AmbireTech/ice/art/directions.png

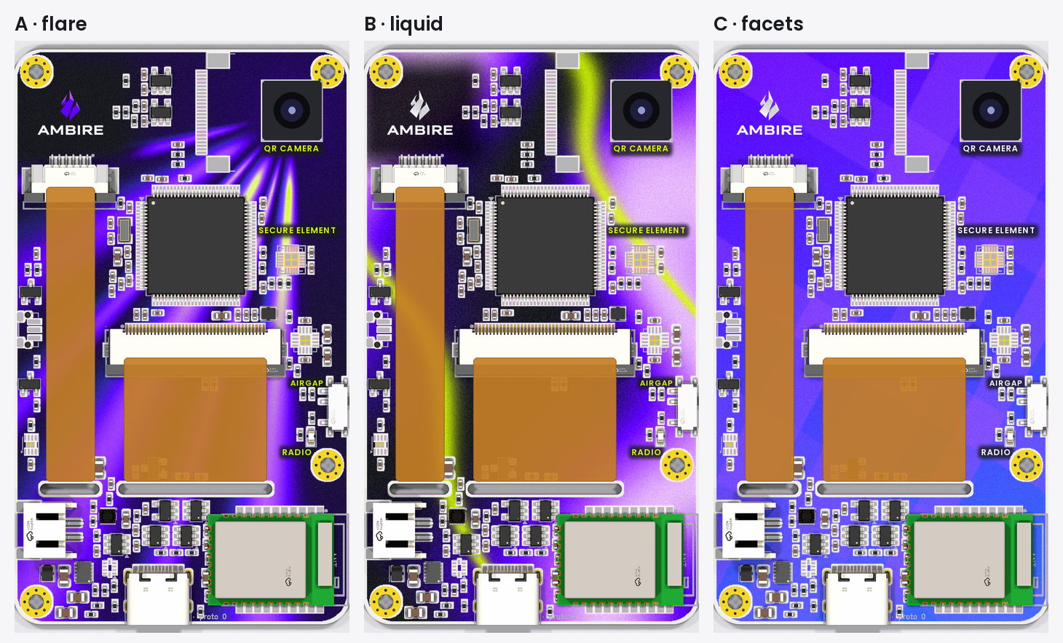
art/directions.png
