AmbireTech/ice/art/preview_back.png

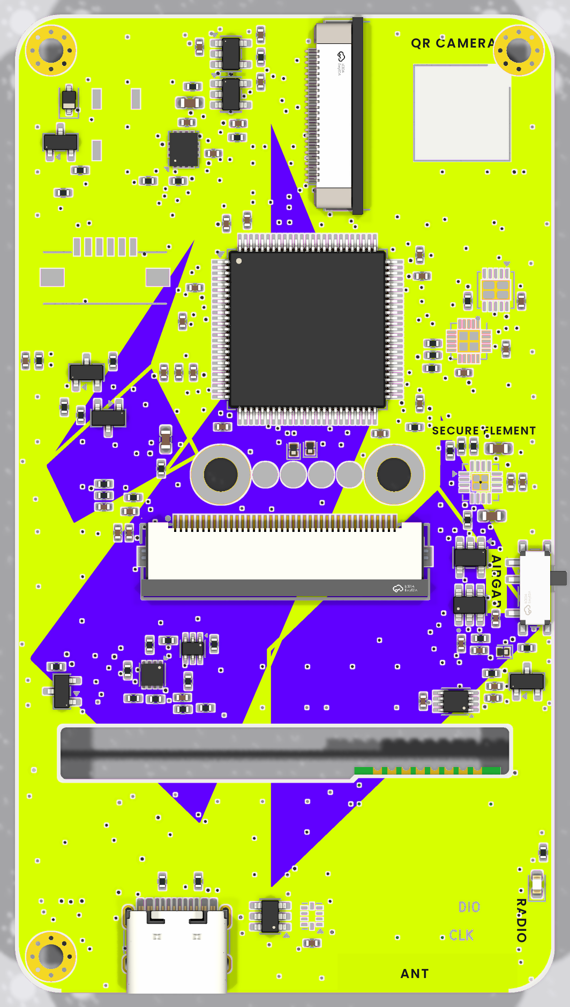
art/preview_back.png
