AmbireTech/ice/art/schemes.png

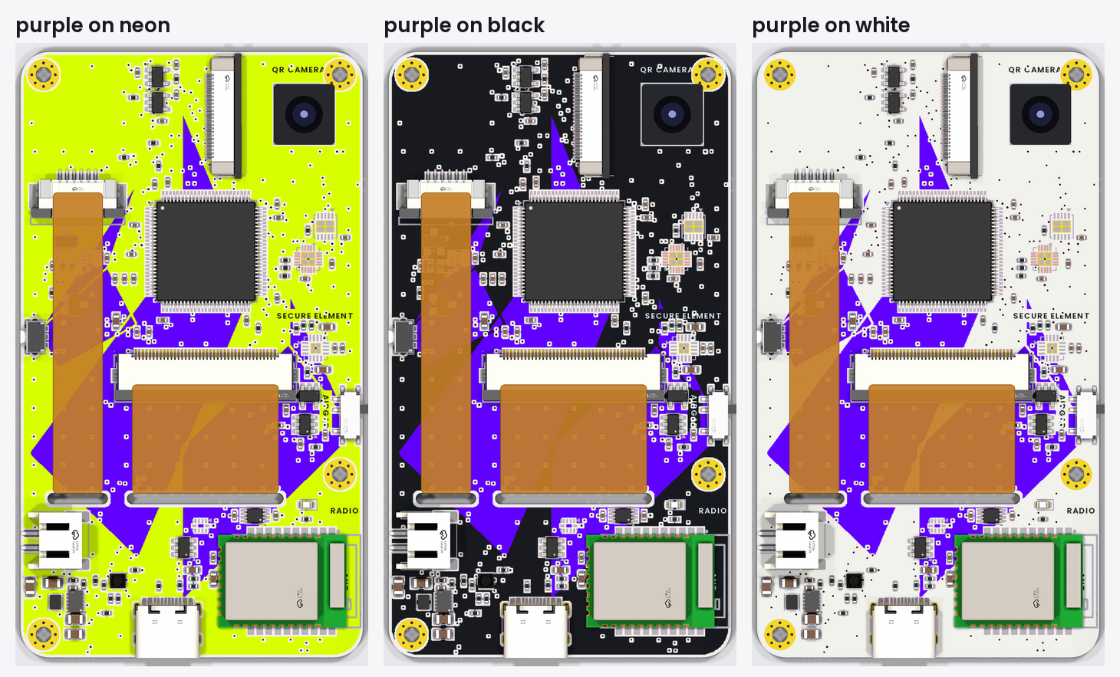
art/schemes.png
