AmbireTech/ice/docs/back-face-render.png

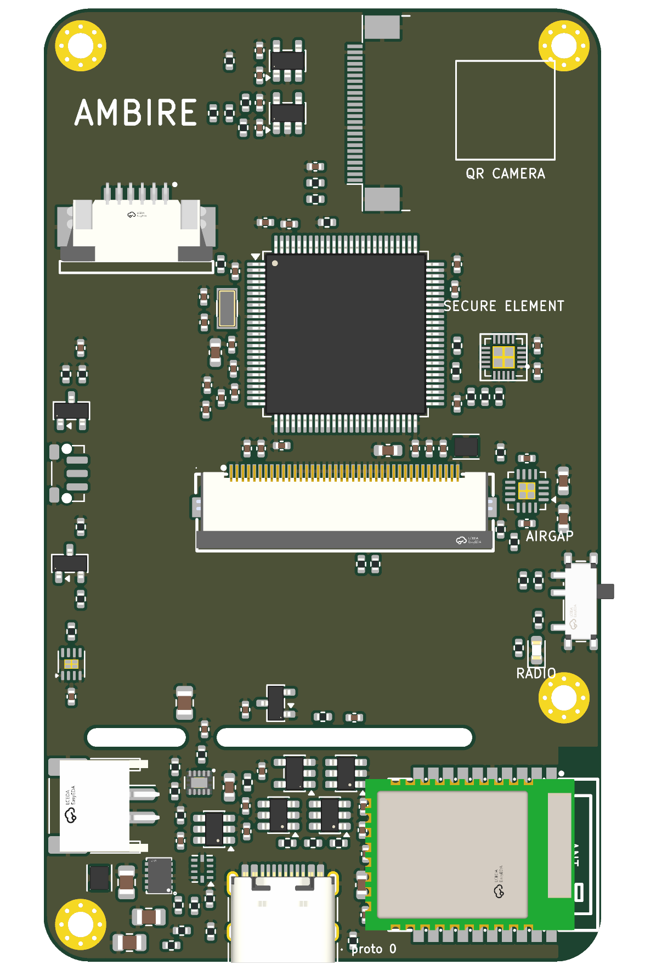
docs/back-face-render.png
