AmbireTech/ice/docs/back-face-uv.jpg

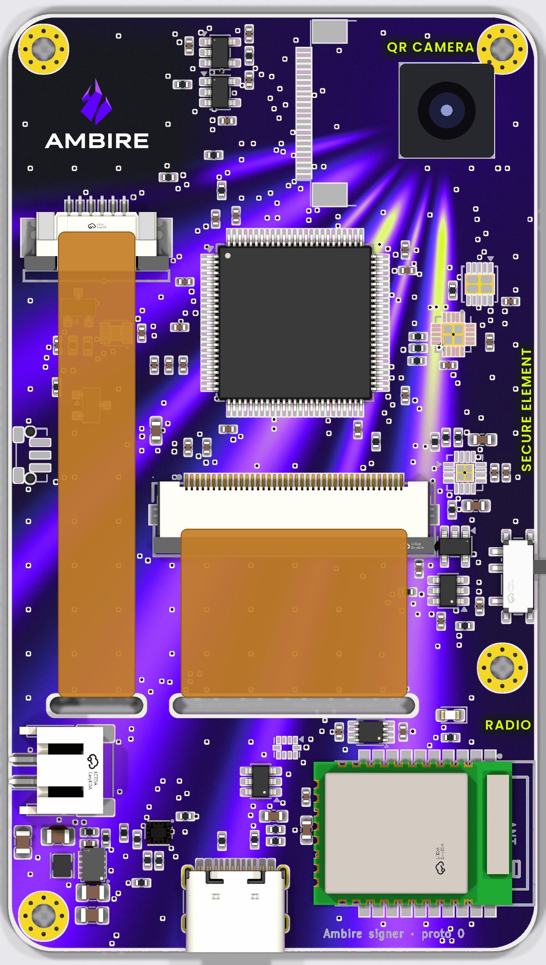
docs/back-face-uv.jpg
