AmbireTech/ice/docs/enclosure/board-back.jpg

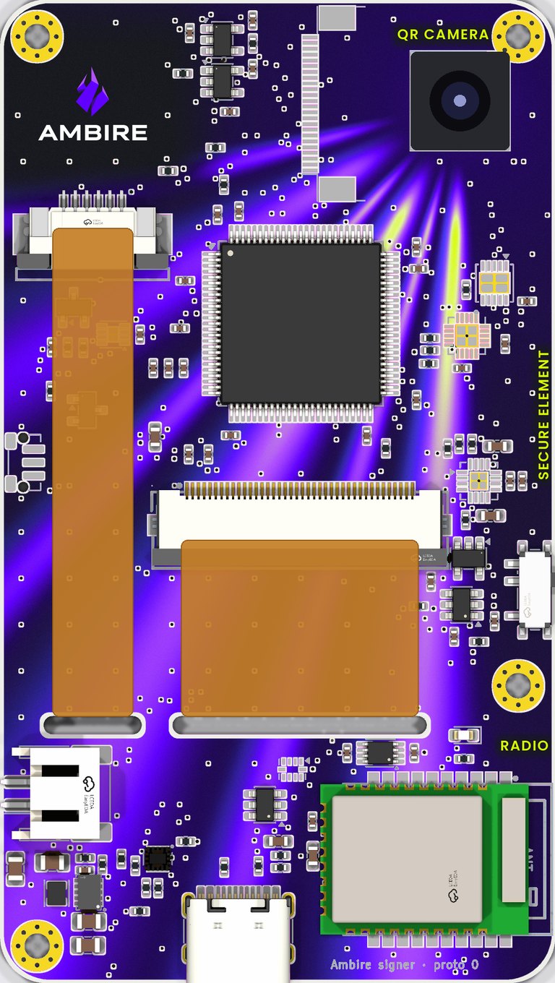
docs/enclosure/board-back.jpg
