AmbireTech/ice/docs/v4/brand/signer.webp

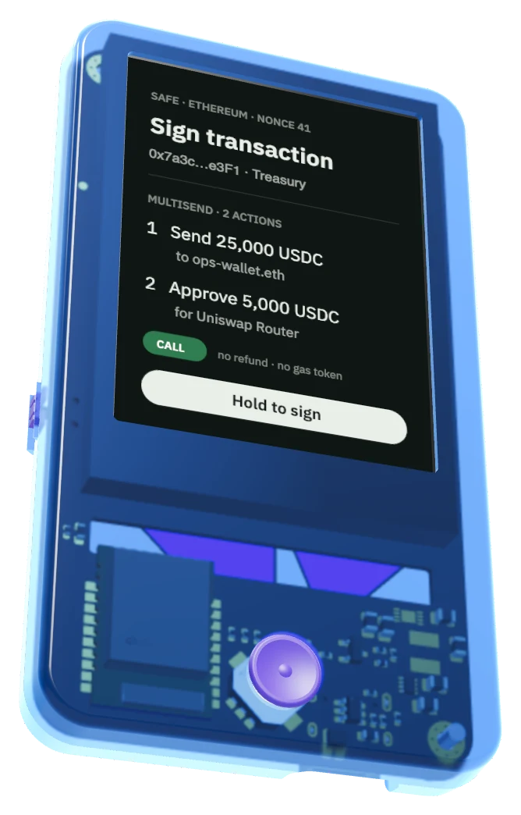
docs/v4/brand/signer.webp
