AmbireTech/ice/docs/v4/brand/silk-hero.jpg

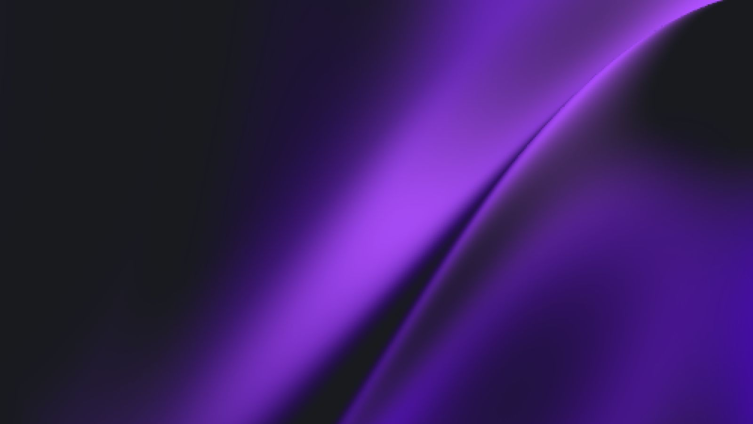
docs/v4/brand/silk-hero.jpg
