AmbireTech/ice/docs/v4/brand/silk-volt.jpg

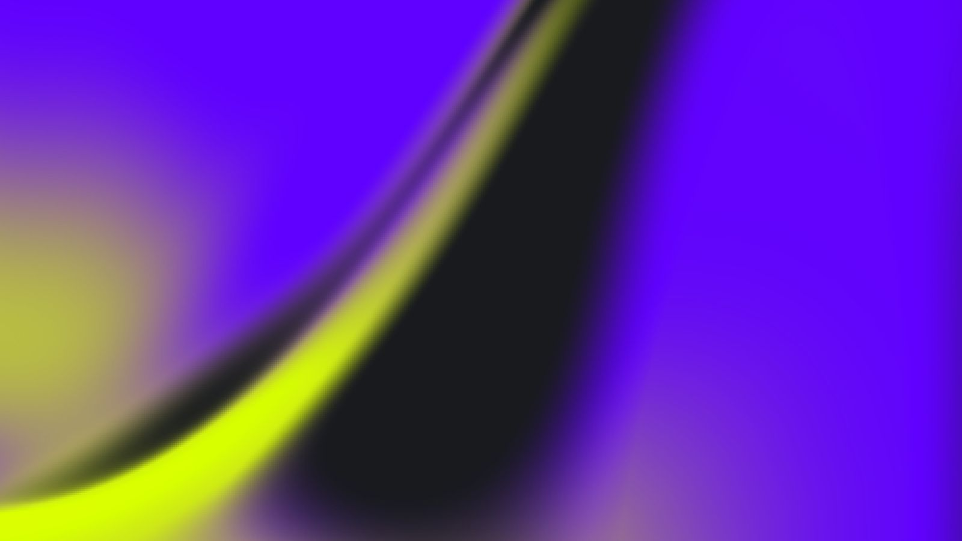
docs/v4/brand/silk-volt.jpg
