AmbireTech/ice/production/order/pcbway/ORDER-NOTES.txt

Ambire Ice proto 1 - PCBWay order notes
==========================================

PCB (upload wallet_pcbway_fab.zip)
  Layers 4 | 48.0 x 87.0 mm | thickness 1.0 mm | FR-4 | qty 10
  Surface finish: ENIG
  Solder mask: white (both sides) | silkscreen: white
  Special: full-colour UV printing on the BOTTOM side only (matte, the default)
  Min drill 0.25 mm, min track/space per the Gerbers
  Layer order: top wallet-F_Cu.gtl / wallet-In1_Cu.g1 (3.3 V plane) / wallet-In2_Cu.g2 (GND plane) /
               bottom wallet-B_Cu.gbl; outline wallet-Edge_Cuts.gm1

Tell PCBWay in the order remark
  "Full-colour UV print on the bottom side from wallet_bottom_UV_print_1200dpi.png
   (in the zip). The image covers the board outline exactly (48.0 x 87.0 mm), viewed
   from the bottom, not mirrored; see wallet_UV_positioning.png. Transparent =
   no ink. Print the bottom white silkscreen Gerber as usual; the image already
   leaves pads and holes clear. Top side: normal white silkscreen, no UV print."

Assembly (turnkey, both sides: 112 bottom + 31 top (C_3V3, C_BAT, C_BOOST, C_BOOST2, C_FFB, C_IN_BOOST, C_RADIO1, C_RADIO2, C_USB3V3, C_VBUS, L_BOOST, L_BUCK, Q_PWRJ, R_FB1, R_FB2, R_FBU1, R_FBU2, R_JA, R_JB, R_JC, R_JD, R_JPU, R_PG, R_PGB, R_PWRJB, R_PWRJBE, SW_JOY, U10, U11, U2, U3), 143 placements, 65 BOM lines)
  BOM:      wallet_bom-pcbway.csv  (manufacturer + MPN; LCSC code as distributor PN)
  Centroid: wallet_centroid-pcbway.csv  (mm, origin = outline bottom-left, as the
            Gerbers; Layer column per part; rotation in KiCad's convention, parts on the
            bottom given as seen from the top; please check orientation against
            the Gerbers / pin-1 marks)
  Not assembled (fitted by hand): PANEL (NHD-2.4-240320AF-CSXP-CTP); CAMERA (Camemake CM_DVP_GC2145_UNIVERSAL (GC2145 24-pin DVP module)); CELL (one AAA cell (NiMH, alkaline or lithium primary))

Sourcing warning
  U16 SLS32AIA010MKUSON10XTMA2: JLC/LCSC says "This product is no longer manufactured."
  Confirm availability with PCBWay or DNP these and fit later.
