AmbireTech/ice/production/jig-order/jig_bom-jlc.csv

Comment | Designator | Footprint | LCSC Part #
10uF | C_3V3P,C_TGT,C_VBUS | C_0603_1608Metric | C19702
100nF | C_AV,C_DV23,C_DV50,C_FL,C_IO1,C_IO10,C_IO22,C_IO33,C_IO42,C_IO49,C_UV | C_0402_1005Metric | C1525
1uF | C_VRI,C_VRO | C_0402_1005Metric | C52923
15pF | C_XI,C_XO | C_0402_1005Metric | C1548
USBLC6-2SC6 | D_ESD | SOT-23-6 | C7519
red | D_TGT | LED_0603_1608Metric | C2286
green | D_USB | LED_0603_1608Metric | C12624
TYPE-C-31-M-12 | J_USB | USB_C_Receptacle_HRO_TYPE-C-31-M-12_BoardEdge | C165948
YZP0063-20068-01 | P_3V3,P_GND,P_NRST,P_RSWCLK,P_RSWDIO,P_SWCLK,P_SWDIO | Xinyangze_YZP0063-20068-01 | C5157248
1k | R_BOOT,R_LT,R_LU,R_NRST,R_RSWC,R_RSWD,R_XO | R_0402_1005Metric | C11702
5.1k | R_CC1,R_CC2 | R_0402_1005Metric | C25905
100k | R_CE | R_0402_1005Metric | C25741
27 | R_DN,R_DP | R_0402_1005Metric | C25100
10k | R_RUN | R_0402_1005Metric | C25744
100 | R_SWC,R_SWD | R_0402_1005Metric | C25076
MSK12C02 | SW_PWR | SW_SPDT_Shouhan_MSK12C02 | C431540
K3-2235S-K1 | SW_SEL | SW_DPDT_Hroparts_K3-2235S-K1 | C145845
RP2040 | U1 | QFN-56-1EP_7x7mm_P0.4mm_EP3.2x3.2mm | C2040
W25Q16JVSSIQ | U2 | SOIC-8_5.3x5.3mm_P1.27mm | C131025
ME6211C33 | U_LP,U_LT | SOT-23-5 | C82942
12MHz | Y1 | Crystal_SMD_3225-4Pin_3.2x2.5mm | C20625731
