AmbireTech/ice/production/jig-order/base/jig-base_bom-jlc.csv

Comment | Designator | Footprint | LCSC Part #
SM04B-SRSS-TB | J_RAD | JST_SH_SM04B-SRSS-TB_1x04-1MP_P1.00mm_Horizontal | C160404
YZP0063-20068-01 | P_RSWCLK,P_RSWDIO | Xinyangze_YZP0063-20068-01 | C5157248
