AmbireTech/ice/docs/v4/enclosure/files/pack_bom-jlc.csv

Comment | Designator | Footprint | LCSC Part #
MY-AAA-19-J | BT_N1,BT_N2 | Battery_AAA_Clip_MYOUNG_MY-AAA-19-J | C6937104
MY-AAA-20-J | BT_P1,BT_P2 | Battery_AAA_Clip_MYOUNG_MY-AAA-20-J | C6937107
0.75A hold | F_BAT | Fuse_1206_3216Metric | C976305
YZP0048-20048-04025-03 | J_PACK | Xinyangze_YZP0048-20048-04025-03 | C5126845
10k NTC B3380 | RT_PACK | R_0603_1608Metric | C13564
1k | R_MID | R_0402_1005Metric | C11702
