AmbireTech/ice/3d/Xinyangze_YZP0063-20068-01.step

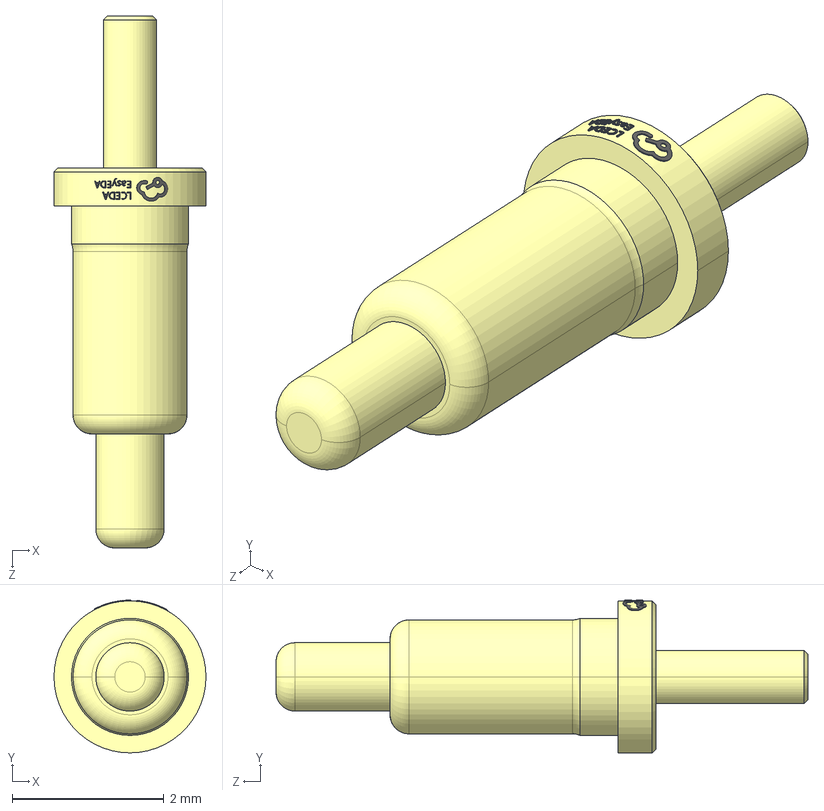
[picture p14: CAD file, 2026-11-01]
3d/Xinyangze_YZP0063-20068-01.step
2.00 x 2.01 x 7.00 mm
