AmbireTech/ice/enclosure/out/bezel.step

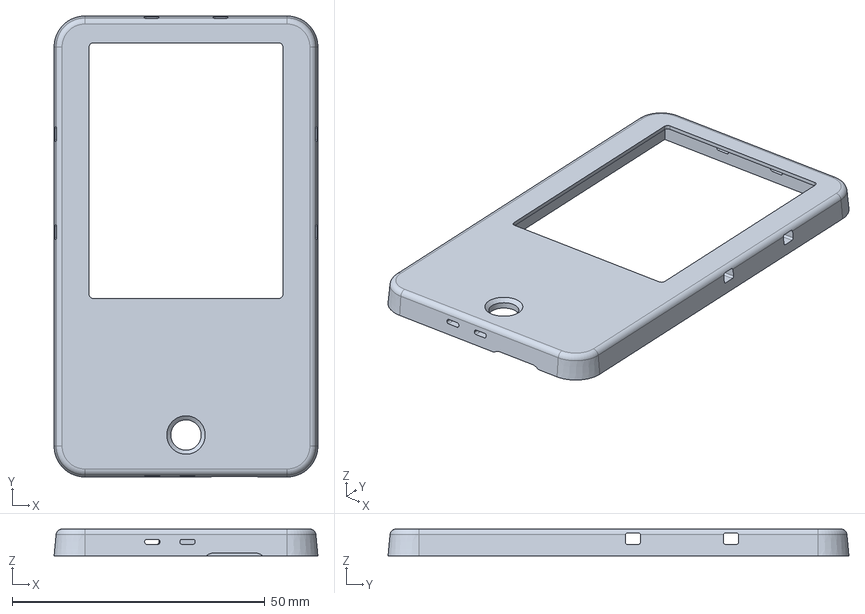
[picture p15: CAD file, 2026-11-14]
enclosure/out/bezel.step
52.2 x 91.2 x 5.33 mm
