AmbireTech/ice/jig/out/base.step

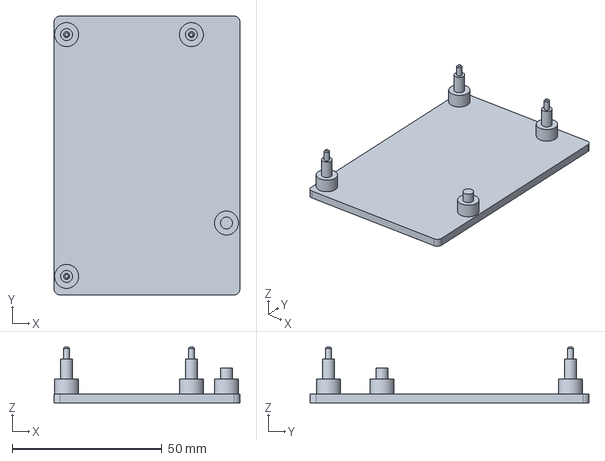
[picture p16: CAD file, 2026-11-01]
jig/out/base.step
62.0 x 93.0 x 18.6 mm
