AmbireTech/ice/pack/3d/Xinyangze_YZP0058-20048-02.step

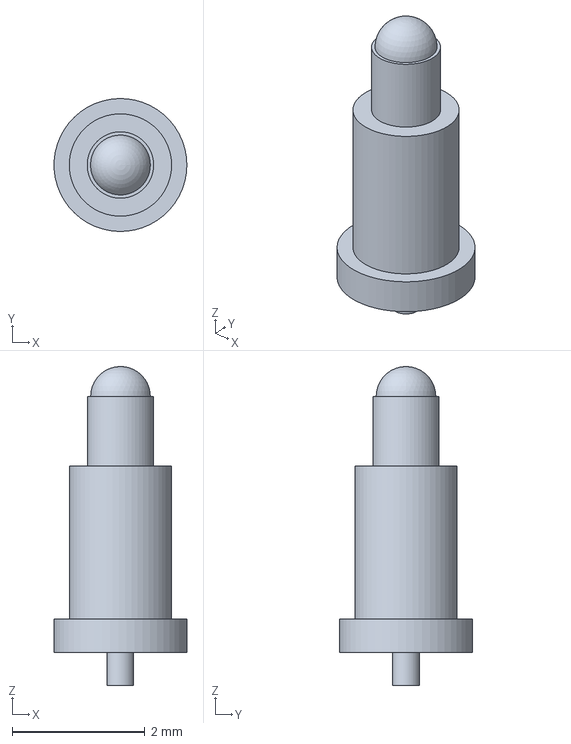
[picture p17: CAD file, 2026-11-01]
pack/3d/Xinyangze_YZP0058-20048-02.step
2.00 x 2.00 x 4.80 mm
