AmbireTech/ice/3d/MYOUNG_MY-AAA-19-J.step

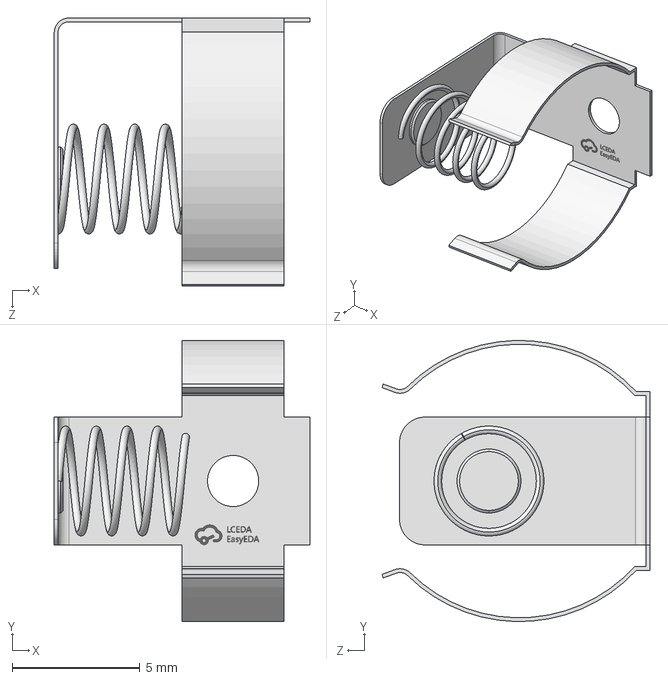
[picture p18: CAD file, 2026-10-25]
3d/MYOUNG_MY-AAA-19-J.step
10.0 x 11.0 x 10.5 mm
