AmbireTech/ice/enclosure/out/halves.3mf

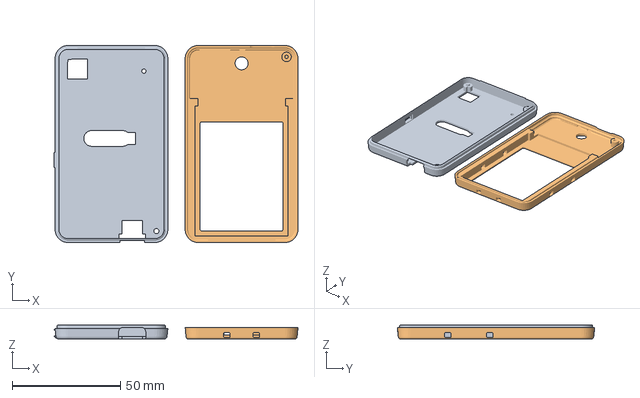
[picture p19: CAD file, 2026-11-14]
enclosure/out/halves.3mf
112.9 x 91.2 x 6.70 mm
