AmbireTech/ice/jig/out/lid.step

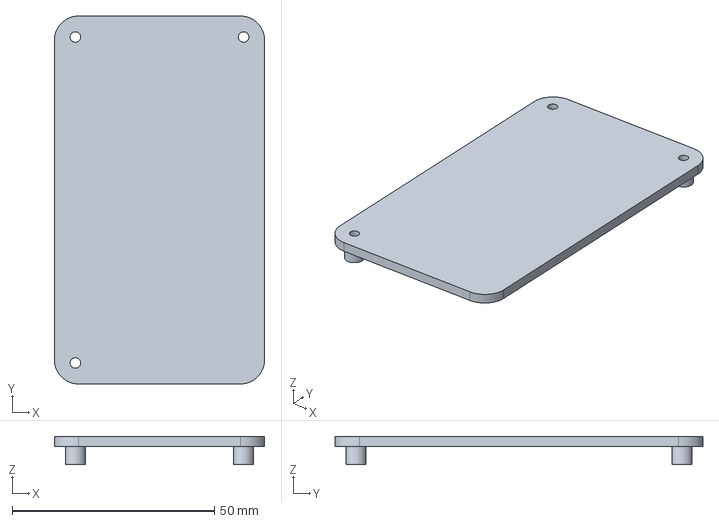
[picture p20: CAD file, 2026-11-01]
jig/out/lid.step
52.0 x 91.0 x 7.00 mm
