AmbireTech/ice/enclosure/out/case.3mf

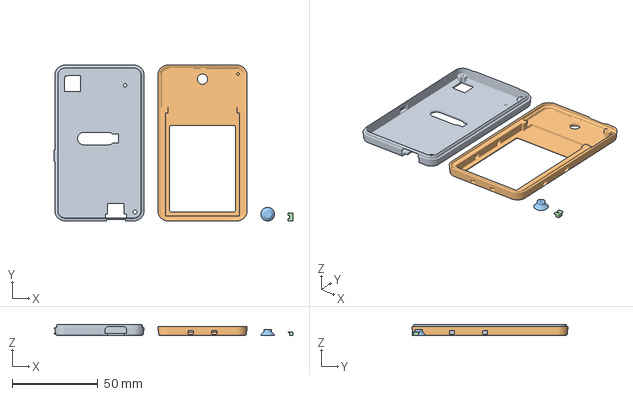
[picture p22: CAD file, 2026-11-14]
enclosure/out/case.3mf
139.7 x 91.2 x 6.70 mm
