AmbireTech/ice/3d/SW_ALPS_SKRHAAE010.step

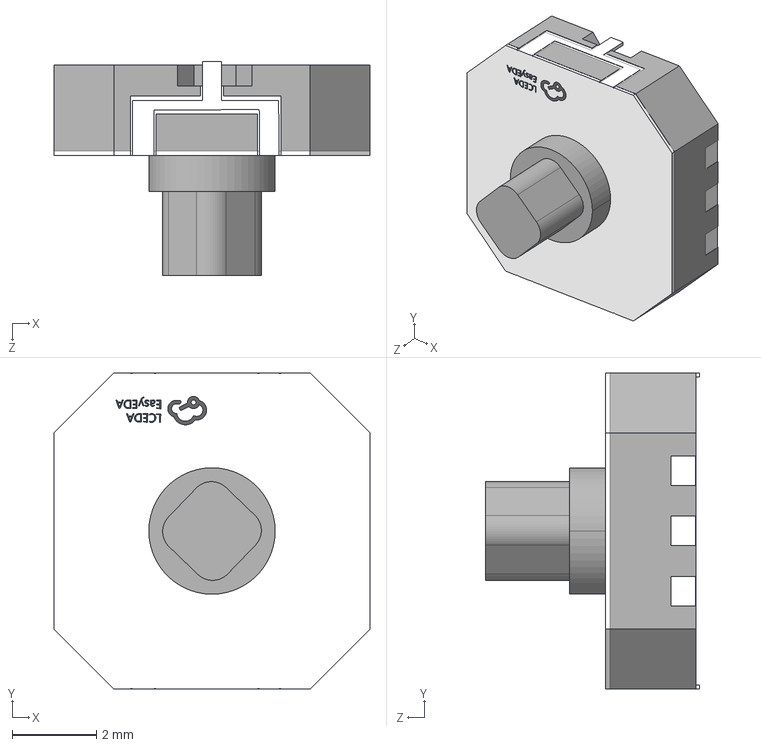
[picture p23: CAD file, 2026-10-22]
3d/SW_ALPS_SKRHAAE010.step
7.50 x 7.50 x 5.08 mm
