AmbireTech/ice/enclosure/out/shell.step

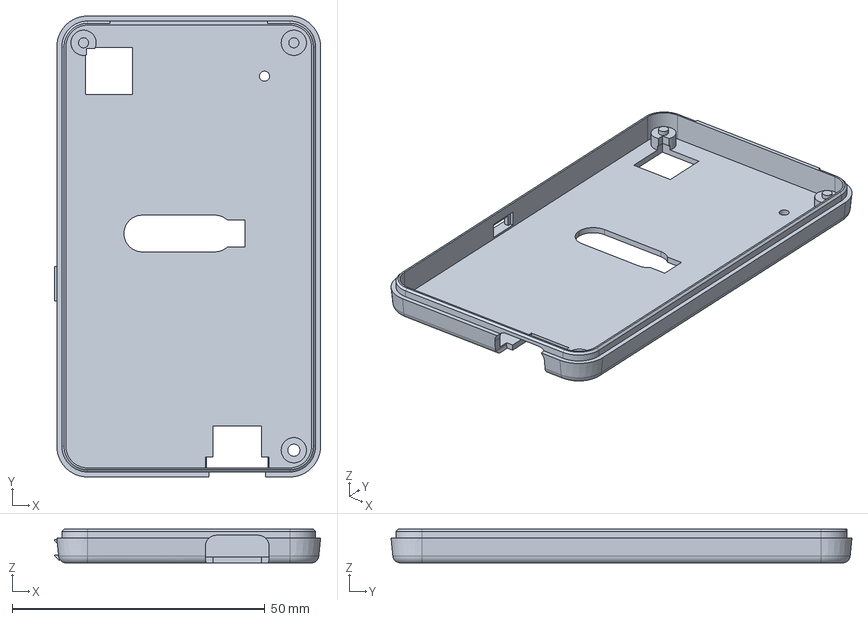
[picture p24: CAD file, 2026-11-14]
enclosure/out/shell.step
52.7 x 91.2 x 6.69 mm
