AmbireTech/ice/3d/FPC_HC-FPC-1.0-6P-CSH25.step

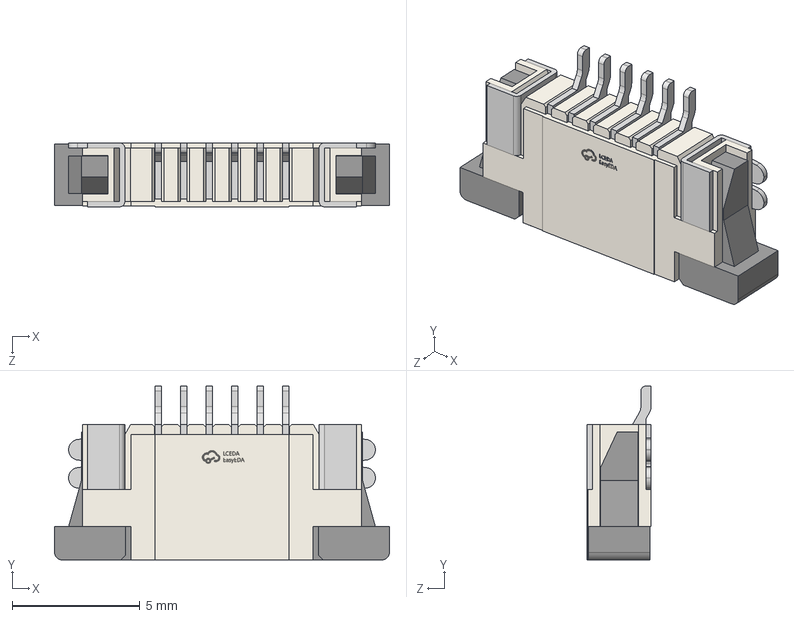
[picture p25: CAD file, 2026-10-14]
3d/FPC_HC-FPC-1.0-6P-CSH25.step
13.1 x 6.80 x 2.51 mm
