AmbireTech/ice/enclosure/out/joycap.step

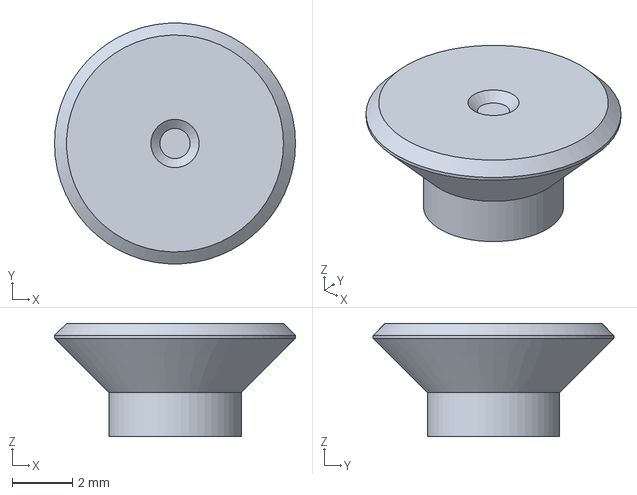
[picture p26: CAD file, 2026-11-14]
enclosure/out/joycap.step
8.00 x 7.99 x 3.76 mm
