AmbireTech/ice/3d/Molex_54132-4062.step

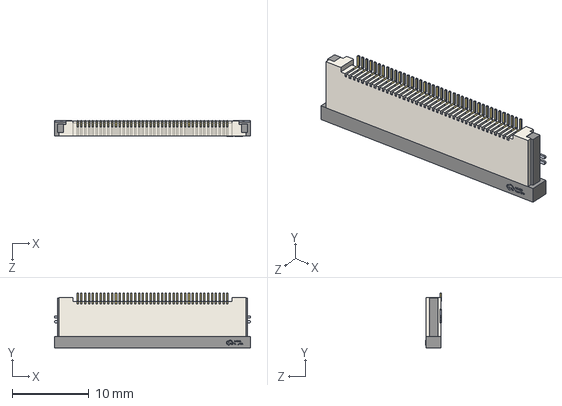
[picture p27: CAD file, 2026-10-14]
3d/Molex_54132-4062.step
25.5 x 7.15 x 2.03 mm
