AmbireTech/ice/enclosure/out/airslider.step

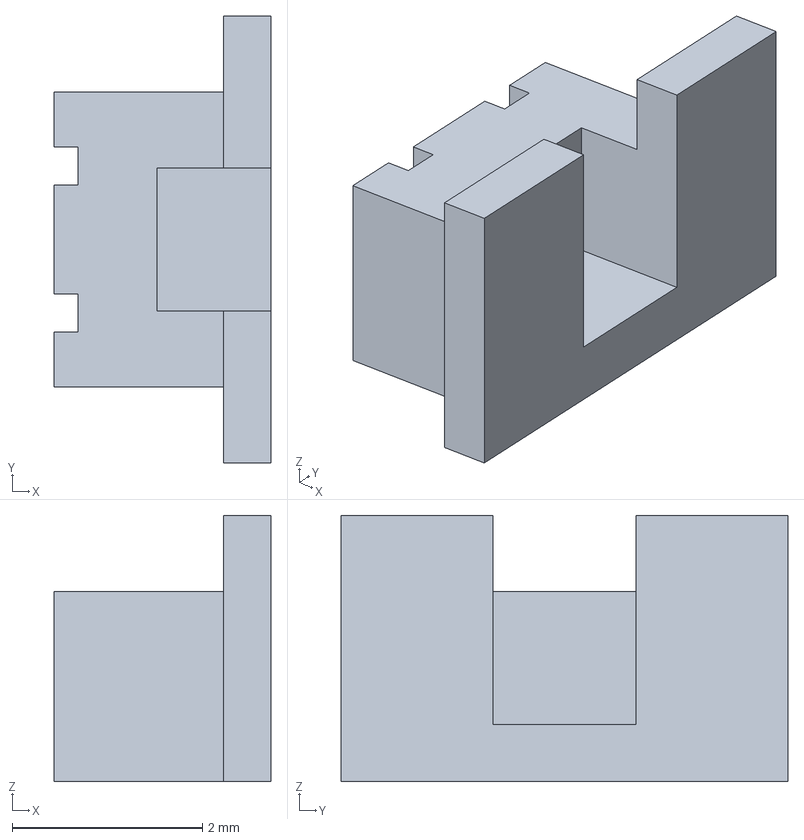
[picture p28: CAD file, 2026-11-14]
enclosure/out/airslider.step
2.28 x 4.70 x 2.80 mm
