AmbireTech/ice/enclosure/out/battery-tray.3mf

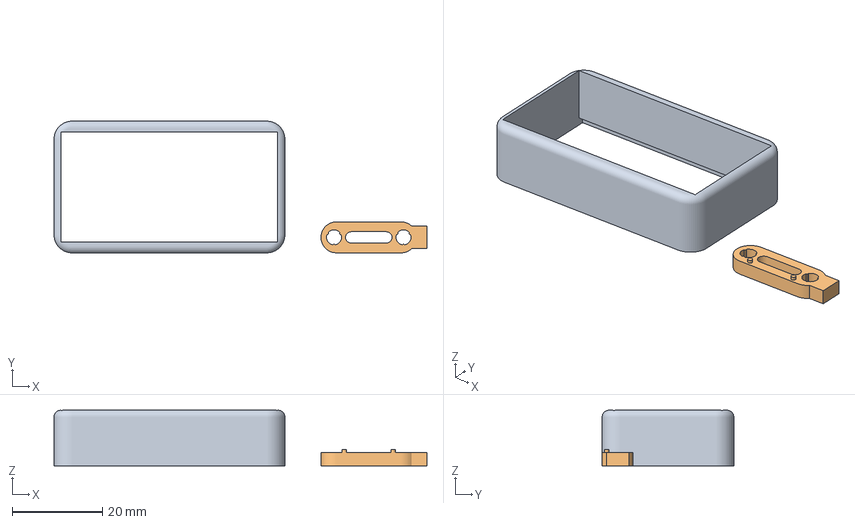
[picture p29: CAD file, 2026-11-14]
enclosure/out/battery-tray.3mf
82.7 x 29.2 x 12.3 mm
