AmbireTech/ice/enclosure/out/tray.step

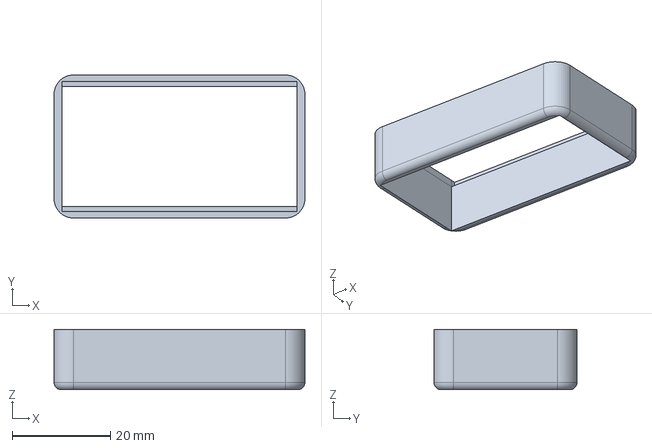
[picture p30: CAD file, 2026-11-14]
enclosure/out/tray.step
51.2 x 29.2 x 12.3 mm
