AmbireTech/ice/enclosure/out/frame.step

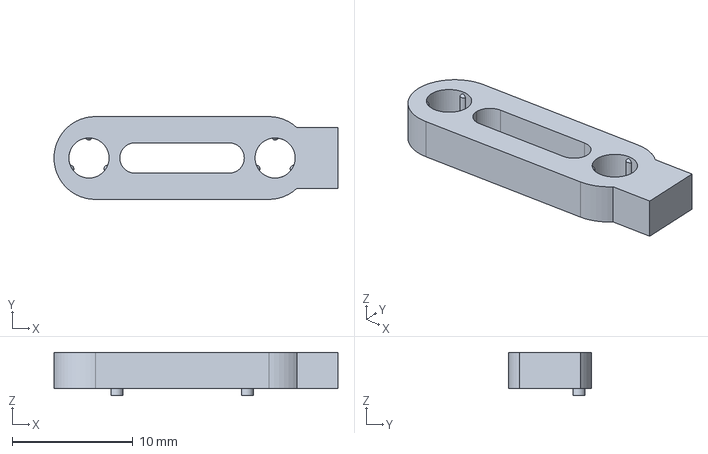
[picture p31: CAD file, 2026-11-14]
enclosure/out/frame.step
23.5 x 6.86 x 3.58 mm
