AmbireTech/ice/enclosure/out/door.step

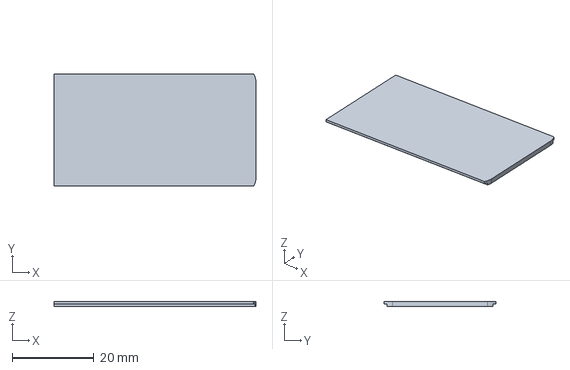
[picture p32: CAD file, 2026-10-28]
enclosure/out/door.step
49.4 x 27.5 x 1.20 mm
