AmbireTech/ice/enclosure/out/cover.step

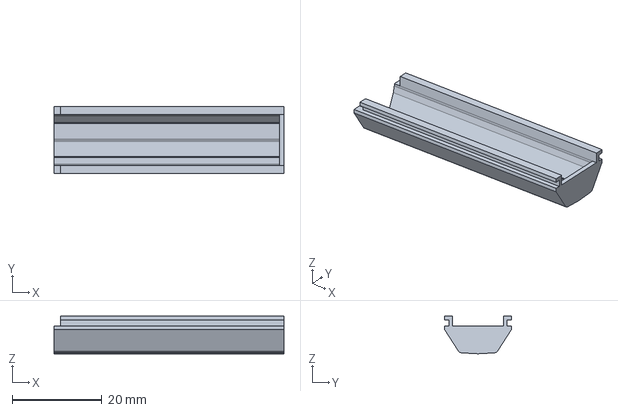
[picture p33: CAD file, 2026-10-26]
enclosure/out/cover.step
51.2 x 14.8 x 8.35 mm
