AmbireTech/ice/(list of files, cad)

Other CAD files:
enclosure/out/airslider.stl
enclosure/out/battery-tray.stl
enclosure/out/bezel.stl
enclosure/out/case.stl
enclosure/out/cover.stl
enclosure/out/door.stl
enclosure/out/frame.stl
enclosure/out/halves.stl
enclosure/out/joycap.stl
enclosure/out/shell.stl
enclosure/out/tray.stl
jig/out/base.stl
jig/out/lid.stl
