AmbireTech/ice/board/wallet.kicad_pcb

## KiCad design board/wallet.kicad_pcb (2026-11-09)

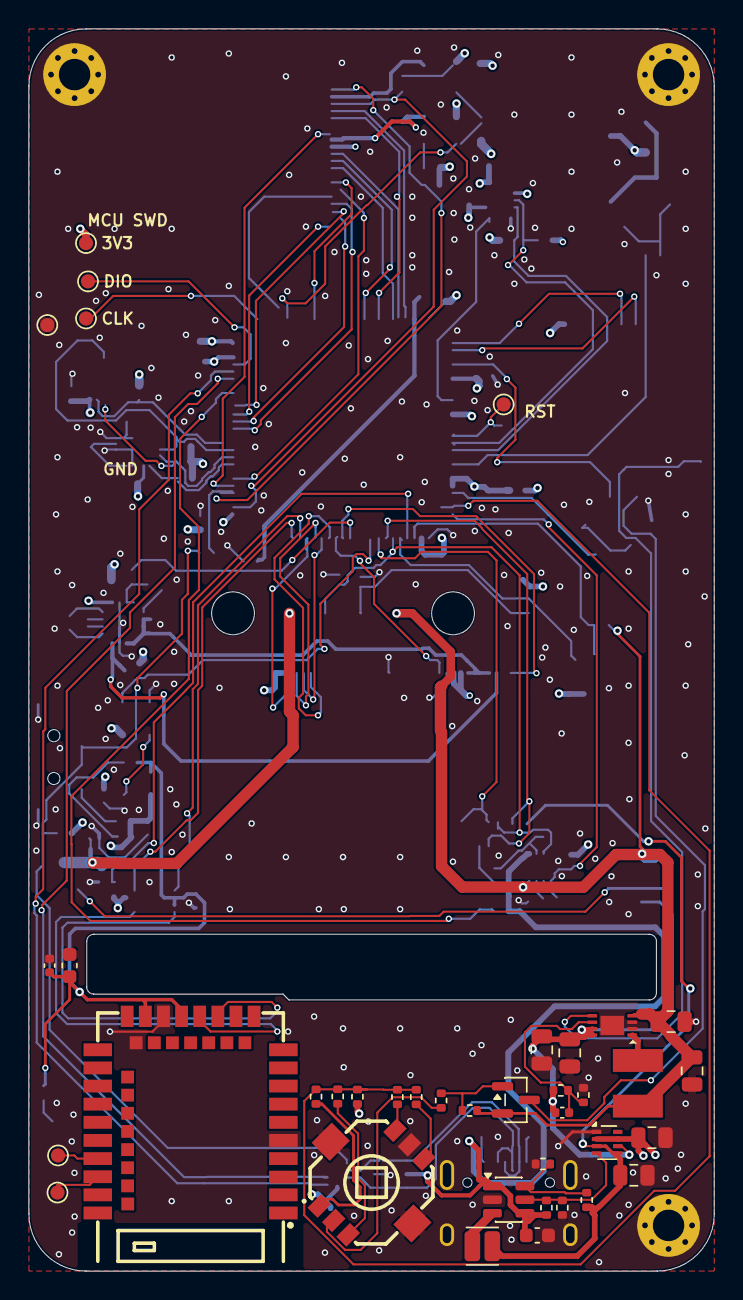
[picture p34: board wallet.kicad_pcb from above]

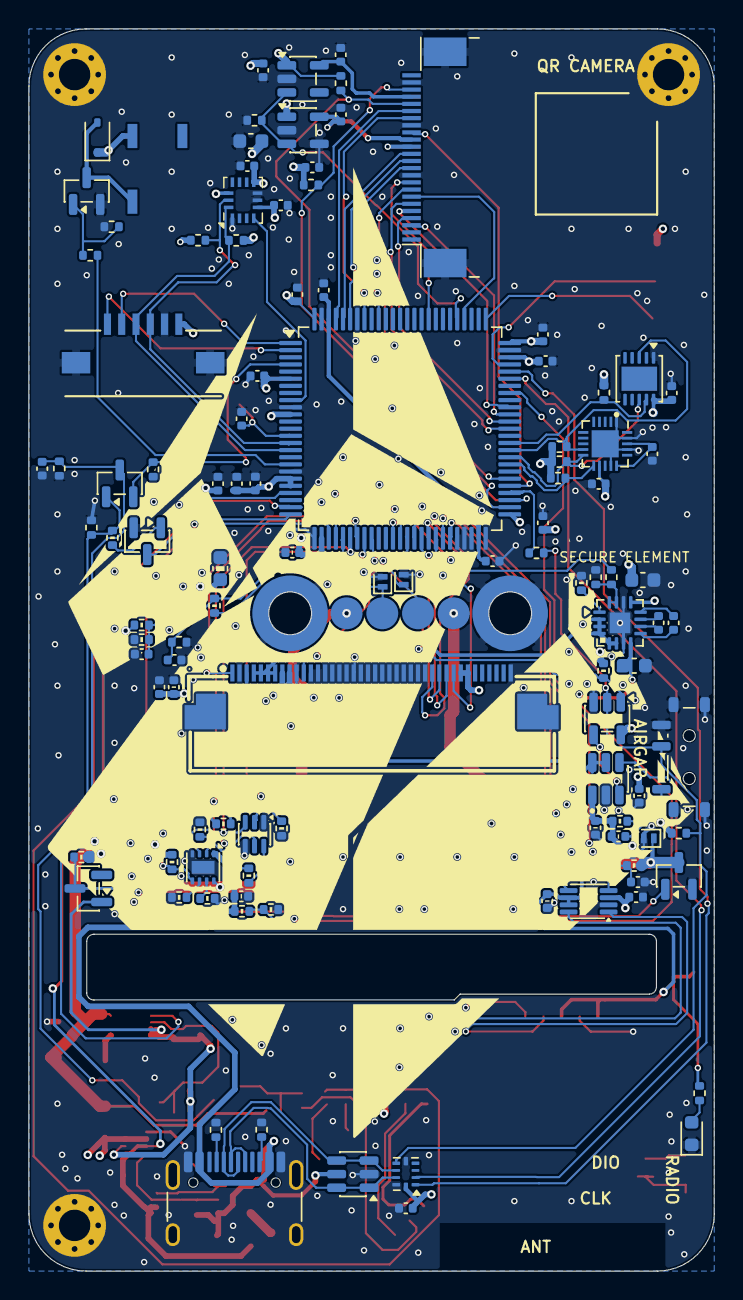
[picture p35: board wallet.kicad_pcb from below]

Board: 4 copper layers, 48.0 x 87.0 mm, 157 parts (116 on the bottom side), 108 nets.

Parts:
C_3V3: 22uF; C_0805_2012Metric
C_AVIN: 1uF; C_0402_1005Metric
C_AVOUT: 1uF; C_0402_1005Metric
C_BAT: 10uF; C_0805_2012Metric
C_BLF1, C_BLF2: 470nF; C_0402_1005Metric
C_BLIN: 1uF; C_0603_1608Metric
C_BLOUT: 1uF; C_0603_1608Metric
C_BOOST, C_BOOST2: 47uF; C_0805_2012Metric
C_BUZ: 10uF; C_0603_1608Metric
C_CHGIN: 1uF; C_0402_1005Metric
C_CNS: 100nF; C_0402_1005Metric
C_CS: 100nF; C_0402_1005Metric
C_DOVDD: 100nF; C_0402_1005Metric
C_DVOUT: 1uF; C_0402_1005Metric
C_EN: 1uF; C_0402_1005Metric
C_FFB: 33pF; C_0402_1005Metric
C_IMU1, C_IMU2: 100nF; C_0402_1005Metric
C_IN_BOOST: 22uF; C_0805_2012Metric
C_MS: 100nF; C_0402_1005Metric
C_NOR: 100nF; C_0402_1005Metric
C_NRST: 100nF; C_0402_1005Metric
C_OPT: 100nF; C_0402_1005Metric
C_RADIO1: 10uF; C_0603_1608Metric
C_RADIO2: 100nF; C_0402_1005Metric
C_RCT: 1nF; C_0402_1005Metric
C_RIN: 1uF; C_0402_1005Metric
C_SEIN: 100nF; C_0402_1005Metric
C_SEVCC: 100nF; C_0402_1005Metric
C_TFT1: 1uF; C_0402_1005Metric
C_TFT2: 100nF; C_0402_1005Metric
C_U9A, C_U9B: 100nF; C_0402_1005Metric
C_USB3V3: 22uF; C_0805_2012Metric
C_USBSW: 100nF; C_0402_1005Metric
C_VBAT: 100nF; C_0402_1005Metric
C_VBUS: 4.7uF; C_0603_1608Metric
C_VDD1, C_VDD2, C_VDD3, C_VDD4, C_VDD5: 100nF; C_0402_1005Metric
C_VDD11A, C_VDD11B: 2.2uF; C_0402_1005Metric
C_VDDA1: 1uF; C_0402_1005Metric
C_VDDA2: 100nF; C_0402_1005Metric
C_VDDB: 10uF; C_0603_1608Metric
C_VUSB: 100nF; C_0402_1005Metric
D_BUZ: 1N4148WS; D_SOD-323
D_ESD: USBLC6-2SC6; SOT-23-6
D_OR: BAT54C,215; SOT-23
D_PKMID: PESD5V0S1BL,315; D_SOD-882
D_PKNEG: PESD5V0S1BL,315; D_SOD-882
D_PKNTC: PESD5V0S1BL,315; D_SOD-882
D_RADIO: KT-0603G; LED_0603_1608Metric
D_REVG: BAS116,215; SOT-23
H1, H2, H4: MountingHole_2.2mm_M2_Pad_Via
J1: TYPE-C-31-M-12; USB_C_Receptacle_HRO_TYPE-C-31-M-12_BoardEdge
J_CAM: AFC07-S24FCA-00; Jushuo_AFC07-S24FCA-00_1x24-1MP_P0.50_Horizontal
J_CTP: HC-FPC-1.0-6P-FH20; FPC_HC-FPC-1.0-6P-FH20
J_PK1: J_PK1; Pack_Contact_Pad_D2.235mm
J_PK2: J_PK2; Pack_Contact_Pad_D2.235mm
J_PK3: J_PK3; Pack_Contact_Pad_D2.235mm
J_PK4: J_PK4; Pack_Contact_Pad_D2.235mm
J_TFT: 54132-4062; Molex_54132-4062
LS1: MLT-5020; Buzzer_Huaneng_MLT-5020_5x5.5mm
L_BOOST: WPN4020H2R2MT; L_Sunlord_WPN4020
L_BUCK: CKCSA201610-2.2uH/M; L_Cenker_CKCS201610
MH_PK1, MH_PK2: 9774015243R; Wurth_WA-SMSI_M2_L1.5
Q_BTN: MMBT3904; SOT-23
Q_BUZ: AO3416; SOT-23
Q_CHG: 2N7002DW-7-F; SOT-363_SC-70-6
Q_PWRJ: MMBT3906; SOT-23
Q_REV: AO3416; SOT-23
R_AIRPU: 100k; R_0402_1005Metric
R_AIRS: 1M; R_0402_1005Metric
R_AIRSER: 1k; R_0402_1005Metric
R_BLEN: 1k; R_0402_1005Metric
R_BLPD: 100k; R_0402_1005Metric
R_BLSET: 6.8k; R_0402_1005Metric
R_BTN: 100k; R_0402_1005Metric
R_BTNB: 100k; R_0402_1005Metric
R_BUZG: 100; R_0402_1005Metric
R_BUZPD: 100k; R_0402_1005Metric
R_CAMEN: 100k; R_0402_1005Metric
R_CC1, R_CC2: 5.1k; R_0402_1005Metric
R_CHGHI: 100k; R_0402_1005Metric
R_CHGOFF: 100k; R_0402_1005Metric
R_CNS: 100k; R_0402_1005Metric
R_CS1, R_CS2: 1M; R_0402_1005Metric
R_CSCL: 4.7k; R_0402_1005Metric
R_CSDA: 4.7k; R_0402_1005Metric
R_EN: 1M; R_0402_1005Metric
R_FB1: 1M; R_0402_1005Metric
R_FB2: 562k; R_0402_1005Metric
R_FBU1: 150k; R_0402_1005Metric
R_FBU2: 33k; R_0402_1005Metric
R_HOLD: 1M; R_0402_1005Metric
R_ISET: 3.6k; R_0402_1005Metric
R_ISETH: 1.8k; R_0402_1005Metric
R_JA: 15k; R_0402_1005Metric
R_JB: 27k; R_0402_1005Metric
R_JC: 47k; R_0402_1005Metric
R_JD: 100k; R_0402_1005Metric
R_JPU: 15k; R_0402_1005Metric
R_MS1, R_MS2: 1M; R_0402_1005Metric
R_OPTRST: 100k; R_0402_1005Metric
R_PG: 150k; R_0402_1005Metric
R_PGB: 100k; R_0402_1005Metric
R_PWRJB: 100k; R_0402_1005Metric
R_PWRJBE: 1M; R_0402_1005Metric
R_REVG: 1M; R_0402_1005Metric
R_RLED: 1k; R_0402_1005Metric
R_ROFF: 100k; R_0402_1005Metric
R_SCL: 4.7k; R_0402_1005Metric
R_SDA: 4.7k; R_0402_1005Metric
R_SEENA: 100k; R_0402_1005Metric
R_SESCL: 4.7k; R_0402_1005Metric
R_SESDA: 4.7k; R_0402_1005Metric
R_STAT: 10k; R_0402_1005Metric
R_TMR: 36k; R_0402_1005Metric
R_VB1: 47k; R_0402_1005Metric
R_VB2: 100k; R_0402_1005Metric
R_VSET: 36k; R_0402_1005Metric
SW_AIR: MSK12C02; SW_SPDT_Shouhan_MSK12C02
SW_JOY: SKRHAAE010; SW_ALPS_SKRHAAE010
TP_3V3: TP_3V3; TestPoint_Pad_D1.0mm
TP_GND: TP_GND; TestPoint_Pad_D1.0mm
TP_NRST: TP_NRST; TestPoint_Pad_D1.0mm
TP_RSWCLK: TP_RSWCLK; TestPoint_Pad_D1.0mm
TP_RSWDIO: TP_RSWDIO; TestPoint_Pad_D1.0mm
TP_SWCLK: TP_SWCLK; TestPoint_Pad_D1.0mm
TP_SWDIO: TP_SWDIO; TestPoint_Pad_D1.0mm
U1: BQ25172DSGR; WSON-8-1EP_2x2mm_P0.5mm_EP0.9x1.6mm
U2: LTC3539EDCB-2#TRPBF; LT_DCB8_DFN-8-1EP_2x3mm_P0.45mm
U3: TLV62569PDDCR; SOT-23-6
U4: STM32U585VIT6Q; LQFP-100_14x14mm_P0.5mm
U5: SE050E2HQ1/Z01Z3Z; NXP_SOT1969-1_HX2QFN-20_3x3mm_P0.4mm
U6: TS3USB221ARSER; Texas_UQFN-10_1.5x2mm_P0.5mm
U7: SN74LVC1G02DBVR(UMW); SOT-23-5
U8: TPS22917DBVR; SOT-23-6_PinMarkSouth
U9: TXU0202DCUR; VSSOP-8_2.3x2mm_P0.5mm
U10: TPS2116DRLR; SOT-583-8
U11: E73-2G4M08S1C; Ebyte_E73-2G4M08S1C
U12: ME6211C28M5G-N; SOT-23-5
U13: TPS60230RGTR; VQFN-16-1EP_3x3mm_P0.5mm_EP1.45x1.45mm
U14: TLV70312DBVR; SOT-23-5
U15: BMI270; Bosch_LGA-14_3x2.5mm_P0.5mm
U16: SLS32AIA010MK; DFN-10-1EP_3x3mm_P0.5mm_EP1.7x2.5mm

Connections:
AIRGAP: R_AIRPU.1, R_AIRS.1, SW_AIR.2, U6.6, U7.2
AIRGAP_SENSE: R_AIRS.2, U4.54
AIR_THROW: R_AIRSER.1, SW_AIR.1
BAT: C_BAT.1, C_IN_BOOST.1, J_PK1.1, L_BOOST.1, Q_PWRJ.2, R_CS1.1, R_PWRJBE.1, R_REVG.1, U1.8, U2.4
BAT_N: D_PKNEG.1, J_PK4.1, Q_REV.3, R_CNS.1
BL_A: C_BLOUT.1, J_TFT.3, U13.8
BL_C1N: C_BLF1.2, U13.11
BL_C1P: C_BLF1.1, U13.10
BL_C2N: C_BLF2.2, U13.12
BL_C2P: C_BLF2.1, U13.9
BL_EN: R_BLEN.2, R_BLPD.1, U13.15, U13.16
BL_ISET: R_BLSET.1, U13.1
BL_K: J_TFT.4, J_TFT.5, J_TFT.6, J_TFT.7, U13.2, U13.3, U13.4, U13.5, U13.6
BTN: D_OR.1, Q_PWRJ.3, R_BTN.1, R_BTNB.1
BTN_B: Q_BTN.1, R_BTNB.2
BTN_N: Q_BTN.3, U4.22
BUZZER: R_BUZG.1, U4.18
BUZ_G: Q_BUZ.1, R_BUZG.2, R_BUZPD.1
BUZ_SW: D_BUZ.2, LS1.2, Q_BUZ.3
CAM_AVDD: C_AVOUT.1, J_CAM.21, U12.5
CAM_D0: J_CAM.6, U4.63
CAM_D1: J_CAM.4, U4.64
CAM_D2: J_CAM.3, U4.65
CAM_D3: J_CAM.5, U4.66
CAM_D4: J_CAM.7, U4.79
CAM_D5: J_CAM.9, U4.84
CAM_D6: J_CAM.11, U4.95
CAM_D7: J_CAM.13, U4.96
CAM_DVDD: C_DVOUT.1, J_CAM.15, U14.5
CAM_EN: R_CAMEN.1, U4.80, U12.3, U14.3
CAM_HREF: J_CAM.16, U4.55
CAM_PCLK: J_CAM.8, U4.56
CAM_RST: J_CAM.19, U4.97
CAM_SCL: J_CAM.20, R_CSCL.1, U4.52
CAM_SDA: J_CAM.22, R_CSDA.1, U4.53
CAM_VSYNC: J_CAM.18, U4.93
CAM_XCLK: J_CAM.12, U4.91
CC1: J1.A5, R_CC1.1
CC2: J1.B5, R_CC2.1
CELL_MID: D_PKMID.1, J_PK2.1, R_MS1.1
CELL_MID_SENSE: C_MS.1, R_MS1.2, R_MS2.1, U4.30
CELL_N_SENSE: C_CNS.1, R_CNS.2, U4.29
CELL_SENSE: C_CS.1, R_CS1.2, R_CS2.1, U4.28
CHG_HI: Q_CHG.2, R_CHGHI.1, U4.33
CHG_ISET: R_ISET.1, R_ISETH.1, U1.2
CHG_ISETH: Q_CHG.6, R_ISETH.2
CHG_OFF: Q_CHG.5, R_CHGOFF.1, U4.32
CHG_STAT: R_STAT.1, U1.5, U4.25
CHG_TMR: R_TMR.1, U1.6
CHG_TS: D_PKNTC.1, J_PK3.1, Q_CHG.3, U1.3, U4.31
CHG_VSET: R_VSET.1, U1.7
CTP_INT: J_CTP.5, U4.1
CTP_RST: J_CTP.6, U4.2
FB_BOOST: C_FFB.2, R_FB1.2, R_FB2.1, U2.6
FB_USB: R_FBU1.2, R_FBU2.1, U3.6
GND: C_3V3.2, C_AVIN.2, C_AVOUT.2, C_BAT.2, C_BLIN.2, C_BLOUT.2, C_BOOST.2, C_BOOST2.2, C_BUZ.2, C_CHGIN.2, C_CNS.2, C_CS.2, C_DOVDD.2, C_DVOUT.2, C_EN.2, C_IMU1.2, C_IMU2.2, C_IN_BOOST.2, C_MS.2, C_NOR.2, C_NRST.2, C_OPT.2, C_RADIO1.2, C_RADIO2.2, C_RIN.2, C_SEIN.2, C_SEVCC.2, C_TFT1.2, C_TFT2.2, C_U9A.2, C_U9B.2, C_USB3V3.2, C_USBSW.2, C_VBAT.2, C_VBUS.2, C_VDD1.2, C_VDD2.2, C_VDD3.2, C_VDD4.2, C_VDD5.2, C_VDD11A.2, C_VDD11B.2, C_VDDA1.2, C_VDDA2.2, C_VDDB.2, C_VUSB.2, D_ESD.2, D_PKMID.2, D_PKNEG.2, D_PKNTC.2, D_RADIO.1, H1.1, H2.1, H4.1, J1.A1, J1.A12, J1.B1, J1.B12, J1.SH, J_CAM.10, J_CAM.17, J_CAM.23, J_CAM.MP, J_CTP.2, J_CTP.7, J_CTP.8, J_TFT.2, J_TFT.10, J_TFT.12, J_TFT.13, J_TFT.14, J_TFT.15, J_TFT.16, J_TFT.17, J_TFT.18, J_TFT.19, J_TFT.20, J_TFT.21, J_TFT.22, J_TFT.23, J_TFT.24, J_TFT.25, J_TFT.26, J_TFT.27, J_TFT.28, J_TFT.40, J_TFT.41, J_TFT.42, MH_PK1.1, MH_PK2.1, Q_BTN.2, Q_BUZ.2, Q_CHG.1, Q_CHG.4, Q_REV.2, R_BLPD.2, R_BLSET.2, R_BTN.2, R_BUZPD.2, R_CAMEN.2, R_CC1.2, R_CC2.2, R_CHGHI.2, R_CS2.2, R_EN.2, R_FB2.2, R_FBU2.2, R_HOLD.2, R_ISET.2, R_MS2.2, R_PGB.2, R_TMR.2, R_VB2.2, R_VSET.2, SW_AIR.3, SW_AIR.SH, SW_JOY.5, SW_JOY.7, SW_JOY.8, TP_GND.1, U1.4, U1.9, U2.2, U2.3, U2.9, U3.2, U4.10, U4.19, U4.26, U4.46, U4.47, U4.48, U4.50, U4.74, U4.94, U4.99, U5.1, U5.14, U5.17, U5.19, U5.21, U6.5, U6.9, U7.3, U8.2, U9.2, U10.1, U11.5, U11.21, U11.24, U12.2, U13.7, U13.14, U13.17, U14.2, U14.4, U15.1, U15.6, U15.7, U16.1
I2C_SCL: J_CTP.3, R_SCL.1, U4.15, U15.13
I2C_SDA: J_CTP.4, R_SDA.1, U4.16, U15.14
IMU_INT: U4.9, U15.4
JOY_A: R_JA.2, SW_JOY.1
JOY_B: R_JB.2, SW_JOY.4
JOY_C: R_JC.2, SW_JOY.3
JOY_CEN: R_PWRJB.2, SW_JOY.2
JOY_D: R_JD.2, SW_JOY.6
JOY_DIR: R_JA.1, R_JB.1, R_JC.1, R_JD.1, R_JPU.2, U4.24
NRST: C_NRST.1, TP_NRST.1, U4.14
OPTIGA_RST: R_OPTRST.1, U4.61, U16.9
PWRJ_B: Q_PWRJ.1, R_PWRJB.1, R_PWRJBE.2
PWR_EN: C_EN.1, D_OR.3, R_EN.1, U2.5
PWR_HOLD: D_OR.2, R_HOLD.1, U4.4
RADIO_3V3: C_RADIO1.1, C_RADIO2.1, C_U9B.1, R_RLED.1, U8.5, U8.6, U9.6, U9.7, U11.19, U11.23
RADIO_CT: C_RCT.2, U8.4
RADIO_EN: U7.4, U8.3
RADIO_LED_A: D_RADIO.2, R_RLED.2
RADIO_OFF: R_ROFF.1, U4.34, U7.1
RADIO_RX: U9.8, U11.15
RADIO_RXD_MCU: U4.45, U9.4
RADIO_SWCLK: TP_RSWCLK.1, U11.39
RADIO_SWDIO: TP_RSWDIO.1, U11.37
RADIO_TX: U9.1, U11.17
RADIO_TXD_MCU: U4.44, U9.5
REV_G: D_REVG.3, Q_REV.1, R_REVG.2
SE_ENA: R_SEENA.1, U4.58, U5.11
SE_SCL: R_SESCL.1, U4.59, U5.10, U16.8
SE_SDA: R_SESDA.1, U4.60, U5.9, U16.3
SE_VCC: C_SEVCC.1, U5.15, U5.18
SWCLK: TP_SWCLK.1, U4.76
SWDIO: TP_SWDIO.1, U4.72
SW_BOOST: L_BOOST.2, U2.1
SW_USB: L_BUCK.1, U3.3
TFT_BL: R_BLEN.1, U4.37
TFT_CS: J_TFT.31, U4.42
TFT_DC: J_TFT.29, U4.40
TFT_MOSI: J_TFT.32, U4.43
TFT_RST: J_TFT.11, U4.39
TFT_SCK: J_TFT.30, U4.41
TFT_TE: J_TFT.1, U4.38
USB_DN: D_ESD.3, D_ESD.4, J1.A7, J1.B7, U6.7
USB_DP: D_ESD.1, D_ESD.6, J1.A6, J1.B6, U6.8
USB_MCU_DN: U4.70, U6.2
USB_MCU_DP: U4.71, U6.1
USB_PG: R_PG.1, R_PGB.1, U3.5, U10.4
V3V3: C_3V3.1, C_AVIN.1, C_BLIN.1, C_BUZ.1, C_DOVDD.1, C_IMU1.1, C_IMU2.1, C_NOR.1, C_OPT.1, C_RCT.1, C_RIN.1, C_SEIN.1, C_TFT1.1, C_TFT2.1, C_U9A.1, C_USBSW.1, C_VBAT.1, C_VDD1.1, C_VDD2.1, C_VDD3.1, C_VDD4.1, C_VDD5.1, C_VDDA1.1, C_VDDA2.1, C_VDDB.1, C_VUSB.1, D_BUZ.1, J_CAM.14, J_CTP.1, J_TFT.8, J_TFT.9, J_TFT.33, J_TFT.34, LS1.1, R_AIRPU.2, R_AIRSER.2, R_CSCL.2, R_CSDA.2, R_JPU.1, R_OPTRST.2, R_ROFF.2, R_SCL.2, R_SDA.2, R_SEENA.2, R_SESCL.2, R_SESDA.2, R_STAT.2, TP_3V3.1, U4.6, U4.11, U4.20, U4.21, U4.27, U4.51, U4.73, U4.75, U4.100, U5.12, U6.10, U7.5, U8.1, U9.3, U10.2, U10.7, U12.1, U13.13, U14.1, U15.5, U15.8, U15.12, U16.10
V3V3_USB: C_USB3V3.1, L_BUCK.2, R_CHGOFF.2, R_FBU1.1, U10.3, U10.5
VBUS: C_CHGIN.1, C_VBUS.1, D_ESD.5, J1.A4, J1.A9, J1.B4, J1.B9, R_PG.2, R_VB1.1, U1.1, U3.1, U3.4
VBUS_SENSE: R_VB1.2, R_VB2.1, U4.68
VDD11: C_VDD11A.1, C_VDD11B.1, U4.49, U4.98
V_BOOST: C_BOOST.1, C_BOOST2.1, C_FFB.1, D_REVG.1, R_FB1.1, U2.7, U2.8, U10.6
