AmbireTech/ice/pack/pack.kicad_pcb

## KiCad design pack/pack.kicad_pcb (2026-11-02)

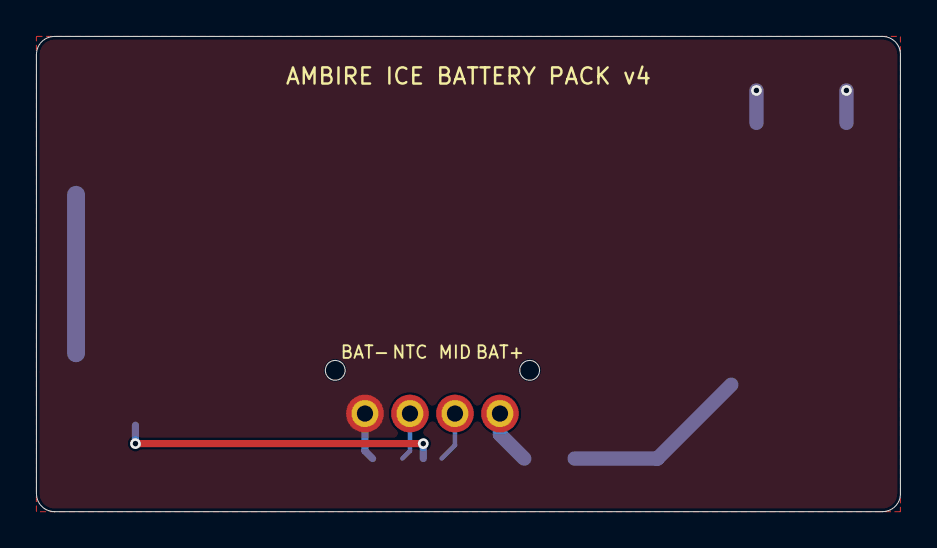
[picture p36: board pack.kicad_pcb from above]

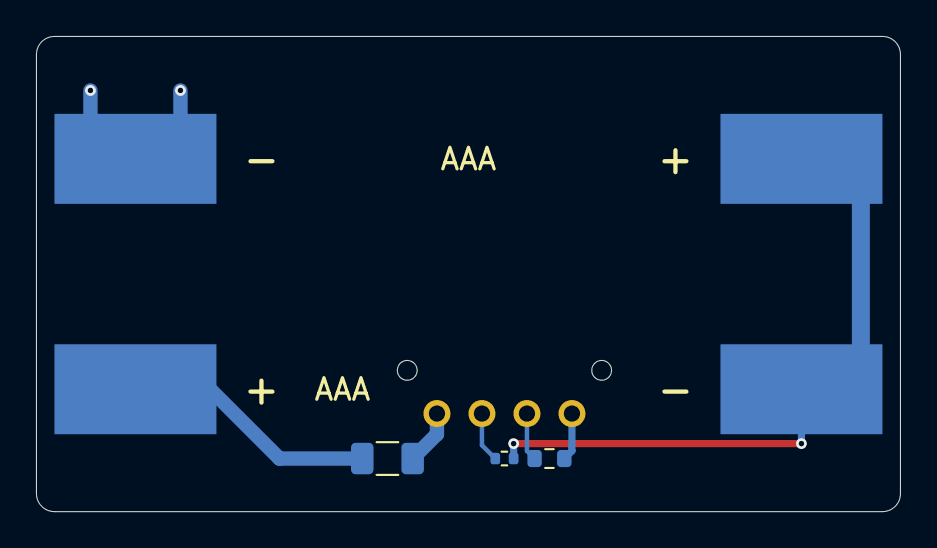
[picture p37: board pack.kicad_pcb from below]

Board: 2 copper layers, 48.0 x 26.4 mm, 12 parts (7 on the bottom side), 6 nets.

Parts:
BT_N1, BT_N2: MY-AAA-19-J; Battery_AAA_Clip_MYOUNG_MY-AAA-19-J
BT_P1, BT_P2: MY-AAA-20-J; Battery_AAA_Clip_MYOUNG_MY-AAA-20-J
FR1: frame (print); Pack_Frame
F_BAT: 0.75A hold; Fuse_1206_3216Metric
J_PACK1, J_PACK2, J_PACK3, J_PACK4: YZP0118-20063-02; Xinyangze_YZP0118-20063-02
RT_PACK: 10k NTC B3380; R_0603_1608Metric
R_MID: 1k; R_0402_1005Metric

Connections:
BAT+: F_BAT.1, J_PACK4.1
BAT-: BT_N1.1, J_PACK1.1, RT_PACK.1
CELL+: BT_P2.1, F_BAT.2
MID: BT_N2.1, BT_P1.1, R_MID.1
MID_SENSE: J_PACK3.1, R_MID.2
NTC: J_PACK2.1, RT_PACK.2
