AmbireTech/ice/jig/jig.kicad_pcb

## KiCad design jig/jig.kicad_pcb (2026-11-01)

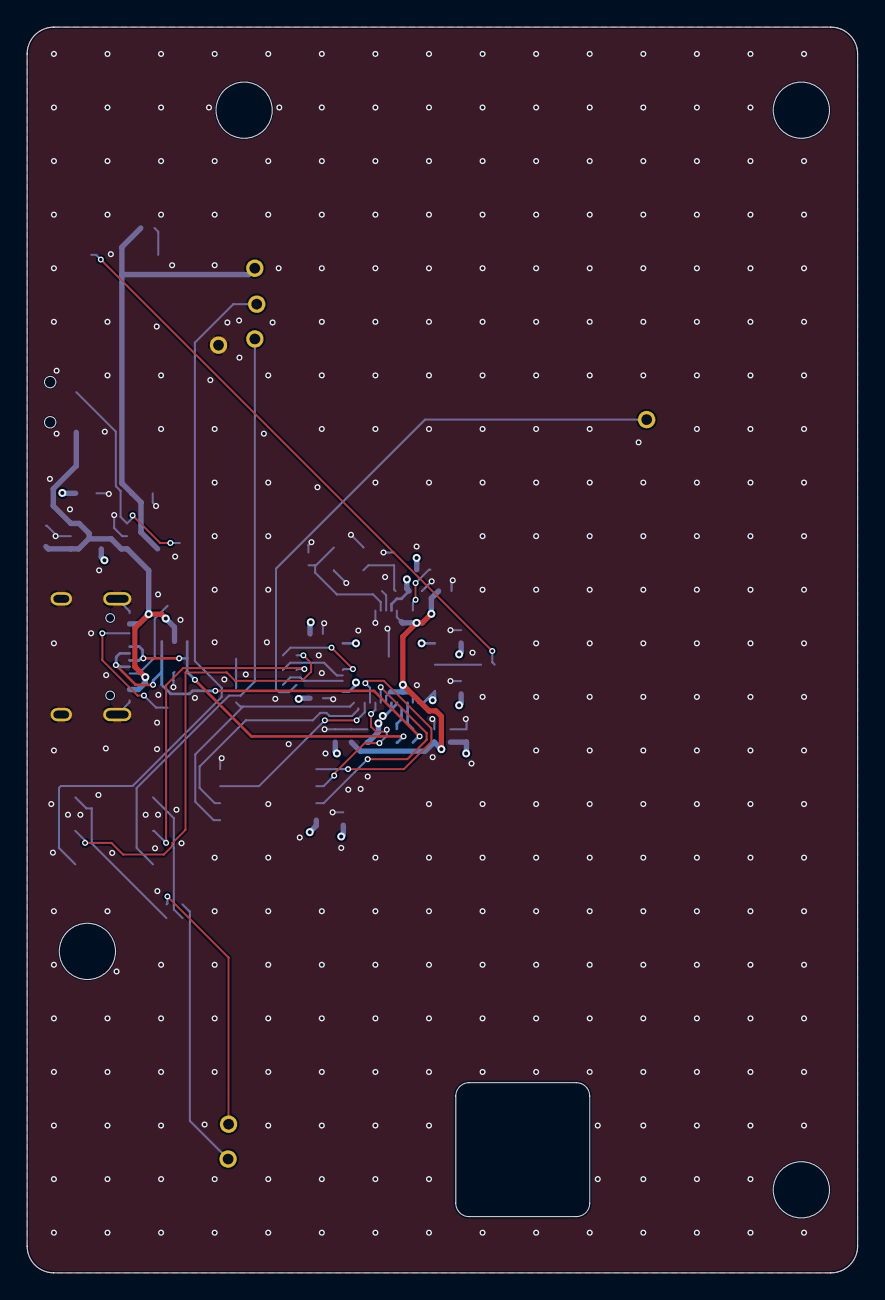
[picture p38: board jig.kicad_pcb from above]

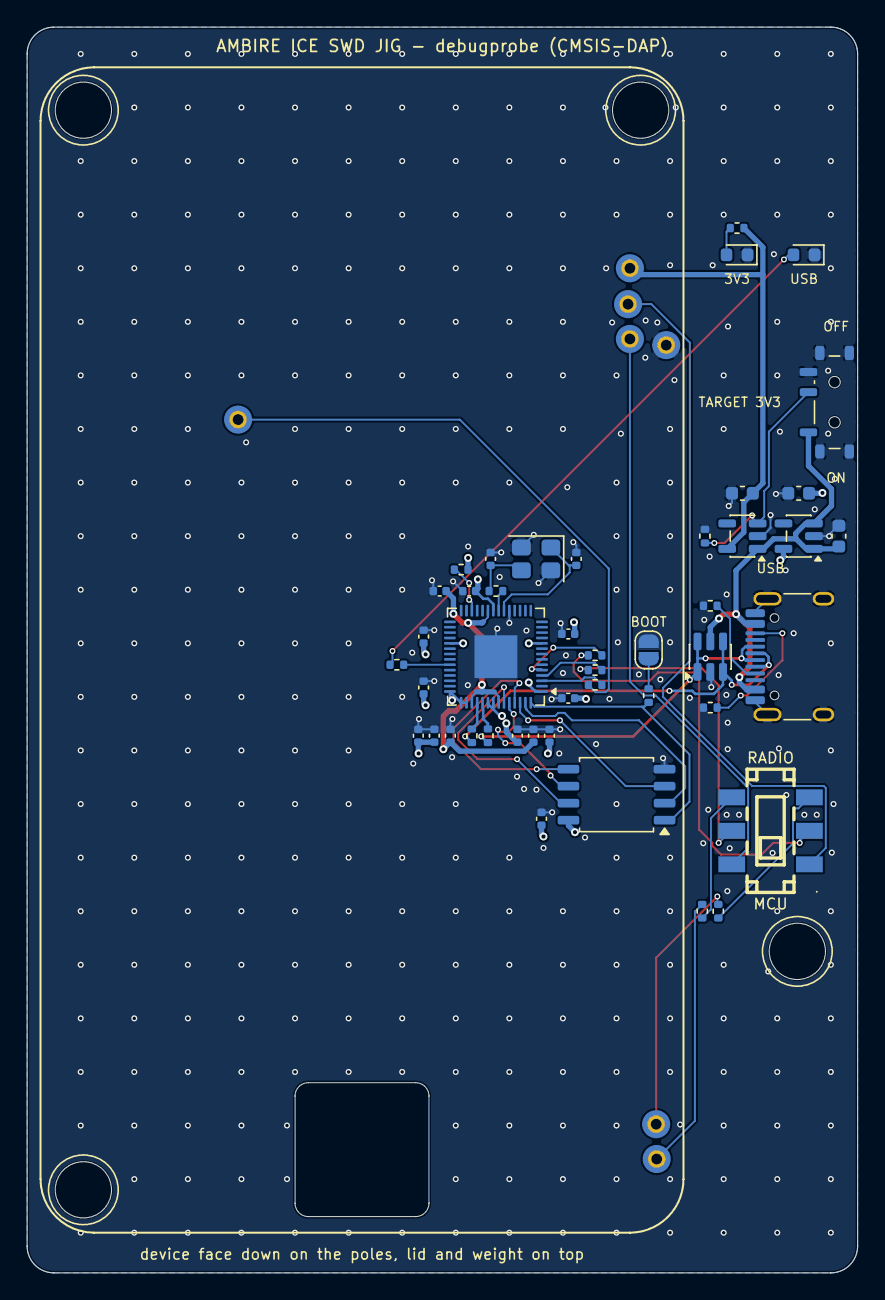
[picture p39: board jig.kicad_pcb from below]

Board: 4 copper layers, 62.0 x 93.0 mm, 56 parts (56 on the bottom side), 38 nets.

Parts:
C_3V3P: 10uF; C_0603_1608Metric
C_AV: 100nF; C_0402_1005Metric
C_DV23, C_DV50: 100nF; C_0402_1005Metric
C_FL: 100nF; C_0402_1005Metric
C_IO1, C_IO10, C_IO22, C_IO33, C_IO42, C_IO49: 100nF; C_0402_1005Metric
C_TGT: 10uF; C_0603_1608Metric
C_UV: 100nF; C_0402_1005Metric
C_VBUS: 10uF; C_0603_1608Metric
C_VRI: 1uF; C_0402_1005Metric
C_VRO: 1uF; C_0402_1005Metric
C_XI: 15pF; C_0402_1005Metric
C_XO: 15pF; C_0402_1005Metric
D_ESD: USBLC6-2SC6; SOT-23-6
D_TGT: red; LED_0603_1608Metric
D_USB: green; LED_0603_1608Metric
H_1, H_2, H_4, H_5: pole; Jig_Hole_Pole_4.2mm
JP_BOOT: SolderJumper-2_P1.3mm_Open_RoundedPad1.0x1.5mm
J_USB: TYPE-C-31-M-12; USB_C_Receptacle_HRO_TYPE-C-31-M-12_BoardEdge
P_3V3: YZP0063-20068-01; Xinyangze_YZP0063-20068-01
P_GND: YZP0063-20068-01; Xinyangze_YZP0063-20068-01
P_NRST: YZP0063-20068-01; Xinyangze_YZP0063-20068-01
P_RSWCLK: YZP0063-20068-01; Xinyangze_YZP0063-20068-01
P_RSWDIO: YZP0063-20068-01; Xinyangze_YZP0063-20068-01
P_SWCLK: YZP0063-20068-01; Xinyangze_YZP0063-20068-01
P_SWDIO: YZP0063-20068-01; Xinyangze_YZP0063-20068-01
R_BOOT: 1k; R_0402_1005Metric
R_CC1, R_CC2: 5.1k; R_0402_1005Metric
R_CE: 100k; R_0402_1005Metric
R_DN: 27; R_0402_1005Metric
R_DP: 27; R_0402_1005Metric
R_LT: 1k; R_0402_1005Metric
R_LU: 1k; R_0402_1005Metric
R_NRST: 1k; R_0402_1005Metric
R_RSWC: 1k; R_0402_1005Metric
R_RSWD: 1k; R_0402_1005Metric
R_RUN: 10k; R_0402_1005Metric
R_SWC: 100; R_0402_1005Metric
R_SWD: 100; R_0402_1005Metric
R_XO: 1k; R_0402_1005Metric
SW_PWR: MSK12C02; SW_SPDT_Shouhan_MSK12C02
SW_SEL: K3-2235S-K1; SW_DPDT_Hroparts_K3-2235S-K1
U1: RP2040; QFN-56-1EP_7x7mm_P0.4mm_EP3.2x3.2mm
U2: W25Q16JVSSIQ; SOIC-8_5.3x5.3mm_P1.27mm
U_LP: ME6211C33; SOT-23-5
U_LT: ME6211C33; SOT-23-5
Y1: 12MHz; Crystal_SMD_3225-4Pin_3.2x2.5mm

Connections:
BOOT_R: JP_BOOT.1, R_BOOT.2
CC1: J_USB.A5, R_CC1.1
CC2: J_USB.B5, R_CC2.1
CE_TGT: R_CE.1, SW_PWR.2, U_LT.3
GND: C_3V3P.2, C_AV.2, C_DV23.2, C_DV50.2, C_FL.2, C_IO1.2, C_IO10.2, C_IO22.2, C_IO33.2, C_IO42.2, C_IO49.2, C_TGT.2, C_UV.2, C_VBUS.2, C_VRI.2, C_VRO.2, C_XI.2, C_XO.2, D_ESD.2, D_TGT.1, D_USB.1, JP_BOOT.2, J_USB.A1, J_USB.A12, J_USB.B1, J_USB.B12, J_USB.SH, P_GND.1, R_CC1.2, R_CC2.2, R_CE.2, SW_PWR.3, SW_PWR.SH, U1.19, U1.57, U2.4, U_LP.2, U_LT.2, Y1.2, Y1.4
LED_TGT_A: D_TGT.2, R_LT.2
LED_USB: R_LU.1, U1.37
LED_USB_A: D_USB.2, R_LU.2
MCU_SWCLK: P_SWCLK.1, SW_SEL.6
MCU_SWDIO: P_SWDIO.1, SW_SEL.1
NRST: P_NRST.1, R_NRST.2
PRB_NRST: R_NRST.1, U1.3
PRB_SWCLK: R_SWC.1, U1.4
PRB_SWDIO: R_SWD.1, U1.5
QSPI_SCLK: U1.52, U2.6
QSPI_SD0: U1.53, U2.5
QSPI_SD1: U1.55, U2.2
QSPI_SD2: U1.54, U2.3
QSPI_SD3: U1.51, U2.7
QSPI_SS: R_BOOT.1, U1.56, U2.1
RAD_SWCLK: P_RSWCLK.1, R_RSWC.2
RAD_SWCLK_S: R_RSWC.1, SW_SEL.4
RAD_SWDIO: P_RSWDIO.1, R_RSWD.2
RAD_SWDIO_S: R_RSWD.1, SW_SEL.3
RUN: R_RUN.2, U1.26
SWCLK_P: R_SWC.2, SW_SEL.5
SWDIO_P: R_SWD.2, SW_SEL.2
USBR_DN: R_DN.2, U1.46
USBR_DP: R_DP.2, U1.47
USB_DN: D_ESD.3, D_ESD.4, J_USB.A7, J_USB.B7, R_DN.1
USB_DP: D_ESD.1, D_ESD.6, J_USB.A6, J_USB.B6, R_DP.1
V1V1: C_DV23.1, C_DV50.1, C_VRO.1, U1.23, U1.45, U1.50
V3V3_PROBE: C_3V3P.1, C_AV.1, C_FL.1, C_IO1.1, C_IO10.1, C_IO22.1, C_IO33.1, C_IO42.1, C_IO49.1, C_UV.1, C_VRI.1, R_RUN.1, U1.1, U1.10, U1.22, U1.33, U1.42, U1.43, U1.44, U1.48, U1.49, U2.8, U_LP.5
V3V3_TGT: C_TGT.1, P_3V3.1, R_LT.1, U_LT.5
VBUS: C_VBUS.1, D_ESD.5, J_USB.A4, J_USB.A9, J_USB.B4, J_USB.B9, SW_PWR.1, U_LP.1, U_LP.3, U_LT.1
XIN: C_XI.1, U1.20, Y1.1
XOUT: R_XO.1, U1.21
XOUT_R: C_XO.1, R_XO.2, Y1.3
