AmbireTech/ice/jig/base.kicad_pcb

## KiCad design jig/base.kicad_pcb (2026-11-01)

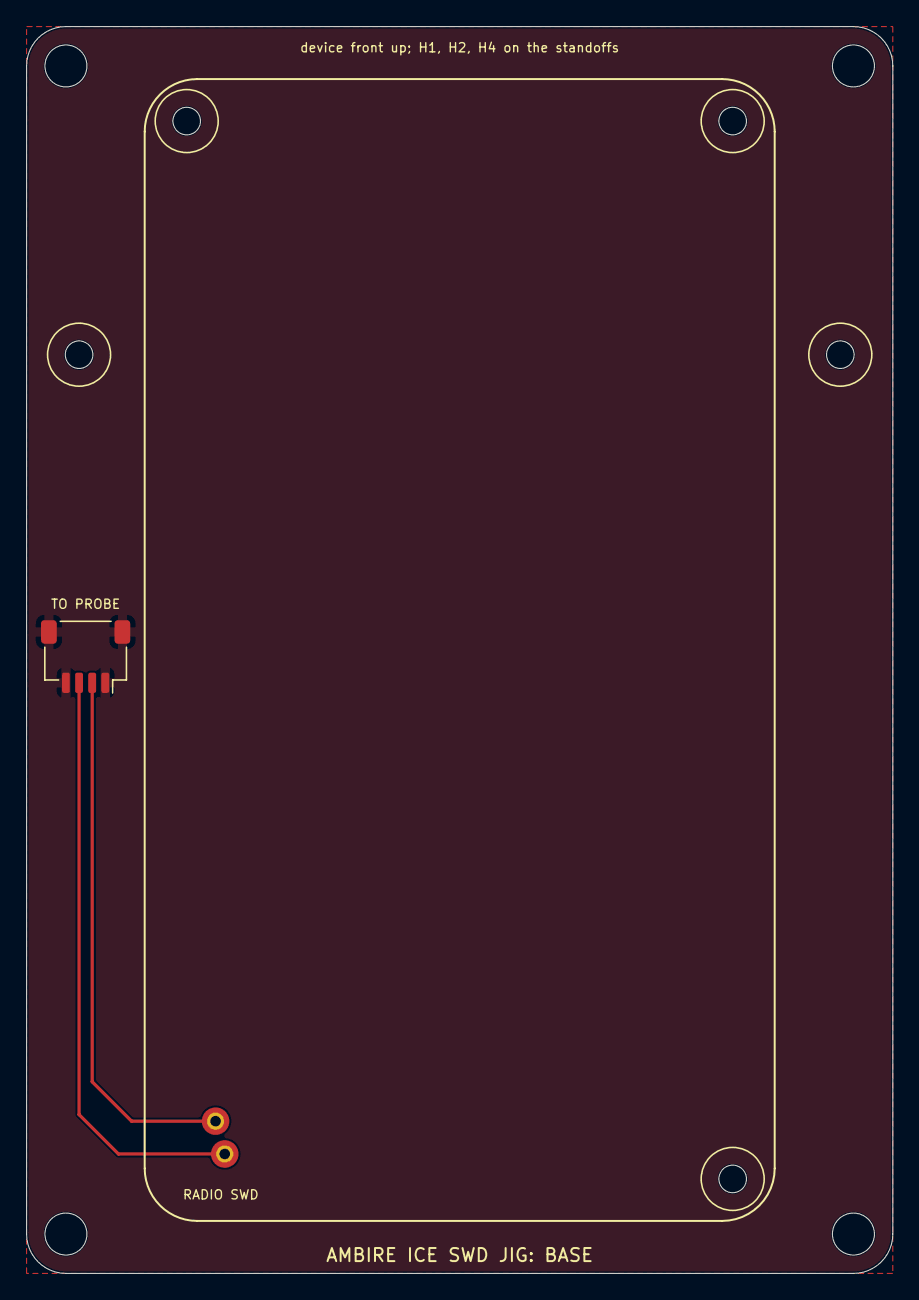
[picture p40: board base.kicad_pcb from above]

Board: 2 copper layers, 66.0 x 95.0 mm, 12 parts (0 on the bottom side), 3 nets.

Parts:
H_1, H_2, H_4: M2 hole; Jig_Hole_M2_NPTH
H_F1, H_F2, H_F3, H_F4: M3 foot; Jig_Hole_M3_Foot
H_P1, H_P2: M2 hole; Jig_Hole_M2_NPTH
J_RAD: SM04B-SRSS-TB; JST_SH_SM04B-SRSS-TB_1x04-1MP_P1.00mm_Horizontal
P_RSWCLK: YZP0063-20068-01; Xinyangze_YZP0063-20068-01
P_RSWDIO: YZP0063-20068-01; Xinyangze_YZP0063-20068-01

Connections:
GND: J_RAD.1, J_RAD.4, J_RAD.MP
RAD_SWCLK: J_RAD.3, P_RSWCLK.1
RAD_SWDIO: J_RAD.2, P_RSWDIO.1
