AmbireTech/ice/firmware/trezor-firmware/core/embed/projects/kernel/main.c

/*
 * This file is part of the Trezor project, https://trezor.io/
 *
 * Copyright (c) SatoshiLabs
 *
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
 * You should have received a copy of the GNU General Public License
 * along with this program.  If not, see <http://www.gnu.org/licenses/>.
 */

#include <trezor_model.h>
#include <trezor_rtl.h>

#include <io/display.h>
#include <io/gfx_bitblt.h>
#include <io/rsod.h>
#include <sec/board_capabilities.h>
#include <sec/boot_image.h>
#include <sec/monoctr.h>
#include <sec/option_bytes.h>
#include <sec/random_delays.h>
#include <sec/unit_properties.h>
#include <sys/bootutils.h>
#include <sys/coreapp.h>
#include <sys/mpu.h>
#include <sys/syscall_ipc.h>
#include <sys/sysevent.h>
#include <sys/system.h>
#include <sys/systick.h>

#ifdef USE_APP_LOADING
#include <io/app_arena.h>
#endif

#ifdef USE_BUTTON
#include <io/button.h>
#endif

#ifdef USE_BLE
#include <io/ble.h>
#endif

#ifdef USE_NFC
#include <io/nfc.h>
#endif

#ifdef USE_CONSUMPTION_MASK
#include <sec/consumption_mask.h>
#endif

#ifdef USE_HAPTIC
#include <io/haptic.h>
#endif

#if SECURE_MODE && USE_HASH_PROCESSOR
#include <sec/hash_processor.h>
#endif

#if SECURE_MODE && USE_STORAGE_HWKEY
#include <sec/secure_aes.h>
#endif

#ifdef USE_SECRET
#include <sec/secret.h>
#endif

#if SECURE_MODE && USE_OPTIGA
#include <sec/optiga_init.h>
#endif

#if SECURE_MODE && USE_BACKUP_RAM
#include <sec/backup_ram.h>
#endif

#if SECURE_MODE && USE_TROPIC
#include <sec/tropic.h>
#endif

#ifdef USE_POWER_MANAGER
#include <io/power_manager.h>
#endif

#ifdef USE_PVD
#include <sys/pvd.h>
#endif

#ifdef USE_SD_CARD
#include <io/sdcard.h>
#endif

#ifdef USE_RGB_LED
#include <io/rgb_led.h>
#endif

#ifdef USE_RTC
#include <sys/rtc.h>
#endif

#ifdef USE_TAMPER
#include <sec/tamper.h>
#endif

#ifdef USE_TOUCH
#include <io/touch.h>
#endif

#if defined(USE_TRUSTZONE) && defined(SECURE_MODE)
#include <sec/tz_init.h>
#endif

#ifdef USE_USB
#include <io/usb.h>
#include <io/usb_config.h>
#endif

#ifdef USE_AMBIRE_RADIO
// ambire_radio.c (Ambire boards)
void ambire_radio_init(void);
#endif

#ifdef USE_AMBIRE_POWER
// ambire_power.c (Ambire boards)
void ambire_power_init(void);
#endif

#ifdef USE_AMBIRE_CAMERA
#include <io/camera.h>
#endif

void drivers_init() {
  ts_t status;

  UNUSED(status);

#ifdef SECURE_MODE
  monoctr_init();

  parse_boardloader_capabilities();
  unit_properties_init();

#ifdef USE_STORAGE_HWKEY
  secure_aes_init();
#endif
#ifdef USE_TAMPER
  tamper_init();
#if PRODUCTION
  tamper_external_enable();
#endif
#endif
  random_delays_init();
#ifdef RDI
  random_delays_start_rdi();
#endif
#ifdef USE_BACKUP_RAM
  backup_ram_init();
#endif
#ifdef USE_HASH_PROCESSOR
  hash_processor_init();
#endif
#endif  // SECURE_MODE

#ifdef USE_RTC
  rtc_init();
#endif

#ifdef USE_CONSUMPTION_MASK
  consumption_mask_init();
#endif

#ifdef USE_POWER_MANAGER
  pm_init(true);
#endif

#ifdef USE_PVD
  pvd_init();
#endif

  display_init(DISPLAY_JUMP_BEHAVIOR);

#ifdef USE_TRUSTZONE
  display_set_unpriv_access(true);
#endif

#ifdef SECURE_MODE
#ifdef USE_OEM_KEYS_CHECK
  option_bytes_check_oem_keys();
#endif

#endif

#ifdef USE_AMBIRE_RADIO
  ambire_radio_init();
#endif

#ifdef USE_AMBIRE_POWER
  ambire_power_init();
#endif

#ifdef USE_BUTTON
  button_init();
#endif

#ifdef USE_RGB_LED
  rgb_led_init();
#endif

#ifdef USE_TOUCH
  touch_init();
#endif

#ifdef USE_SD_CARD
  sdcard_init();
#endif

#ifdef USE_HAPTIC
  status = haptic_init();
  UNUSED(status);
#endif

#ifdef USE_BLE
  ble_init();
#endif

#ifdef USE_NFC
  status = nfc_init();
  UNUSED(status);
#endif

#ifdef SECURE_MODE
#ifdef USE_OPTIGA
  optiga_init_and_configure();
#endif
#ifdef USE_TROPIC
  ensure_true(tropic_init(NULL) == LT_OK, "Failed to initialize Tropic driver");
#endif
#endif  // SECURE_MODE

#ifdef USE_USB
  usb_configure(NULL);
#endif

#ifdef USE_APP_LOADING
  status = app_arena_init();
  ensure_ok(status, "app_arena_init failed");
#endif
}

// Kernel task main loop
//
// Returns when the coreapp task is terminated
static void kernel_loop(applet_t *coreapp) {
#if SECURE_MODE && USE_STORAGE_HWKEY
  secure_aes_set_applet(coreapp);
#endif

  do {
    sysevents_t awaited = {
        .read_ready = 1 << SYSHANDLE_SYSCALL,
        .write_ready = 0,
    };

    sysevents_t signalled = {0};

    sysevents_poll(&awaited, &signalled, ticks_timeout(100));

    if (signalled.read_ready & (1 << SYSHANDLE_SYSCALL)) {
      syscall_ipc_dequeue();
    }

  } while (applet_is_alive(coreapp));

#ifdef USE_AMBIRE_CAMERA
  // Ambire boards: the app is gone however it ended (exit, crash, kill); a
  // capture it started must not keep its DMA writing, nor the camera stay
  // powered (the app's own Drop handlers never ran on a crash)
  camera_close();
#endif
}

#ifndef USE_BOOTARGS_RSOD

// Shows RSOD (Red Screen of Death)
static void show_rsod(const systask_postmortem_t *pminfo) {
  applet_t coreapp;

  // Reset and run the coreapp in RSOD mode
  if (coreapp_init(&coreapp, 1, pminfo, sizeof(systask_postmortem_t))) {
    // Run the applet & wait for it to finish
    applet_run(&coreapp);
    // Loop until the coreapp is terminated
    kernel_loop(&coreapp);
    // Release the coreapp resources
    applet_unload(&coreapp);

    if (coreapp.task.pminfo.reason == TASK_TERM_REASON_EXIT) {
      // RSOD was shown successfully
      return;
    }
  }

  // If coreapp crashed, fallback to showing the error using a terminal
  rsod_terminal(pminfo);
}

// Initializes system in emergency mode and shows RSOD
static void init_and_show_rsod(const systask_postmortem_t *pminfo) {
  // Initialize the system's core services
  // (If the kernel crashes in emergency mode, we are out of options
  // and show the RSOD without attempting to re-enter emergency mode)
  system_init(&rsod_terminal);

  // Initialize necessary drivers
  display_init(DISPLAY_RESET_CONTENT);

  // Show RSOD
  show_rsod(pminfo);

  // Reboots or halts (if RSOD_INFINITE_LOOP is defined)
  reboot_or_halt_after_rsod();
}

#endif  // USE_BOOTARGS_RSOD

// Kernel panic handler
// (may be called from interrupt context)
static void kernel_panic(const systask_postmortem_t *pminfo) {
  // Since the system state is unreliable, enter emergency mode
  // and show the RSOD.
#ifndef USE_BOOTARGS_RSOD
  system_emergency_rescue(&init_and_show_rsod, pminfo);
#else
  reboot_with_rsod(pminfo);
#endif  // USE_BOOTARGS_RSOD
  // We never get here
}

int main(void) {
#if defined(USE_TRUSTZONE) && defined(SECURE_MODE)
  tz_init();
#endif

  // Initialize system's core services
  system_init(&kernel_panic);

  // Initialize hardware drivers
  drivers_init();

  // Initialize coreapp task
  applet_t coreapp;

  // Reset and run the coreapp
  if (!coreapp_init(&coreapp, 0, NULL, 0)) {
    error_shutdown("Cannot start coreapp");
  }

  // Run the applet
  applet_run(&coreapp);

  // Loop until the coreapp is terminated
  kernel_loop(&coreapp);
  // Release the coreapp resources
  applet_unload(&coreapp);

#ifndef USE_BOOTARGS_RSOD
  // Coreapp crashed, show RSOD
  show_rsod(&coreapp.task.pminfo);
  // Reboots or halts (if RSOD_INFINITE_LOOP is defined)
  reboot_or_halt_after_rsod();
#else
  reboot_with_rsod(&coreapp.task.pminfo);
#endif  // USE_BOOTARGS_RSOD

  return 0;
}
