AmbireTech/ice/firmware/trezor-firmware/core/embed/models/T3T2/boards/ambire_p0.h

#pragma once

// Ambire signer, proto 0: STM32U585VIT6Q (LQFP100), hardware in
// hardware/ambire-wallet of the AmbireTech/secure-signer repo. Pins follow
// src/parts/mcuAssign.json there, which the board copper matches.
//
// LQFP100 has ports A-E and PH0/PH1/PH3 only: nothing here may sit on a
// port F/G pin (the T3T2 devkit's pin map is a larger package).
//
// Not driven by this board file yet: the OPTIGA secure element (I2C4; not
// fitted on the first boards), the SE050 beyond its random number generator
// (below), the BQ25185 charger and the MAX17048 battery gauge. The nRF52840
// radio (USART3 2-wire, behind the airgap switch) runs Trezor's BLE stack over
// a UART link (below). The camera is driven by [ambire_camera] (below).

#define VDD_3V3 1

// Product name on screen (welcome screen, default label) and over USB; the
// flame logo comes with [ambire_branding] in ambire_p0.toml
#define MODEL_FULL_NAME "Ambire"
#define MODEL_USB_MANUFACTURER "Ambire"
// USB interface name, WebUSB landing page (https://, offered by a bootloader
// with no firmware) and the footer of error screens, in place of Trezor's
#define MODEL_USB_INTERFACE "Ambire Interface"
#define MODEL_WEBUSB_URL "ambire.com"
#define MODEL_SUPPORT_FOOTER "Please visit ambire.com"

// Power latch. The power button lifts the 3.3 V buck-boost's enable; the MCU
// keeps it up by driving PWR_HOLD high. An RC on the enable holds the rail for
// about 1 s, so the boardloader must set this before anything slow (option
// byte programming included), and every reset is bridged by the RC.
#define POWER_HOLD_PORT GPIOE
#define POWER_HOLD_PIN GPIO_PIN_5
#define POWER_HOLD_CLK_EN __HAL_RCC_GPIOE_CLK_ENABLE

// The power key as the MCU sees it: BTN_N, low while pressed (a 2N7002 from
// the key's node), pulled up by PA0's own pull-up. [ambire_power] in
// ambire_p0.toml turns a long press into power-off (drops PWR_HOLD).
#define POWER_KEY_PORT GPIOA
#define POWER_KEY_PIN GPIO_PIN_0
#define POWER_KEY_CLK_EN __HAL_RCC_GPIOA_CLK_ENABLE

// Newhaven NHD-2.4-240320AF-CSXP: ST7789Vi, 240x320, strapped for 4-wire SPI
// (IM2..0 = 110). Write-only: the panel's SDO is not wired, so no
// DISPLAY_IDENTIFY. SPI1 at 160 MHz / 4 = 40 MHz (ST7789 write cycle >= 16 ns).
#define DISPLAY_SPI 1
#define DISPLAY_SPI_INSTANCE SPI1
#define DISPLAY_SPI_CLK_EN __HAL_RCC_SPI1_CLK_ENABLE
#define DISPLAY_SPI_FORCE_RESET __HAL_RCC_SPI1_FORCE_RESET
#define DISPLAY_SPI_RELEASE_RESET __HAL_RCC_SPI1_RELEASE_RESET
#define DISPLAY_SPI_CLK_PRESCALER SPI_CFG1_MBR_0  // /4
#define DISPLAY_SPI_PIN_AF GPIO_AF5_SPI1
#define DISPLAY_SPI_DMA_REQUEST GPDMA1_REQUEST_SPI1_TX
#define DISPLAY_SPI_SCK_PORT GPIOE
#define DISPLAY_SPI_SCK_PIN GPIO_PIN_13
#define DISPLAY_SPI_MOSI_PORT GPIOE
#define DISPLAY_SPI_MOSI_PIN GPIO_PIN_15
#define DISPLAY_CS_PORT GPIOE
#define DISPLAY_CS_PIN GPIO_PIN_14
#define DISPLAY_DC_PORT GPIOE
#define DISPLAY_DC_PIN GPIO_PIN_12
#define DISPLAY_RST_PORT GPIOE
#define DISPLAY_RST_PIN GPIO_PIN_11

#define DISPLAY_TE_PORT GPIOE
#define DISPLAY_TE_PIN GPIO_PIN_10
#define DISPLAY_TE_INTERRUPT_HANDLER EXTI10_IRQHandler
#define DISPLAY_TE_INTERRUPT_NUM EXTI10_IRQn
#define DISPLAY_TE_INTERRUPT_GPIOSEL EXTI_GPIOE
#define DISPLAY_TE_INTERRUPT_EXTI_LINE EXTI_LINE_10

// The Newhaven panel's columns run opposite to the DEM240320B1's: without
// this the image is mirrored left to right (seen on proto 0)
#define DISPLAY_PANEL_MIRROR_X 1

// One 150 KB frame buffer; a second does not fit next to the firmware's RAM.
#define FRAME_BUFFER_COUNT 1

// Backlight: TPS60230 charge pump, EN1/EN2 tied together on TFT_BL through
// 1 k, with 100 k to GND. On/off only for now: the on state is the pin's
// internal pull-up (~40 k), which leaves EN at ~2.3 V. PWM dimming on
// TIM1_CH1 waits for the TPS60230's EN timing to be checked.
#define BACKLIGHT_PIN_PORT GPIOE
#define BACKLIGHT_PIN_PIN GPIO_PIN_9
#define BACKLIGHT_PIN_CLK_ENABLE() __HAL_RCC_GPIOE_CLK_ENABLE()

#define I2C_COUNT 2

// I2C3: touch controller and battery gauge
#define I2C_INSTANCE_0 I2C3
#define I2C_INSTANCE_0_CLK_EN __HAL_RCC_I2C3_CLK_ENABLE
#define I2C_INSTANCE_0_CLK_DIS __HAL_RCC_I2C3_CLK_DISABLE
#define I2C_INSTANCE_0_PIN_AF GPIO_AF4_I2C3
#define I2C_INSTANCE_0_SDA_PORT GPIOC
#define I2C_INSTANCE_0_SDA_PIN GPIO_PIN_1
#define I2C_INSTANCE_0_SDA_CLK_EN __HAL_RCC_GPIOC_CLK_ENABLE
#define I2C_INSTANCE_0_SCL_PORT GPIOC
#define I2C_INSTANCE_0_SCL_PIN GPIO_PIN_0
#define I2C_INSTANCE_0_SCL_CLK_EN __HAL_RCC_GPIOC_CLK_ENABLE
#define I2C_INSTANCE_0_RESET_REG &RCC->APB3RSTR
#define I2C_INSTANCE_0_RESET_BIT RCC_APB3RSTR_I2C3RST
#define I2C_INSTANCE_0_EV_IRQHandler I2C3_EV_IRQHandler
#define I2C_INSTANCE_0_ER_IRQHandler I2C3_ER_IRQHandler
#define I2C_INSTANCE_0_EV_IRQn I2C3_EV_IRQn
#define I2C_INSTANCE_0_ER_IRQn I2C3_ER_IRQn
#define I2C_INSTANCE_0_GUARD_TIME 0

// I2C4: the secure elements (SE050 at 0x48, OPTIGA at 0x30)
#define I2C_INSTANCE_1 I2C4
#define I2C_INSTANCE_1_CLK_EN __HAL_RCC_I2C4_CLK_ENABLE
#define I2C_INSTANCE_1_CLK_DIS __HAL_RCC_I2C4_CLK_DISABLE
#define I2C_INSTANCE_1_PIN_AF GPIO_AF4_I2C4
#define I2C_INSTANCE_1_SDA_PORT GPIOD
#define I2C_INSTANCE_1_SDA_PIN GPIO_PIN_13
#define I2C_INSTANCE_1_SDA_CLK_EN __HAL_RCC_GPIOD_CLK_ENABLE
#define I2C_INSTANCE_1_SCL_PORT GPIOD
#define I2C_INSTANCE_1_SCL_PIN GPIO_PIN_12
#define I2C_INSTANCE_1_SCL_CLK_EN __HAL_RCC_GPIOD_CLK_ENABLE
#define I2C_INSTANCE_1_RESET_REG &RCC->APB1RSTR2
#define I2C_INSTANCE_1_RESET_BIT RCC_APB1RSTR2_I2C4RST
#define I2C_INSTANCE_1_EV_IRQHandler I2C4_EV_IRQHandler
#define I2C_INSTANCE_1_ER_IRQHandler I2C4_ER_IRQHandler
#define I2C_INSTANCE_1_EV_IRQn I2C4_EV_IRQn
#define I2C_INSTANCE_1_ER_IRQn I2C4_ER_IRQn
#define I2C_INSTANCE_1_GUARD_TIME 50  // OPTIGA requires 50 us guard time
#define I2C_INSTANCE_1_GTZC_PERIPH GTZC_PERIPH_I2C4

// FocalTech FT5426 on the panel's touch flex, same register map as the
// FT6x36 (address 0x38). RST has no pull on the board: the driver holds it.
#define TOUCH_SENSITIVITY 0x40
#define TOUCH_I2C_INSTANCE 0
#define TOUCH_INT_PORT GPIOE
#define TOUCH_INT_PIN GPIO_PIN_2
#define TOUCH_RST_PORT GPIOE
#define TOUCH_RST_PIN GPIO_PIN_3

// OPTIGA Trust M: used once [optiga] is enabled in ambire_p0.toml (the part
// is not fitted on the first boards). No power switch, only a reset line.
#define OPTIGA_I2C_INSTANCE 1
#define OPTIGA_RST_PORT GPIOD
#define OPTIGA_RST_PIN GPIO_PIN_14
#define OPTIGA_RST_CLK_EN __HAL_RCC_GPIOD_CLK_ENABLE

// NXP SE050: [se050] in ambire_p0.toml mixes its random number generator into
// the strong RNG. ENA high runs the chip, low is deep power-down (the board
// pulls it high with 100 k); the driver pulses it low to start from a clean
// power-up.
#define SE050_I2C_INSTANCE 1
#define SE050_ENA_PORT GPIOD
#define SE050_ENA_PIN GPIO_PIN_11
#define SE050_ENA_CLK_EN __HAL_RCC_GPIOD_CLK_ENABLE

// Radio (nRF52840 module behind the airgap switch): RADIO_OFF high (or
// floating: 100 k pull-up) keeps the radio unpowered; low allows it, the
// airgap switch's NOR gate still decides. USART3 to the radio through the
// TXU0202 translator: PB10 = MCU TX (RADIO_TXD_MCU), PB11 = MCU RX. No flow
// control, reset or handshake lines: power-cycling via RADIO_OFF is the only
// radio reset. Driven by Trezor's BLE stack over our UART link ([ble] and
// [nrf] in ambire_p0.toml, io/nrf/stm32u5/nrf_uart_link.c), or by the
// [ambire_radio] bring-up hello when BLE is off.
#define RADIO_OFF_PORT GPIOB
#define RADIO_OFF_PIN GPIO_PIN_2
#define RADIO_OFF_CLK_EN __HAL_RCC_GPIOB_CLK_ENABLE
#define RADIO_UART USART3
#define RADIO_UART_CLK_EN __HAL_RCC_USART3_CLK_ENABLE
#define RADIO_UART_CLK_DIS __HAL_RCC_USART3_CLK_DISABLE
#define RADIO_UART_FORCE_RESET __HAL_RCC_USART3_FORCE_RESET
#define RADIO_UART_RELEASE_RESET __HAL_RCC_USART3_RELEASE_RESET
#define RADIO_UART_IRQn USART3_IRQn
#define RADIO_UART_IRQHandler USART3_IRQHandler
// GPDMA1 channels 5 (RX, circular) and 6 (TX): free on this board (display
// 4, backlight 3, bg_copy 0, hash processor 12 in the secure monitor)
#define RADIO_UART_DMA_RX_CHANNEL GPDMA1_Channel5
#define RADIO_UART_DMA_RX_IRQn GPDMA1_Channel5_IRQn
#define RADIO_UART_DMA_RX_IRQHandler GPDMA1_Channel5_IRQHandler
#define RADIO_UART_DMA_RX_REQUEST GPDMA1_REQUEST_USART3_RX
#define RADIO_UART_DMA_TX_CHANNEL GPDMA1_Channel6
#define RADIO_UART_DMA_TX_IRQn GPDMA1_Channel6_IRQn
#define RADIO_UART_DMA_TX_IRQHandler GPDMA1_Channel6_IRQHandler
#define RADIO_UART_DMA_TX_REQUEST GPDMA1_REQUEST_USART3_TX
#define RADIO_UART_PIN_AF GPIO_AF7_USART3
#define RADIO_UART_PINS_CLK_EN __HAL_RCC_GPIOB_CLK_ENABLE
#define RADIO_UART_TX_PORT GPIOB
#define RADIO_UART_TX_PIN GPIO_PIN_10
#define RADIO_UART_RX_PORT GPIOB
#define RADIO_UART_RX_PIN GPIO_PIN_11

// The airgap switch's position, [ambire_airgap]: AIRGAP_SENSE, high on AIR
// (the switch drives it through a series resistor)
#define AIRGAP_SENSE_PORT GPIOE
#define AIRGAP_SENSE_PIN GPIO_PIN_7
#define AIRGAP_SENSE_CLK_EN __HAL_RCC_GPIOE_CLK_ENABLE

// QR camera on J_CAM, [ambire_camera] (io/camera/stm32u5/camera.c): a 24-pin
// DVP module in the ESP32-CAM pinout (OV2640, OV5640 or GC2145). CAM_EN switches
// on the module's AVDD and DVDD regulators (100 k pull-down: off while the
// MCU is in reset); DOVDD is the 3.3 V rail. CAM_RST is RESETB (active low);
// PWDN is tied low at the connector. XCLK from TIM3_CH2. SCCB on I2C2 with
// 4.7 k pull-ups. DCMI: 8-bit data on the sensor's Y2..Y9 (its top byte).
#define CAMERA_EN_PORT GPIOC
#define CAMERA_EN_PIN GPIO_PIN_12
#define CAMERA_RST_PORT GPIOE
#define CAMERA_RST_PIN GPIO_PIN_0
#define CAMERA_XCLK_PORT GPIOB
#define CAMERA_XCLK_PIN GPIO_PIN_5
#define CAMERA_XCLK_AF GPIO_AF2_TIM3
#define CAMERA_I2C_INSTANCE I2C2
#define CAMERA_I2C_AF GPIO_AF4_I2C2
#define CAMERA_I2C_SCL_PORT GPIOB
#define CAMERA_I2C_SCL_PIN GPIO_PIN_13
#define CAMERA_I2C_SDA_PORT GPIOB
#define CAMERA_I2C_SDA_PIN GPIO_PIN_14
// DCMI: AF10 except D3 (PC9) and D5 (PD3), which are AF4 (ST's GPIO modes
// database for the U5)
#define CAMERA_DCMI_PINS                                                     \
  {                                                                          \
      {GPIOC, GPIO_PIN_6, GPIO_AF10_DCMI},   /* D0 */                        \
      {GPIOC, GPIO_PIN_7, GPIO_AF10_DCMI},   /* D1 */                        \
      {GPIOC, GPIO_PIN_8, GPIO_AF10_DCMI},   /* D2 */                        \
      {GPIOC, GPIO_PIN_9, GPIO_AF4_DCMI},    /* D3 */                        \
      {GPIOC, GPIO_PIN_11, GPIO_AF10_DCMI},  /* D4 */                        \
      {GPIOD, GPIO_PIN_3, GPIO_AF4_DCMI},    /* D5 */                        \
      {GPIOB, GPIO_PIN_8, GPIO_AF10_DCMI},   /* D6 */                        \
      {GPIOB, GPIO_PIN_9, GPIO_AF10_DCMI},   /* D7 */                        \
      {GPIOD, GPIO_PIN_9, GPIO_AF10_DCMI},   /* PIXCLK */                    \
      {GPIOD, GPIO_PIN_8, GPIO_AF10_DCMI},   /* HSYNC (the sensor's HREF) */ \
      {GPIOB, GPIO_PIN_7, GPIO_AF10_DCMI},   /* VSYNC */                     \
  }
#define CAMERA_VSYNC_PORT GPIOB
#define CAMERA_VSYNC_PIN GPIO_PIN_7
#define CAMERA_HREF_PORT GPIOD
#define CAMERA_HREF_PIN GPIO_PIN_8
#define CAMERA_PCLK_PORT GPIOD
#define CAMERA_PCLK_PIN GPIO_PIN_9
// GPDMA1 channel 7: free on this board (see the radio's channels above)
#define CAMERA_DMA_CHANNEL GPDMA1_Channel7
#define CAMERA_DMA_CHANNEL_NUM 7

// No revision straps on proto 0: four unconnected pins with pull-downs read
// revision 0. A later board can strap them high.
#define HW_REVISION_PUPD GPIO_PULLDOWN
#define HW_REVISION_0_PIN GPIO_PIN_4
#define HW_REVISION_0_PORT GPIOD
#define HW_REVISION_0_CLOCK_ENABLE() __HAL_RCC_GPIOD_CLK_ENABLE()
#define HW_REVISION_1_PIN GPIO_PIN_5
#define HW_REVISION_1_PORT GPIOD
#define HW_REVISION_1_CLOCK_ENABLE() __HAL_RCC_GPIOD_CLK_ENABLE()
#define HW_REVISION_2_PIN GPIO_PIN_6
#define HW_REVISION_2_PORT GPIOD
#define HW_REVISION_2_CLOCK_ENABLE() __HAL_RCC_GPIOD_CLK_ENABLE()
#define HW_REVISION_3_PIN GPIO_PIN_7
#define HW_REVISION_3_PORT GPIOD
#define HW_REVISION_3_CLOCK_ENABLE() __HAL_RCC_GPIOD_CLK_ENABLE()
