AmbireTech/ice/firmware/trezor-firmware/nordic/trezor/trezor-ble/src/trz_comm/trz_comm.c

/*
 * This file is part of the Trezor project, https://trezor.io/
 *
 * Copyright (c) SatoshiLabs
 *
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
 * You should have received a copy of the GNU General Public License
 * along with this program.  If not, see <http://www.gnu.org/licenses/>.
 */

#include <zephyr/device.h>
#include <zephyr/devicetree.h>
#include <zephyr/kernel.h>
#include <zephyr/logging/log.h>
#include <zephyr/settings/settings.h>
#include <zephyr/sys/atomic.h>
#include <zephyr/sys/crc.h>
#include <zephyr/types.h>

#include <trz_comm/trz_comm.h>

#include "trz_comm_internal.h"

#define LOG_MODULE_NAME trz_comm
LOG_MODULE_REGISTER(LOG_MODULE_NAME);

static K_FIFO_DEFINE(fifo_uart_rx_ble);
static K_FIFO_DEFINE(fifo_uart_rx_ble_manager);
static K_FIFO_DEFINE(fifo_uart_rx_management);
static K_FIFO_DEFINE(fifo_uart_rx_prodtest);

atomic_t g_suspended_flag = ATOMIC_INIT(0);

void trz_comm_init(void) {
#ifdef CONFIG_TREZOR_UART_LINK
  uart_link_init();
#else
  spi_init();
  uart_power_down();
#endif
}

bool trz_comm_send_msg(nrf_service_id_t service, const uint8_t *data,
                       uint32_t len) {
  if (atomic_get(&g_suspended_flag) != 0 && service != NRF_SERVICE_BLE &&
      service != NRF_SERVICE_MANAGEMENT) {
    return false;
  }

  atomic_set(&g_suspended_flag, 0);

  if (len <= SPI_TX_DATA_LEN) {
#ifdef CONFIG_TREZOR_UART_LINK
    return uart_link_send(service, data, len);
#else
    return spi_send(service, data, len);
#endif
  }
  return false;
}

void process_rx_msg(uint8_t service_id, uint8_t *data, uint32_t len) {
  atomic_set(&g_suspended_flag, 0);

  if (len > PACKET_DATA_SIZE) {
    LOG_WRN("Received message too long (%u bytes), dropping", len);
    return;
  }

  trz_packet_t *buf = k_malloc(sizeof(*buf));

  if (!buf) {
    LOG_WRN("Not able to allocate receive buffer");
    return;
  }

  buf->len = len;
  memcpy(buf->data, data, len);

  switch (service_id) {
    case NRF_SERVICE_BLE:
      k_fifo_put(&fifo_uart_rx_ble, buf);
      break;
    case NRF_SERVICE_BLE_MANAGER:
      k_fifo_put(&fifo_uart_rx_ble_manager, buf);
      break;
    case NRF_SERVICE_MANAGEMENT:
      k_fifo_put(&fifo_uart_rx_management, buf);
      break;
    case NRF_SERVICE_PRODTEST:
      k_fifo_put(&fifo_uart_rx_prodtest, buf);
      break;
    default:
      LOG_WRN("Unknown service");
      k_free(buf);
      break;
  }
}

trz_packet_t *trz_comm_poll_data(nrf_service_id_t service) {
  switch (service) {
    case NRF_SERVICE_BLE:
      return k_fifo_get(&fifo_uart_rx_ble, K_FOREVER);
    case NRF_SERVICE_BLE_MANAGER:
      return k_fifo_get(&fifo_uart_rx_ble_manager, K_FOREVER);
    case NRF_SERVICE_MANAGEMENT:
      return k_fifo_get(&fifo_uart_rx_management, K_FOREVER);
    case NRF_SERVICE_PRODTEST:
      return k_fifo_get(&fifo_uart_rx_prodtest, K_FOREVER);
    default:
      LOG_WRN("Unknown service");
      return NULL;
  }
}

#ifdef CONFIG_TREZOR_UART_LINK
/* The UART is the link itself and always runs: there is no separate prodtest
 * UART to start or stop. */
void trz_comm_start_uart(void) { LOG_INF("UART is the link, always on"); }

void trz_comm_stop_uart(void) { LOG_INF("UART is the link, always on"); }
#else
void trz_comm_start_uart(void) { uart_init(); }

void trz_comm_stop_uart(void) { uart_deinit(); }
#endif

void trz_comm_suspend(void) { atomic_set(&g_suspended_flag, 1); }

void trz_comm_resume(void) { atomic_set(&g_suspended_flag, 0); }
