AmbireTech/ice/firmware/trezor-firmware/core/embed/projects/kernel/build.rs

use std::path::PathBuf;

use xbuild::{CLibrary, Result};

fn main() -> Result<()> {
    xbuild::build_and_link("kernel", |lib| {
        lib.import_lib("io")?;

        lib.add_source("main.c");

        if cfg!(feature = "ambire_power") {
            lib.add_source("ambire_power.c");
            lib.add_define("USE_AMBIRE_POWER", None);
        }

        if cfg!(feature = "ambire_radio") {
            lib.add_source("ambire_radio.c");
            lib.add_define("USE_AMBIRE_RADIO", None);
        }

        lib.add_sources_in_dir(
            "../../sys/syscall/stm32",
            [
                "syscall_context.c",
                "syscall_dispatch.c",
                "syscall_ipc.c",
                "syscall_probe.c",
                "syscall_verifiers.c",
            ],
        );

        lib.embed_binary(
            xbuild::vendor_header_path("../../models", "kernel")?,
            "vendorheader",
        )?;

        if cfg!(feature = "secmon_layout") {
            embed_secmon_binary(lib)?;
        }

        Ok(())
    })
}

fn embed_secmon_binary(lib: &mut CLibrary) -> Result<()> {
    let model_id = xbuild::current_model_id()?;
    let dir = PathBuf::from(format!("../../models/{}/secmon", model_id));

    if cfg!(feature = "bootloader_devel") {
        if cfg!(feature = "unsafe_fw") {
            lib.add_object(dir.join("secmon_api_DEV.o"));
            lib.embed_binary(dir.join("secmon_DEV.bin"), "secmon")?;
        } else {
            // Take recently built secmon from Cargo's profile directory
            let dir = xbuild::cargo_profile_dir()?;
            lib.add_object(dir.join("secmon_api.o"));
            lib.embed_binary(dir.join("secmon.bin"), "secmon")?;
        }
    } else {
        // Take officially released secmon
        lib.add_object(dir.join("secmon_api.o"));
        lib.embed_binary(dir.join("secmon.bin"), "secmon")?;
    }

    Ok(())
}
