AmbireTech/ice/firmware/trezor-firmware/core/embed/io/nrf/build.rs

use xbuild::{CLibrary, Result, bail_unsupported};

pub fn def_module(lib: &mut CLibrary) -> Result<()> {
    lib.add_include("nrf/inc");
    lib.add_rust_bindings(add_rust_bindings)?;

    lib.add_define("USE_NRF", Some("1"));

    if cfg!(feature = "emulator") {
        lib.add_sources(["nrf/unix/nrf.c"]);
    } else if cfg!(feature = "mcu_stm32u5") && cfg!(feature = "nrf_uart_link") {
        // Ambire boards: the radio on a 2-wire UART, no SPI or handshake lines
        // (no SMP firmware update, no nrf_auth); replaces nrf.c, nrf_spi.c and
        // nrf_update.c
        lib.add_define("NRF_UART_LINK", Some("1"));
        lib.add_sources(["nrf/stm32u5/nrf_uart_link.c", "nrf/crc8.c"]);
    } else if cfg!(feature = "mcu_stm32u5") {
        lib.add_sources([
            "nrf/stm32u5/nrf.c",
            "nrf/stm32u5/nrf_spi.c",
            "nrf/stm32u5/nrf_update.c",
            "nrf/crc8.c",
        ]);

        if cfg!(feature = "smp") {
            lib.add_define("USE_SMP", Some("1"));

            lib.add_sources(["nrf/stm32u5/nrf_uart.c", "nrf/stm32u5/nrf_test.c"]);
        }

        if cfg!(feature = "nrf_auth") {
            lib.add_define("USE_NRF_AUTH", Some("1"));
        }
    } else {
        bail_unsupported!();
    }

    Ok(())
}

fn add_rust_bindings(builder: bindgen::Builder) -> Result<bindgen::Builder> {
    let builder = builder
        .header("nrf/inc/io/nrf.h")
        .allowlist_function("nrf_send_uart_data");

    Ok(builder)
}
