AmbireTech/ice/scripts/cleanCopper.py

#!/usr/bin/env python3
"""Remove copper that connects nothing, checked against KiCad's own connectivity.

    $KICAD_PY scripts/cleanCopper.py in.kicad_pcb [out.kicad_pcb]
    $KICAD_PY scripts/cleanCopper.py in.kicad_pcb --check   # list only; exit 1 if anything is stale

What goes (the owner's cleanup of 2026-10-17, made a tool):
  - stale copper: a piece of a net's tracks and vias (joined where ends meet, an
    end lands on a track or a via) that touches none of the net's pads. For a plane
    net that is a plane via left behind where a part used to be, with or without a
    stub; for a signal, an orphan. On GND only the tracks of such a piece go: a
    pad-less GND via is stitching, a pad-less GND track is litter (the stub on a
    stitching via at TP_SWDIO, 2026-10-17).
  - crumbs: a track KiCad's DRC calls dangling that is shorter than 0.2 mm.
  - on a net that is complete (no unconnected item of its own): a via KiCad calls
    dangling (it joins one layer only, e.g. left in the middle of a single-layer
    track after a reroute) and a dangling stub shorter than 1 mm. A net still
    waiting for routing keeps its fanouts and stubs: they are the next route's start.
Everything removed is listed. The board is re-checked by KiCad's DRC: if the
unconnected count or the copper violations get worse, nothing is written.
"""
import json
import math
import re
import os
import subprocess
import tempfile
import sys
from pathlib import Path

import pcbnew

NM = 1e6
CRUMB_MM = 0.2
STUB_MM = 1.0


def drc(path):
    out = os.path.join(tempfile.gettempdir(), Path(path).name + ".clean.json")   # never beside the board
    subprocess.run(["kicad-cli", "pcb", "drc", "--refill-zones", "--format", "json", "-o", out, str(path)],
                   capture_output=True)
    d = json.load(open(out))
    copper = sorted(v["type"] for v in d["violations"] if not v["type"].startswith(("silk", "lib_")))
    return len(d["unconnected_items"]), copper, d


def pieces(board):
    """Per net: the pad-less pieces of its tracks and vias (zones ignored)."""
    items = [t for t in board.GetTracks()]
    parent = list(range(len(items)))

    def find(i):
        while parent[i] != i:
            parent[i] = parent[parent[i]]
            i = parent[i]
        return i

    def ends(t):
        return [t.GetPosition()] if t.GetClass() == "PCB_VIA" else [t.GetStart(), t.GetEnd()]

    def touches(t, p):
        if t.GetClass() == "PCB_VIA":
            return math.dist((p.x, p.y), (t.GetPosition().x, t.GetPosition().y)) <= t.GetWidth(pcbnew.F_Cu) / 2 + 1000
        return pcbnew.SEG(t.GetStart(), t.GetEnd()).Distance(p) <= t.GetWidth() / 2 + 1000

    def on_pad(t, pd):
        # copper overlapping the pad joins it, as in KiCad's own connectivity (not only an end inside it)
        layer = pcbnew.B_Cu if t.GetClass() == "PCB_VIA" or t.GetLayer() == pcbnew.B_Cu else pcbnew.F_Cu
        if not pd.IsOnLayer(layer):
            return False
        poly = pd.GetEffectivePolygon(layer)
        if t.GetClass() == "PCB_VIA":
            return poly.Distance(t.GetPosition()) <= t.GetWidth(layer) / 2
        return poly.Collide(pcbnew.SEG(t.GetStart(), t.GetEnd()), t.GetWidth() // 2)

    by_net = {}
    for i, t in enumerate(items):
        by_net.setdefault(t.GetNetname(), []).append(i)
    for net, idx in by_net.items():
        for a in idx:
            for b in idx:
                if a < b and find(a) != find(b):
                    ta, tb = items[a], items[b]
                    same_layer = ta.GetClass() == "PCB_VIA" or tb.GetClass() == "PCB_VIA" or ta.GetLayer() == tb.GetLayer()
                    if same_layer and (any(touches(tb, p) for p in ends(ta)) or any(touches(ta, p) for p in ends(tb))):
                        parent[find(a)] = find(b)
    pads = {}
    for fp in board.GetFootprints():
        for pd in fp.Pads():
            pads.setdefault(pd.GetNetname(), []).append(pd)
    groups = {}
    for i, t in enumerate(items):
        groups.setdefault(find(i), []).append(t)
    stale = []
    for g in groups.values():
        net = g[0].GetNetname()
        if not net or any(on_pad(t, pd) for t in g for pd in pads.get(net, [])):
            continue
        stale += [t for t in g if t.GetClass() != "PCB_VIA"] if net == "GND" else g
    return stale
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
