AmbireTech/ice/(commit log)

2026-10-14 Ambire signer proto 0: netlist, placed board, gates, UV artwork
    Safe-owner hardware signer: STM32U585 + NXP SE050E2 secure element (keys
    generated inside, no seed), nRF52840 BLE module behind a hardware airgap
    switch, OV2640 QR camera, Newhaven 2.4" touch panel, GridCore Nano power
    parts. 48 x 85 mm, 4 layers, every part on the back face for the clear case.
    - tscircuit netlist (index.circuit.tsx, src/blocks) synced into
    board/wallet.kicad_pcb by scripts/syncBoard.py, as on the Nano
    - scripts/newBoard.py: outline, display-tail slots, stack-up, pours,
    keep-out rule areas, placement with 0.5 mm routing gaps
    - gates: checkNets, checkMcuAf (ST pin database), checkPinNets (datasheet
    pin tab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
2026-10-14 Placement and pin optimizers; parts allowed under the display tails
    - scripts/optimizePlacement.py: greedy quench (rotate / nudge within a
    radius / same-footprint swap) on airwire MST length + crossing penalty,
    legal by this board's own rules (0.5 mm part gaps, slots, hole rings,
    keep-outs, antenna end, sides)
    - scripts/optimizePins.py: re-picks STM32 pins per signal from ST's pin
    database (GPIO: any free pin) to cut crossings; keeps EXTI lines distinct
    - display tails are no longer footprint keep-outs; checkFpc.py fails any
    tall part under a tail instead
    - RADIO light and label under the south-west hole, beside the radio module;
    QR CAMERA label above the camera window
    Co-Author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
2026-10-14 Ratsnest-optimized placement: autorouter completes every net
    - newBoard.py runs optimizePlacement.py after legalization (radius 7 mm):
    crossings 460 -> 286, airwire 1871 -> 1714 mm
    - scripts/trialRoute.sh: autoroutes a copy with KiCadRoutingTools and reports
    failed nets / vias. Seed 3 failed / 209 vias; this board 0 failed / 207.
    Radius 4 and MCU pin swaps were measured worse and are not applied.
    - RADIO light under the south-west hole, out of the west bridge into the chin;
    hole rings 2.6 mm (M2 head); a reserved slot keeps the SECURE ELEMENT label
    - UV art rebuilt for this placement
2026-10-15 Owner's hand placement and first routing
    43 parts re-placed by hand (charger and buck-boost clusters tightened around
    U1/U2 in the chin, battery gauge moved next to the MCU's I2C, decoupling and
    crystal caps pulled in against their pins) and 38 nets routed: the power
    chain, USB, display SPI, LSE, I2C, radio SWD, charger control.
    310 track segments, 31 vias.
2026-10-15 Pre-route block wiring around the owner's routing; fix the stale MCU pin table
    - board: block wiring (each IC and its passives) and GND fanouts routed with
    humanizedKicadAutoRouter on top of the owner's copper, which stays fixed;
    the USB pair from the MCU to the USB switch is routed first. The camera bus
    and VDD11's cross-package link are left to the human, like all wiring
    between blocks. 341/341 owner items and every footprint position unchanged;
    DRC has no new items, 10 of 12 starved thermals fixed. Autorouting the
    remainder as a judge: 2 failed nets (camera knot) vs 5 before.
    - mcuAssign.json said USART1/PA9-PA10 for the radio but the netlist was never
    re-exported, so the bo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
2026-10-15 docs: the shared concept page, status line brought up to date
    Self-contained HTML (images inlined). The status paragraph now says the
    board is hand-routed with block wiring pre-routed, and counts 121 parts
    (the old 136 included the 4 holes and 11 test pads).
2026-10-16 Owner's fixes on the pre-routed board (checkpoint before rework)
2026-10-16 README: UV-art preview of the back face, rebuilt on the current placement
    The art previews were from the 10-14 placement; rebuilt on the owner's
    placement. SECURE ELEMENT no longer finds a clear spot and is left as plain silk.
2026-10-16 Simplify the netlist (-28 parts), rip my auto-routing, camera pins ordered for J_CAM
    Owner review: the pre-route was sloppy and the board too dense. This keeps all
    of the owner's copper (minus what sat on removed parts or vanished nets) and
    removes every track and via my partial router added.
    Removed / merged (research in the commit's PR notes; each change checked
    against the part's datasheet):
    - radio UART isolation: two SN74LVC1T45 + 4 caps + 3 pull-ups -> one TI
    TXU0202 (fixed A1->B1Y, B2->A2Y; Hi-Z below 100 mV on either supply,
    Ioff; SCES942A 9.3.4) + 2 caps; OE on RADIO_3V3, so the hardware airgap
    guarantee is unchanged
    - RTC backup chain (XC6206, 2 caps) and the 32 kHz crystal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
2026-10-16 Placement for routing: camera fan-in cleared, radio translator at the radio, decaps at their pins
    - J_CAM's pads are entered from the east, where the camera LDOs left 1.2 mm
    for 24 lines: the LDO cluster (now ME6211 + fixed TLV70313, shared input
    cap) moved east of a 3.1 mm "Camera fan-in" keep-out, BOOT0's pull-down out
    of the bus approach. Your camera SDA/SCL/AVDD tracks there are removed.
    - J_CAM stays: moved 4.5 mm east (to take a stock 21 mm module flat) its body
    would sit over the MCU's north pin row and cost every north camera pin a via.
    checkFpc now holds the camera tail to a budget: stock modules bow 4.2-4.8 mm
    (a ~16.5 mm custom flex lies flat).
    - TXU0202 moved to the s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
2026-10-16 Stack-up fixed (In2 solid GND, In1 the 3.3 V plane); blocks pre-routed cleanly
    Stack-up: every part sits on B.Cu, whose return currents run in In2, but In2
    was the "GND poured around power runs" layer and In1 the solid GND. Swapped:
    In2 is solid GND (DRU: GND only), In1 is a V3V3 plane (DRU: V3V3, plus the
    VDD11 core link). Every V3V3 pin and decap now drops a short via to In1, so no
    3.3 V trunk runs on the outer layers.
    Block wiring (scripts/partialRoute.py, on humanRouter's new keep-copper API
    and knobs): back copper only; GND vias only for caps and ICs, 0.25 mm clear
    of every pad, plus any pad the pour starves; no necking; test-pad, pull-up
    and power links longer than 7/10 mm are left wi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
2026-10-16 Docs and UV art for the reworked board
    design.md: stack-up roles (In1 3.3 V plane, In2 solid GND), the TXU0202 radio
    isolation and its UART pads, no RTC/LSE, fixed camera DVDD, the routing
    keep-outs, the camera flex bow decision, the gauges, and the firmware settings
    the hardware now relies on (BOOT0 via option bytes, PA0 pull-up, XCLK on
    TIM3_CH2, RX pull-up while the radio is off). UV art rebuilt on the new
    placement; SECURE ELEMENT fits again.
2026-10-16 Plane vias for 3.3 V pull-ups and connector pins
    The router's caps-and-ICs fanout policy deferred every plane pad of a resistor
    or connector, which only works for GND (the outer pours pick those up). The
    3.3 V pins of pull-ups, TP_3V3 and the J_TFT / J_CTP / J_CAM supply pins now get
    their via to the In1 plane: 18 links, 13 vias; unconnected 79 -> 61, all of them
    the buses left for the hand route.
2026-10-16 Front copper freed: V3V3 runs made redundant by the In1 plane removed
    With In1 a 3.3 V plane every V3V3 pin already has its via, so the owner's
    3.3 V runs on the front copper carried nothing but took 64.6 mm of the layer
    kept for the buses (incl. the 8.5 mm dangling stub). Removed with KiCad's own
    unconnected count as the oracle: flat at 61 (the TP_3V3 front-pad link, which
    did depend on it, is kept). The buck-boost's output now enters the plane
    through three vias at C_3V3 (two added, each >= 0.25 mm of bare board from
    every pad). Also: a 0.02 mm micro-jog on RADIO_3V3 (a 90-degree corner) gone.
    Audit (carrier suite run on this board, its ledger and current budget are the
    carrier's): of the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
2026-10-16 Review fixes: radio UART on full-speed pins, unbroken 3.3 V plane, gates and docs
    An independent review of today's changes (datasheets re-read) found:
    - Blocker: the radio UART had moved to P0.30/P0.31, which the nRF52840 pin
    table marks "standard drive, low frequency I/O only" (<= 10 kHz) -- as is
    every GPIO on the module's north edge. Moved to P1.09 (pad 17, module TX)
    and P0.05 (pad 15, module RX), unrestricted, on the east edge.
    - The VDD11 core link on In1 cut a 16 mm slot in the 3.3 V plane under the
    MCU, where the camera bus crosses on the front. It now runs on B.Cu inside
    the MCU's pin ring, as one diagonal clear of the west pins' inner escape;
    the DRU allows nothing but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
2026-10-17 Owner: SE rotated toward the MCU, pull-ups inline, SE block and charger TS routed
    Secure element turned -90 deg so SDA/SCL/ENA face the MCU's west pins; its
    three pull-ups in a column between the two, both caps moved; SE wiring, CHG_TS
    and BAT routed by hand; R_TS beside the charger. Three GND fanout vias next to
    GND pads removed (the pour plus stitching does that job).
2026-10-17 Learn from the owner's SE edit: chips face their partner, no GND via beside pads
    - optimizePlacement.place_block(): rotate an IC in place (or within 1 mm when the
    hand placement sits closer to a margin than this model allows) and rebuild its
    satellites around it, for every rotation; slide the block; keep the cheapest.
    New pin-facing term: an airwire leaving a chip's pin backwards costs 4 mm. From
    the old layout it re-derives the owner's SE orientation (-90 deg, I2C pull-ups
    inline). Without the term the cost preferred 0 deg: length and crossings cannot
    see which way a pin escapes. Fixed while building it: the search left a part's
    airwires at its last candidate instead of its ch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
2026-10-17 Placement experiment: radio gate beside the airgap switch (candidate, not merged)
    board/experiments/: the candidate with block wiring redone, ready for hand
    routing, plus the main board and the candidate autorouted to the end with the
    same deterministic router as a gauge (no GND via beside pads, pours stitched):
    the candidate needs 10 % less routed copper (1260 vs 1395 mm) and 5 fewer signal
    vias. AIRGAP_SENSE on a west MCU pin and a re-oriented UART translator were
    tried and rejected (README there).
    Tooling for the next pass: scripts/placeVariant.py (seed spots, then the block
    search per chip) and scripts/routeGauge.py (full autoroute on a copy with the
    owner's conventions; unconnected, co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
2026-10-17 routeGauge: count only craft findings the routing made
    A detour or wiggle already on the input board (the owner's snaking track the
    router merely extends with a pin stub) is no longer charged to the placement.
2026-10-17 TP_NRST next to the MCU's NRST pin
    The NRST test pad sat with the other programming pads on the west edge while
    NRST is pin 14 on the MCU's east side, behind hand-routed copper: the autorouter
    took 29.5 mm down the west edge for it. Now on the front at (33.6, 26.8), beside
    NRST's 100 nF cap: 4.7 mm of copper, one via. Same move in the radio-gate
    candidate. Unconnected 57 -> 56 on the main board.
2026-10-17 Radio gate beside the airgap switch (merged from the experiment)
    The NOR and the load switch with their parts move from the north-west corner
    to beside the airgap switch: AIRGAP and RADIO_3V3, which ran 30-40 mm down the
    west side, are now a few millimetres. Gauge (full autoroute on a copy, same
    settings): 10 % less copper to route (1260 vs 1395 mm), 5 fewer signal vias.
    Only the radio gate's parts and my copper at them changed; the owner's copper
    is untouched. Open: one 2.7 mm 3.3 V link (CT cap to the airgap pull-up) for a
    hand trace, no via fits there. UV art rebuilt.
2026-10-17 Owner: north camera pins, radio UART, display control, button and 3.3 V cleanup
    Hand-routed the camera bus's north-side pins (VSYNC, XCLK, D4, D6, D7, RST,
    SDA, EN), the radio UART from the module to the TXU0202, TFT_TE/RST, BTN/BTN_N,
    CTP_RST, I2C_SCL, AIRGAP, RADIO_3V3. Button transistor and resistor moved up by
    the MCU, the AIRGAP_SENSE resistor inline by the MCU, the radio LED parts
    shifted. 3.3 V cleanup: three stale plane vias (left where the radio gate's
    parts used to be) and stubs removed; thin 0.15 mm 3.3 V links between a plane
    via and its pad redone at 0.4 mm.
2026-10-17 Owner's cleanup rules as tools: stale copper out, power fanouts at full width
    scripts/cleanCopper.py removes copper that touches none of its net's pads
    (plane vias left where a part used to be, orphans; GND stitching is kept) and
    sub-0.2 mm dangling crumbs, and refuses to write if KiCad's DRC gets worse.
    scripts/widenFanouts.py widens each short pad-to-via link of a power net to
    0.4 mm, capped at the pad's narrow side, undoing any widening DRC objects to.
    Applied: two more stale V3V3 vias (old radio-gate spot, old front trunk) and
    two crumbs gone; 17 thin 3.3 V links widened (MCU pins 0.15 -> 0.30 mm, the pin
    width). Unconnected 40 -> 40, no new DRC findings.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
2026-10-17 3.3 V power done, block wiring autorouted, stale copper gone
    Power: every V3V3 and RADIO_3V3 pad reaches the In1 plane on a fanout as
    thick as its pad allows (0.4 mm, capped at the pad's narrow side); SYS,
    CAM_DVDD and the backlight supply are routed. The C_RCT/R_AIRPU 3.3 V pocket
    had no room for a via and no way out (the AIRGAP track closed it): R_AIRPU
    turned horizontal outside it and C_RCT joined to C_RIN pin to pin
    (partialRoute.py --link, new).
    Signals: the autorouted nets were accepted one by one (length near the
    shortest tree, no added detour, hairpin or via): the camera west group,
    CAM_D5, CAM_EN, the charger control/status lines, RADIO_OFF/EN, TFT_BL,
    AIRGAP_SENSE, I2C_SCL, SWCLK/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
2026-10-17 Owner: radio RX routed, camera I2C pull-ups moved north, CAM_SCL re-routed
    Hand work: RADIO_RXD_MCU routed (40 mm, back copper); R_CSCL moved up beside
    the camera supply output (C_AVOUT turned 180 to make room), R_CSDA 1.3 mm
    north, CAM_SCL redrawn to the new pull-up; small reroutes of CAM_D1, CAM_EN,
    CAM_XCLK, CAM_AVDD, RADIO_3V3, V3V3, AIRGAP_SENSE; 8 GND vias.
    As committed: 7 unconnected (USB MCU pair, RADIO_TXD, AIRGAP x2, J_TFT pin 40
    GND now cut off from the pour), 3 vias that connect one layer only (CAM_EN,
    CAM_D1, CAM_XCLK, each in the middle of a single-layer track) and 3 CAM_SCL
    crumbs. Cleaned up in the next commit.
2026-10-17 USB MCU pair named as a differential pair; owner's leftover vias and stubs out
    USB_DP_MCU/USB_DN_MCU -> USB_MCU_DP/USB_MCU_DN: a name ending in P/N is what
    KiCad's Route Differential Pair and humanRouter's pair detection both key on
    (USB_DP/USB_DN already did). Renamed in the tscircuit source, the MCU and pin
    maps, the net class pattern and the board; nets, AF, sync and pin-table gates pass.
    cleanCopper also removes, on a net that is complete: a via that joins one
    layer only (left mid-track after a reroute) and a dangling stub under 1 mm.
    Nets still waiting for routing keep their fanouts. Removed: the CAM_EN, CAM_D1
    and CAM_XCLK mid-track vias and three CAM_SCL stubs/crumbs; unconnected
    unc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
2026-10-17 J_TFT pin 40 joined to the GND via above the row; cleanup tools keep their DRC reports out of board/
    The RADIO_RXD route sealed the last FPC contact's piece of pour (a 0.3 mm pin
    at 0.5 mm pitch takes no thermal spokes there). A 0.2 mm track to the owner's
    existing GND via 0.9 mm north joins it, no via beside the pad. Unconnected 7 -> 6.
2026-10-17 GND: pad-to-via ties out, the board stitched to the plane
    Per the owner: a GND pad tied by a short track to a via beside it is clutter;
    the pour grounds the pad and stitching grounds the pour. scripts/stripGndTies.py
    removed 47 of the 56 ties. Kept where the part asks for a short path to the
    plane: the TPS63802 buck-boost's ground and its input/output caps, the TPS60230
    charge pump, the BQ25185 charger's exposed pad, the E73 radio module's ground
    pads, the USBLC6 ESD clamp.
    humanRouter (--keep-copper --nets GND, fanoutParts=none) then stitched every
    piece of outer pour (131 vias, ~4 mm grid, 0.5 mm clear of pads), put a GND
    return via beside 80 signal vias, and joined the pads the pour no l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
2026-10-17 Second secure element from a second vendor: Infineon OPTIGA Trust M V3
    Key model: two non-extractable keys, one in the NXP SE050 and an independent
    P-256 key in the OPTIGA (CC EAL6+ hardware), so one vendor's silicon break
    yields one key, not the device's signing authority; the account treats the
    device as one owner needing both (research.md).
    Hardware: SLS32AIA010MK (C1518668, 0 at JLC; V1 SLS32AIA010MH C539250 on the
    same land has 60) on the secure elements' own I2C4 bus at 0x30 beside the
    SE050's 0x48, RST from PD14 (pulled high, 100k), 100 nF at VCC; pins from the
    data sheet Rev 3.10 Table 6, the centre pad (not in the table) soldered but
    unconnected. KiCad's DFN-10 3x3 EP1.7x2.5 land m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
2026-10-17 Owner: USB MCU pair routed as a differential pair; charger lines moved out of its corridor
    USB_MCU_DP/DN: 70.9 / 70.3 mm (skew 0.57 mm), 95 % of the run at the class
    gap (0.2/0.25), two vias per line with a GND via 1.1-2.1 mm from each. Out of
    the MCU's west pins under the package on the back, front copper east of the
    J_TFT row and the SYS trunk (the one gap through both), back copper into the
    TS3USB221 from the north so the pair keeps its polarity.
    CHG_CE, CHG_STAT1, CHG_STAT2 (autorouted in 8e4aa7a, in that gap) rerouted;
    small moves on BAT, CAM_PCLK, CAM_SCL, SWDIO, SYS; the pad-less GND stub at
    TP_SWDIO removed; GND vias shifted.
    As committed: 3 unconnected (RADIO_TXD, AIRGAP x2); two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
2026-10-17 Clean DRC: stale copper, sloppy stubs and silk; cleanCopper --check gate
    DRC: 0 violations; 3 unconnected (RADIO_TXD, AIRGAP x2) left to the owner.
    Copper:
    - cleanCopper removed the two "3.3 V vias" connected to nothing: GND stitching
    vias at HEAD, shoved ~2 mm by KiCad's interactive router while the USB pair
    went in; a moved free via takes the net of the plane it lands in. Also four
    pad-less GND tracks (crumbs on stitching vias) and a 0.02 mm USB crumb.
    - The owner's stubs: CHG_STAT1's two segments that stopped 0.1 mm short of each
    other joined on their common 45-degree line; two zero-length USB segments and
    a 0.02 mm 0.4 mm-wide BAT sliver lying on its 0.25 mm track removed.
    - c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
2026-10-17 Redundant copper merged away; return and stitching vias for the new routing
    humanRouter --stitch-only (working tree on 2f214cb with the peer's uncommitted
    --tidy and free-via work; verified here, not trusted):
    - tidy: 53 segments lying fully on an equal-or-wider segment of their net, 65
    tracks entirely inside a pad of their net, 21 collinear splits merged. 1108 ->
    969 track records; per net and layer the copper (tracks + pads) is identical
    (0.0 mm^2 symmetric difference).
    - 6 GND return vias beside signal vias that had none within reach, 13
    stitching vias on pour the new routing changed; all free vias (KiCad will not
    re-net them).
    DRC 0 violations, 3 unconnected (RADIO_TXD, AIRGAP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
2026-10-17 Owner: AIRGAP routed, radio UART and sense lines reworked, TFT_BL and 3.3 V touch-ups
    AIRGAP 57 mm (1.36x its shortest tree, 2 vias; the rejected autoroute was 120
    mm). RADIO_RXD 39.5 mm (1.36x), VBUS_SENSE 66.7 (1.33x), AIRGAP_SENSE 12.7
    (1.33x), RADIO_OFF 24.8 (1.18x), RADIO_3V3 reworked; RADIO_TXD in progress
    (an 18 mm gap between its two vias).
    As committed: 1 unconnected (RADIO_TXD), its two half-joined vias, J_TFT's
    pin-41 tab cut off from the pour (the stub that was its only connection was
    removed), starved thermals on C_VDD11A/C_U9B, a 0.002 mm RXD crumb -- fixed in
    the next commit.
2026-10-17 Pour stubs replaced by real pour connections; TFT_BL hump straightened
    - J_TFT's mounting tabs (41, 42) are custom pads with a 0.005 mm anchor, so
    KiCad's thermal spokes degenerate and the pour never joins them; the router
    had worked around it with a "track to the pour". The footprint now gives both
    tabs a solid pour connection (zone_connect 2, a text edit: a pcbnew re-save
    rewrote the custom pads), so pin 41 is joined without a stub.
    - Every GND track running from one pad into open pour was tested alone against
    KiCad's DRC: 4 redundant ones removed (J_TFT 10 and 42, C_USBSW, C_VDD3);
    3 kept because they are the pad's only connection (U9 pin 2, 0.5 mm pitch)
    or work as its one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
2026-10-17 Return vias: 7 GND vias beside signal vias that had none within 2 mm
    CAM_EN, CAM_SCL, CAM_SDA, CAM_D5, CAM_DVDD, VBUS_SENSE, RADIO_TXD: free vias
    (KiCad will not re-net them), >= 0.5 mm from any pad, inside outer GND pour.
    No room within 2 mm for RADIO_3V3, CHG_STAT2, CAM_PCLK, CAM_D3. DRC: only the
    open RADIO_TXD (1 unconnected, its 2 half-joined vias).
2026-10-17 Owner: RADIO_TXD routed; USB pair, backlight and 3.3 V touch-ups
    RADIO_TXD 67.6 mm (62.8 front, 4.8 back, 2 vias), around the J_TFT row since
    RADIO_RXD holds the only slot through it. USB_MCU pair, BL_A/BL_K, SYS, V3V3
    and AIRGAP_SENSE nudged.
    As committed: three GND stitching vias at (18.0,50.0), (22.0,46.0), (26.0,46.0)
    were shoved 0.3-0.5 mm by KiCad's interactive router and came back on V3V3,
    connected to nothing (the "3.3 V vias" the owner saw); a 0.16 mm TXD crumb;
    J_TFT pin 10 cut off from the pour by the backlight reroute. Fixed next.
2026-10-17 Fully routed, DRC clean: re-netted stitching vias restored and made free
    DRC: 0 violations, 0 unconnected.
    - The three GND stitching vias KiCad's interactive router shoved onto the 3.3 V
    plane are GND again, and all 229 track-less GND vias are now "free" vias,
    so a shove during hand routing keeps their net.
    - J_TFT pin 10 (0.3 mm at 0.5 mm pitch) is boxed in by the backlight reroute,
    so the pour cannot reach it; a straight 0.2 mm track runs 0.7 mm past its
    end into the pour (solid connection was already set and is not enough).
    - RADIO_TXD 0.16 mm crumb removed.
    Gates pass; cleanCopper --check clean; no GND pad-to-via ties beyond the 9 kept.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
2026-10-17 Docs: seed protected by the STM32U5 alone, a device-bound slow PIN KDF
    Chain SAES encryptions under the DHUK (a hardware-unique key software cannot
    read): about a second on the device, impossible off it without first extracting
    the key from ST's silicon. Limits and the optional passphrase recorded; the
    SE050 secret as an optional extra layer; OPTIGA sourcing deprioritized in favour
    of this. Bring-up item 9: measure the SAES rate and confirm the DHUK stays
    unreadable in our TrustZone/RDP configuration.
2026-10-17 Router tidy pass: 98 stacked/split segments gone, copper unchanged
    humanRouter --tidy=only (working tree on 2f214cb, the peer's tidy not yet
    committed; checked here): 97 segments lying on an equal-or-wider segment of
    their net removed, 1 collinear split merged; every removal KiCad's DRC objected
    to rolled back (the load-bearing stubs on J_TFT pin 10, C_GAUGE, U9 pin 2 and
    eight "dangling" ends that are T-junctions). 1032 -> 934 tracks; per net and
    layer the copper differs by at most 0.001 mm^2 (end rounding). DRC: 0
    violations, 0 unconnected.
    cleanCopper counts copper overlapping a pad as joined to it, as KiCad does, not
    only a track end inside the pad: after tidy, three pieces reach their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
2026-10-17 Owner: redundant 3.3 V copper removed, reroutes tightened, C_VUSB closer
    27 V3V3 tracks (52.7 mm) that duplicated the In1 plane removed (V3V3 track
    133 -> 92 mm), GND tracks 36 -> 28 mm; small reroutes on SE_SDA, I2C_SDA/SCL,
    CHG_*, CAM_*, AIRGAP, PWR_HOLD, CTP_INT; C_VUSB 0.6 mm closer to VDDUSB.
    As committed: USB-C GND pin A1 cut off from its shell (1 unconnected), a 0.2 mm
    PWR_HOLD stub, U12's GND pad thermally starved -- fixed next.
2026-10-17 BL_K/BL_A at 0.3 mm; USB-C GND pin and camera LDO GND joined to the pour
    - BL_K had an 18.4 mm front run at 1.3 mm, 1.6 mm at the J_TFT end and 0.8 mm
    at U13, from the 8e4aa7a power pass (the router sized the backlight cathode
    like a supply rail; the source asks for W_PWR_LITE). A backlight cathode
    carries tens of mA: now 0.3 mm like its other segments; BL_A's one 0.8 mm
    segment likewise. U13 pins 3/4 joined by an explicit 0.3 mm segment (the 0.8
    mm track had joined them only by overlap).
    - J1 GND pins A1/B12: solid pour connection like A12/B1 (the reroute had cut
    A1 off from the shell). U12 (camera LDO) GND pin: solid (spokes starved).
    - PWR_HOLD 0.2 mm stub removed.
    DRC: 0 viol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
2026-10-17 Owner: width-only joins on RADIO_3V3 and SYS fixed; C_VDD2 turned to its pin
    C_VDD2 rotated 90 -> 0 and moved 1.2 mm toward its MCU pin; RADIO_3V3 and SYS
    joins that held only by track overlap (left by the router's tidy pass and older
    copper) redrawn; small touch-ups on AIRGAP, CAM_EN, CAM_DVDD, I2C_SDA,
    RADIO_RXD, TFT_TE, V3V3. DRC: 0 violations, 0 unconnected. Strict-join scan
    (every join on a pad, a via or a centreline): 24 -> 22 nets.
2026-10-17 J_BAT turned inboard in the placement source; JLC fab-file pipeline
    newBoard.py: J_BAT mouth inboard (42.6, 68.0, 90 deg) so the mated plug stays
    inside the enclosure, a "Battery plug" no-parts strip west of the mouth (about
    6 x 7 mm, an estimate to check against the cell's lead), C_BAT at (31.17,
    72.95, 180) out of the strip next to the charger's BAT pin. The board itself is
    not yet changed: the charger corner (BAT, CHG_CE, CHG_STAT2, R_STAT2/R_CE about
    1 mm south) needs a hand pass; the autorouter's attempt was worse (BAT 57 -> 76
    mm, 5 vias, CHG_CE left open).
    production/: export_fab.py (gerbers, Excellon, raw placement/BOM rows from one
    board load, fills as saved, aux origin at the outl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
2026-10-17 Docs: team page updated to the routed board and two secure elements
    docs/ambire-signer.html, the published "Ambire Signer" page (republished in
    place, same link): current back-face UV render and two fresh 3D renders
    (back with plain silk, front with the programming pads); a "board, routed"
    section (DRC clean, stack-up, USB differential pair, stitched pours, the kept
    ground vias); the silkscreen changes since 15 October; the second secure
    element (OPTIGA, may be left unfitted) and the planned STM32U5 PIN stretch in
    the architecture table; status dated 17 October with the battery connector
    turn in progress and the pre-order review's open items. Part count 99.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
2026-10-17 Front incognito: no brand on the front of the device
    The team page's front drawing and both screen mockups printed AMBIRE on the
    chin below the display; removed (page republished in place). design.md
    records the rule: no brand mark on the front (bezel, chin or case), the brand
    lives only on the back's UV artwork behind the clear case. The board already
    has no front silkscreen.
2026-10-17 Owner: J_BAT turned inboard, charger corner re-placed and rerouted
    J_BAT rotated 180 deg in place (43.0, 68.6): the mouth faces inboard, so the
    mated battery plug stays inside the enclosure; the plug strip west of the mouth
    (about 7 x 6 mm) is clear of parts. C_BAT moved to (46.67, 75.11), R_STAT2 to
    (32.19, 72.75), R_CE to (37.51, 74.25); BAT 57.3 -> 67.4 mm (2 vias),
    CHG_CE 45.7 mm, CHG_STAT2 45.8 mm. .kicad_pro: KiCad's default ERC block.
    As committed: DRC 0 unconnected, one courtyard overlap (U1 / R_STAT2);
    C_BAT now 12.7 mm from the charger's BAT pin (4.6 mm from the connector).
2026-10-17 Owner: buck-boost ground vias, L_BUCK nudged
    17 GND items added around the TPS63802 power stage (the pre-order audit's
    first should-fix: power ground and cap grounds had no low-impedance path to
    the plane), L1/L2 switch-node copper redrawn, L_BUCK 0.23 mm west.
2026-10-17 Pre-order fixes: charger pad vias, silk widths, SWD labels, touch slack, OPTIGA DNP
    - OPTIGA (U16) DNP on proto 0 with its decap and reset pull-up (JLC has none;
    part numbers kept in a comment for fitting later). JLC places 96 parts.
    - BQ25185 charger exposed pad: two GND vias (0.45/0.25 mm, free) at x 34.32 /
    34.87, clear of the SYS track on the front.
    - Back silk: all six legends at JLC's 0.15 mm minimum stroke (were 0.12);
    newBoard writes them that way.
    - Front silk: labels for every programming pad (3V3/DIO/CLK/GND/RST, MCU SWD
    and RADIO SWD); a new ground pad TP_RGND in the radio SWD row (the nearest
    GND pad was 47 mm away).
    - J_CTP 1.5 mm south (CTP_SLACK in newBoard): the to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
2026-10-17 stripGndTies: keep the owner's C_USBSW/R_FB2 tie (the pour is cut there without it)
2026-10-17 Owner: V3V3 and I2C_SDA touch-ups
    Seven V3V3 and three I2C_SDA segments redrawn (six and three). DRC as saved:
    0 violations, 0 unconnected. The JLC set in production/out was regenerated
    from this state (96 placed parts, BOM/CPL parity, all in stock for 10).
2026-10-17 JLC order set with colour print, built and checked by one command
    production/make_order.sh builds production/order from the board:
    - jlc-colour/wallet-colour-jlc.zip: the Gerbers in EasyEDA Pro form with the
    bottom UV print, to upload at JLC (white mask, ENIG, "EasyEDA multi-color
    silkscreen"). The plain-silk labels the artwork replaces are left out of it.
    - jlc-plain/wallet_gerbers.zip: the same board, ordinary silkscreen.
    - wallet_bom-jlc.csv / wallet_positions-jlc.csv (96 parts, bottom side),
    rotation-review.csv, stock.csv, PREFAB-CHECKS.txt.
    The colour file (.FCBS) is ours, production/colour_silk.py: EasyEDA's SVG
    (print image, white base, solder-mask openings carved out) encrypte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
2026-10-17 OPTIGA fitted in the BOM again; colour zip dropped from the default order set
    - U16 / C_OPT / R_OPTRST carry their JLC numbers again (owner: DNP it in JLC's
    order UI while JLC has none). BOM/CPL 99 parts; the stock check reports the
    OPTIGA as "DNP at order" instead of failing.
    - JLC did not offer its colour option for the generated colour zip: it has
    blocked non-EasyEDA colour files since 27 Jan 2026 and changed again in Aug
    (TransJLC issues #10/#11). make_order.sh builds the colour set only with
    COLOUR=1, kept for reference; the default order is the plain JLC set.
    All pre-fab checks pass.
2026-10-17 PCBWay order set with the full-colour UV back print
    production/build_pcbway.py, run by make_order.sh, writes production/order/pcbway/:
    - wallet_pcbway_fab.zip: KiCad Gerbers + drills (back silk without the labels the
    art replaces), the 1200 DPI print image sized to the outline (transparent = no
    ink; art/build_uv.py keeps pads, holes and the camera window clear) and a
    positioning image (back layers seen from behind, print placed on them)
    - wallet_bom-pcbway.csv: turnkey BOM, manufacturer + MPN from JLC's parts API,
    LCSC code as distributor part number
    - wallet_centroid-pcbway.csv: 99 bottom-side placements, mm, KiCad rotation
    - ORDER-NOTES.txt: order form settings and the remark for P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
2026-10-17 Enclosure generator and a 3D case preview on the concept page
    enclosure/generate.py builds a two-part case (back shell + snap-on front
    bezel) from the board itself: outline, slots, holes, camera keep-out and the
    power button's land from wallet.kicad_pcb, and every modelled part from
    kicad-cli's GLB export. The deepest part sets the back cavity; parts crossing
    the board edge get wall openings sized from their geometry, and an edge part
    with no opening rule, an unmodelled part with no height bound, a screw head
    on the cell or a boss with too little pilot wall stops the build.
    Result: 52.2 x 89.2 x 18.0 mm; the hand-fitted camera head (5.9 mm) sets the
    back depth. Panel stack from Newhaven's d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
2026-10-17 Concept page: 3D preview loads under the artifact CSP; status written for the team
    The host's CSP blocks fetch() of data: URIs, which three's GLTFLoader used for
    the inlined glTF buffer. The generator now ships each part as base64 GLB bytes
    in a .json file and the page parses them in memory.
    Status: first three devices ordered through JLCPCB, plain purple back (no
    colour print this run), firmware next, Safe signer first.
2026-10-17 Concept page: KiCad board in 3D, flame print schemes, configurator with DIY downloads
    - The preview's board is now KiCad's own 3D export (body, soldermask, pads,
    every part model; no silkscreen), packed per material as uint16 meshes in
    docs/enclosure/board.json (2.8 MB). The art texture is gone.
    - Back print: the Ambire flame alone (facets from the official logo, no
    wordmark), in the board's reserved artwork panel. Five schemes, ink on mask:
    purple on neon, purple on black, white on black, black on white, purple on
    white; the mask recolours with the scheme.
    - Case: purple, clear, or none (Frosted removed); none shows the case files.
    - Configurator beside the model: Order to a PO bo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
2026-10-17 Back print: the flame across the whole back, not in the logo panel
    45.6 x 68.6 mm, as wide as the board less 1.2 mm a side, centred, printed
    between the parts; a 0.35 mm hairline of mask between facets.
2026-10-17 Concept page: 'The solution' row of four points before the device configurator
2026-10-17 Concept page: sales copy, Incognito print, power button and camera connector in 3D
    - Power button and camera connector were missing from the 3D board: their
    footprints name KiCad library models that KiCad does not ship. Vendor STEPs
    from LCSC (C110293, C262567) added to 3d/ and board/models.json (zero
    offset: body, plunger tip and height match the land); applyModels.py puts
    them on the board once KiCad is closed. Until then generate.py stands
    models.json in for any missing model file in its export copy.
    - The modelled plunger crosses the east board edge; the generator now treats
    the flex tab as its opening and fails if the plunger leaves the tab window
    or reaches past the land'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
2026-10-17 Concept page: brand redesign
    - Dark, single-theme look from the Ambire brand: Ambire Black base, Purple and
    Violet accents, Volt only on calls to action, Poppins headlines, the
    brand's film grain. Every section opens with an eyebrow and a headline.
    - Hero band on the brand's dark silk background with a product shot of the
    device, rendered from the page's own 3D model (enclosure/render_hero.sh ->
    docs/brand/signer.webp), calls to action and three headline numbers.
    - Cards for the losses, the four points (solid white glyphs on purple tiles:
    the flame, ambire.com's open-source badge, a lattice and an eye), the
    configurator, the clear-signing mock-ups, Inside and Architecture; status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
2026-10-18 Enclosure: 1 deg draft on both halves, widest at the parting line
    The back is 0.30 mm and the front 0.33 mm narrower than the parting line.
    Both halves still print flat face down without supports; the generator
    refuses a draft at or past 45 deg. Hero image re-rendered.
2026-10-18 Enclosure: draft 1 mm in total instead of 0.3
    Set in millimetres now: the back and front faces are 1.0 mm narrower than the
    parting line (3.3 / 3.1 deg); the wall keeps 1.30 mm at its thinnest, and the
    generator refuses anything under 1.2 mm or a draft past 45 deg.
2026-10-18 Board: the flame in ordinary silkscreen on the back, wordmark removed; 3D models applied
    - scripts/silkFlame.py prints the Ambire flame across the back in plain
    (single-ink) silkscreen: 45.6 x 68.6 mm, a 0.35 mm gap between facets, cut
    back 0.15 mm from pads, drilled holes and vias, 0.3 mm from the edge and
    slots, 0.5 mm around the human-readable labels (QR CAMERA, SECURE ELEMENT,
    AIRGAP, RADIO, ANT) and 0.15 mm from footprint silkscreen. 67 polygons,
    964 of 1252 mm2 of ink kept. Lives in group FLAME; a rerun replaces it.
    - The "AMBIRE" and "Ambire signer · proto 0" texts are removed.
    - It runs DRC on a copy (project rules, library table) and installs only if
    the findings do not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
2026-10-18 Enclosure: screws from the back into bosses in the front half
    - Shell: four standoffs under the board's holes with M2 clearance holes and
    counterbores in the back face (45 deg roof, prints without support); the
    heads sit flush. The standoff at the camera corner is notched for the head;
    the check is now the screw-to-part clearance (0.53 mm, at least 0.3).
    - Bezel: four bosses with 1.6 mm pilots at the board's holes, standing in the
    battery's layer under the screen's corners and carrying the screen. Under
    the screen their undersides rise 45 deg from the fills, so the bezel still
    prints face down without supports. Fills along the glass edges locate the
    screen (replacing the corner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
2026-10-18 Order set rebuilt from the board with the flame silkscreen
    production/make_order.sh: every pre-fab check passes (DRC 0/0 as saved and
    after a refill, nets, pins, lands, stock, drill census, BOM/CPL parity). The
    JLC gerbers carry the flame; the PCBWay colour-print image is still the older
    light-beams artwork (art/build_uv.py).
2026-10-18 Concept page: Safe mark and a fifth point (Trezor compatible); preview data for the screwed case
    - First point shows the flame and Safe's mark (from ambire.com's Safe
    section); new card "Trezor compatible" with a link glyph (not Trezor's
    logo). The row fits five cards and wraps on narrow screens.
    - Preview data regenerated: the case with back screws and front bosses, the
    hero shot re-rendered, the DIY board files are now the next run's (flame in
    white silkscreen).
    - .gitignore: art/__pycache__/.
2026-10-18 Firmware: T3T2 board ambire_p0 (SPI display, power latch), Docker build
    Port of the vendored trezor-firmware (5fdc180) to proto 0, as a new board
    of Trezor's T3T2 model:
    - models/T3T2/boards/ambire_p0: pins from src/parts/mcuAssign.json;
    ST7789 over SPI1, FT5426 touch on I2C3, on/off backlight, no OPTIGA
    (not fitted on the first boards), no radio.
    - display_spi driver: the i8080 driver's panel code over 4-wire SPI,
    polled commands and a GPDMA frame push as 16-bit frames.
    - Boardloader drives PWR_HOLD high first thing, before the option-byte
    programming that can reset.
    - SMP moved from the T3T2 model to the devkit board: it needs the nRF,
    and pulled the nRF driver into every T3T2 b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
2026-10-18 Docs brought up to date: status, firmware fork, board flow in its own doc
    README: status of the first order, the flame render as hero, routing credit,
    a short firmware section pointing to firmware/README.md, similar projects.
    docs/board-flow.md: the commands and order-time steps, moved out of README
    and design.md. design.md: radio gate beside the airgap switch, keep-outs as
    the board has them, OPTIGA not fitted, stock as of 2026-10-18. direction.md
    and art/README.md: flame done in silkscreen, the PCBWay colour print still
    the old artwork (and its silk Gerber still carries the white flame).
2026-10-18 Concept page: show the screws and the front half's bosses
    The bosses were in the preview data but never visible: they face the board
    inside the front half, and Take apart only spread the stack along Z, so the
    screen, battery and board stayed in front of them; the translucent plastic
    washed them out too.
    - Take apart now lifts the front half out above the stack with its inside
    toward the viewer (bosses with their pilots, the screen fills, the chin and
    its ribbon windows); the camera re-centres and backs off to keep everything
    in frame, and the case turns less see-through while apart.
    - The four M2x10 screws are drawn: heads in the shell's counterbores when
    assembled, backed out of th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
2026-10-18 Concept page: publish to GitHub Pages
    A workflow stages docs/ambire-signer.html as the site's index with only the
    files it loads (brand/, enclosure/) and deploys it on pushes that touch them.
    The rest of docs/ stays out of the public site. Needs Pages' source set to
    GitHub Actions in the repo settings.
2026-10-18 Colour print: the flame in Purple replaces the Flare art
    - art/build_uv.py prints the same flame as the silkscreen (art/flame.py),
    in Ambire Purple with the 0.35 mm facet gap, on the base of a purple scheme
    from docs/direction.md: --scheme neon (Volt, default), black or white.
    The Flare beams, the logo with its wordmark and the other two directions
    are gone, with directions.png and the unused simplified logo.
    - Labels (now including ANT) are set in Poppins exactly where the owner put
    the silkscreen text, same size and angle, on a 0.5 mm island of base,
    instead of being moved to the nearest spot clear of parts (AIRGAP and ANT
    found none). --schemes renders schemes.png, the three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
2026-10-22 Case colours: ice blue, orange, purple (transparent tints) and clear
2026-10-22 Research: one AAA cell (which cells, runtime, charging only NiMH, power ICs)
2026-10-22 Netlist: one AAA cell (LTC3539 boost, BQ25172 NiMH charger, USB buck + TPS2116), buzzer, optional edge buttons
    The pouch, its BQ25185 charger, the TPS63802 buck-boost and the MAX17048
    battery gauge go. The cell sits in two SMT clips on the front face; an AO3416
    blocks a reversed cell; the MCU reads the cell at both clips and on an NTC and
    gates the charger. Backlight pump now on V3V3. Four side buttons as DNP lands.
    New lands: AAA clips, LTC DCB8 (0.45 mm pitch), 4020 inductor, buzzer.
2026-10-22 Concept page: restore proto 0's case colours (proto 1 lives at /v2/)
    The team page stays as it was at e11af05; the new colours and everything
    proto 1 go to docs/v2/.
2026-10-22 Netlist: joystick replaces the buttons and is the power key; buzzer MLT-5020; charger via one dual FET
    - ALPS SKRHAAE010 (four directions + centre push, reflowable, JLC C202423) on
    the front. The directions share one ADC line through a resistor ladder
    (15k/27k/47k/100k from a 15k pull-up; 110 mV minimum step). The centre press,
    held, switches a PNP from the cell onto the boost's enable: no side power
    button, no edge buttons.
    - Buzzer: Huaneng MLT-5020 (5 x 5.5 mm) instead of the 7.5 mm KLJ-7525, whose
    9 mm land fits nowhere.
    - Charger: one 2N7002DW holds the BQ25172's TS low (off by default) and
    switches the second ISET resistor; the MCU reads the TS NTC for dT/dt.
    A BAS116 fro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
2026-10-22 Board proto 1: 48 x 87 mm, AAA clips and joystick on the front, routed
    - Board 2 mm longer at the south for the joystick below the cell. Display slots
    2 mm south (no pouch to drop through). H3 to (3.2, 63.0).
    - E73 turned 180 degrees: the antenna points south at the edge, away from the
    cell. The antenna keep-out is now derived from the module's pads.
    - Routed with humanizedKicadAutoRouter plus hand fixes. DRC 0/0, every gate
    passes, cleanCopper clean.
    - checkFpc: antenna faces south, the cell stays clear of the antenna keep-out,
    the clips are on the front, the charger NTC sits under the cell.
    - stripGndTies keeps the boost, buck, charger and reverse-FET ground ties.
    - silkFlame: sort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
2026-10-22 Order set for proto 1: assembly on both sides, the AAA cell hand-fitted
    - PCBWay notes take the board size from the print image and list which parts
    go on which side (129 bottom + 3 top: the cell clips and the joystick).
    - Pre-fab checks add a NOTE to choose both-side assembly in JLC's order form.
    - Hand-fit list: one AAA cell in the front clips replaces the LiPo pouch.
    - Regenerated: all checks pass (DRC 0/0, 132 parts in 64 lines, stock ok for
    10 boards; the OPTIGA is out of stock and is DNPed at order time).
2026-10-22 Enclosure and concept page v2 for proto 1
    - Case 52.2 x 91.2 x 11.5 mm (proto 0: 18.0). The back cavity (4.0 mm) is set
    by USB-C; the camera head stands out through a window in the back, the AAA
    cell through an opening in the front's chin.
    - No pouch layer: locating pins under the screen, two M2 screws at the south
    holes, a hook ridge along the north wall.
    - Joystick pocket and 6 mm hole, buzzer port, cell opening; DNP parts left
    out of the cavity.
    - docs/v2/: the concept page for proto 1 (ice blue, orange, purple, clear),
    with its own model, downloads and hero render, published at /v2/ and not
    linked from the proto 0 page.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
2026-10-22 Docs: proto 1 (AAA cell, joystick power key, buzzer, standby, case)
2026-10-22 Concept page v2: ice blue by default, no cell drawn, neon print off
    - Ice blue is now a saturated see-through azure. The stage's glow follows the
    case colour (the purple glow behind made ice blue read lavender), and a
    Fresnel term lights the case's edges.
    - Default: ice blue case, purple flame on a black board. The AAA cell is no
    longer drawn; the case keeps its opening.
    - Purple on neon is left out of the configurator (offered: False in
    generate.py's PRINT_SCHEMES).
    - render_hero.sh renders the page's defaults. Its scheme patch had stopped
    applying without an error; it now checks that every patch applies.
2026-10-22 Board: joystick centred below the cell; planes reach the 87 mm edge
    - Joystick to (24.0, 80.8): centred, 0.2 mm north of the radio antenna's
    keep-out. USB-C moved east to x 33.6 (its shell legs went through where the
    joystick's land now is); the USB buck block moved west into USB-C's old spot;
    ladder and CC resistors re-seated. Cell clips 0.25 mm north, as far as the
    touch tail's slot allows.
    - The bottom strip rerouted with humanizedKicadAutoRouter: USB pair first, then
    power, then signals; two overshooting stubs trimmed, two GND ties stripped.
    - Fix: the four copper zones (front/back GND pours, In1 3.3 V plane, In2 GND
    plane) still ended at y 85 from before the board grew to 87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
2026-10-22 Case for the centred joystick: cell opening cut to the cell between the clips
    The cell opening is the clips' outline over the clips and the cell's own width
    plus 0.3 mm between them, which leaves 0.7 mm of bezel to the joystick hole.
    The build stops if that strip gets under 0.6 mm. USB-C opening follows the
    connector to x 33.6. Page data, downloads and hero re-rendered.
2026-10-22 Board WIP: cell clips 1.1 mm north, H3 out; low-quality routes ripped for the owner
    - Cell clips to y 70.44: the east clip's arm now stands over the touch slot's
    south half, clear of the tail's drop. newBoard.TAIL_BEND/TAIL_CLR and a new
    checkFpc check: no front part body and not the cell in a tail's drop (it
    fired on a 2.5 um overlap before the final 0.01 mm nudge).
    - Mounting hole H3 removed for now (the west clip sits over its boss); HOLES is
    keyed by reference so H4 keeps its name.
    - Routes ripped for the owner to finish by hand (23 airwires): the joystick
    nets JOY_A/B/C/CEN and JOY_DIR's bottom-strip part (detours up to 11x),
    SW_USB (switch node through two vias), RADIO_TX (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
2026-10-22 Netlist: schematic review fixes; radio's 3V3 and GND test pads dropped
    From a datasheet review of the AAA power path:
    - The TPS2116's PR1 now comes from a 150k/100k divider from VBUS, gated by
    the TLV62569P's power-good. Power-good goes high-impedance once VIN is
    under 1.4 V (SLVSDG1C Table 1), and its old pull-up to the slower-decaying
    V3V3_USB then switched the mux back to the dead USB input and sagged the
    rail after an unplug.
    - The LTC3539's output gets a second 22 uF and the 33 pF feedforward across
    the top divider resistor (>= 22 uF real capacitance, feedforward 'usually
    required').
    - The charger's TS-hold pull-up goes to the charger's own input
    (V3V3_USB), so the hold is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
2026-10-22 Board: USB power path on the front, the chin left unrouted for the owner
    - Double-sided chin: the TLV62569P buck block sits on the front between
    USB-C's shell legs, over VBUS; the TPS2116 mux and its caps beside it.
    The joystick's ladder moved into the space freed on the back; the
    boost's new caps, the power-good divider and the charger's hold pull-up
    (now in the chin, by the charger) seated with their chips pinned. The
    joystick and USB-C did not move.
    - Scored with humanizedKicadAutoRouter (routeGauge) on the chin, against
    the committed board: 840 -> 726 mm of copper, 82 -> 76 signal vias, no
    detours (3 before), 0 unconnected (1 before).
    - The chin is unrouted (airwires) for t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
2026-10-22 Case: pockets for the front's power parts; one screw while H3 is out
    - Every fitted front part in the chin (the USB buck block, the mux) gets a
    pocket in the bezel: its fab outline + 0.3 mm, its height + 0.3 mm; the
    build stops if under 0.8 mm of bezel is left over one, or a part has no
    height. fab_world() reads fab rectangles and polygons too.
    - One screw is accepted only while the west hole H3 is out (MIN_SCREWS,
    reported in the build log); two is the design.
    - Cell opening follows the clips 1.1 mm north: the joystick hole is now
    1.81 mm from it. Page data and hero re-rendered.
2026-10-22 Docs: double-sided chin, trace widths, review corrections, bring-up checks
    - design.md: parts on both faces, the trace widths and why the cell path is
    the bulkiest, three mounting holes (H3 out for now), one screw.
    - Corrections from the schematic review: power-good's pull-up from VBUS, the
    cell temperature only while USB is in (one NTC, the charger's), off draw
    ~1 uA typ / <= 2.5 uA max, AO3416 threshold up to 1.1 V, latch hold
    ~0.6-0.7 s.
    - Bring-up checks 15-18: unplug handover, start-up at 1.05 V, programming
    order, joystick direction codes.
2026-10-22 Docs: the final placement's router score (809 mm, 71 vias, 0 unconnected)
    The board commit efe65ab quotes 840 -> 726 mm: that was the trial before the
    schematic review's four parts went in. With them and the new net classes the
    chin routes with 71 signal vias (82 before), 809 mm (840), 0 unconnected (1).
2026-10-23 Board: owner's hand routing of the chin (as saved)
2026-10-23 Placement tooling: lessons from the owner's hand pass on the chin
    - checkFpc: front parts under the cell must stay 0.3 mm under its underside
    (0.25 mm up on the axis, rising as a circle; the largest AAA is the worst
    case). Fires on R_JB as the owner placed it (0.08 mm to spare).
    - optimizePlacement: a decap belongs at a chip's rail pin, never a
    connector's (the USB buck's input cap had landed on USB-C's VBUS pin);
    every drilled hole blocks both faces (a front resistor was placed over
    USB-C's peg).
    - placementScan.py (new): supply decaps far from their pin, two-pad parts
    with a net that only reaches the other face (a via each). On the old
    placement it lists exactly what the owne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
2026-10-23 Board: placement pass on the owner's routing, scored with the router
    The owner's copper is untouched. Moved, all unrouted:
    - R_JB into the owner's ladder row (it stood 0.08 mm under the cell).
    - The radio's SWD pads beside the module's SWD pins, east of the JOY_A run
    that walled them off (trial route 23/24 mm -> 3.0/3.3 mm).
    - The radio's decaps: 100 nF 5.8 -> 2.3 mm, 10 uF 5.6 -> 2.5 mm from pins.
    - R_FBU2 off USB-C's D+/D- pins (room for the pair's crossing via), clear of
    USB-C's peg; C_BOOST2 off the via spot under the mux's VIN2 pin.
    Trial route of what is left (humanizedKicadAutoRouter, under-part-jumps):
    764 -> 644 mm, 67 -> 58 signal vias. Still blocked by routed copper, for the
    o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
2026-10-23 Board: owner's hand routing, second pass (as saved)
2026-10-23 Board tools: shorter slots, nudges, group moves, the owner's acceptance test as a tool
    - newBoard: SLOT_MARGIN 0.75 -> 0.45 (the panel locates the tails: ~0.2 mm
    placement + tail width +-0.1), copper edge clearance 0.3 -> 0.25 (JLC: 0.2).
    resizeSlots.py redraws the two slots from those constants on a hand-worked
    board (dry run by default, refuses if DRC gets worse).
    - nudgeApart.py: crowded parts step apart (<= --max mm) where the placer's
    legality allows, their tracks dragged along (the owner: "they just need
    renudging").
    - moveGroup.py: parts moved rigidly with the copper between them; tracks
    leaving the group stretch; free stitching vias under the new outline go.
    - keepQuality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
2026-10-23 Board: shorter slots, charger corner re-nudged, USB switch turned, quality routes kept
    On the owner's second routing pass (52d21b9):
    - Slots 0.3 mm shorter at each end, copper 0.25 mm from edges: the middle
    bridge 2.61 -> 3.25 mm wide (copper 2.0 -> 2.7 mm), the east 3.73 -> 4.05.
    - Charger and boost passives nudged apart (16 parts, <= 0.5 mm each, tracks
    dragged): R_TMR's clearance to CHG_STAT fixed, most courtyards 0.16-0.35 mm
    apart now. Two GND stitching vias that sat 0.05 mm from others removed.
    - The USB switch U6 turned so its MCU-side pins face west, towards the pair's
    bridge (they faced the TFT slot 0.45 mm away: the pair could not start), the
    ESD clamp 0.8 mm south to mak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
2026-10-23 Docs and case: bridge widths after the slot change; case regenerated
2026-10-23 Board: owner's hand routing, third pass (as saved)
2026-10-23 Board: MCU USB pair at 0.15 mm on two lanes, finished into the switch; quality routes kept
    - USB_MCU_DP/DN 0.2 -> 0.15 mm on the owner's centrelines (0.3 mm gap), USB netclass
    0.15. Past the air-gap switch the pair now runs on two lanes instead of three: one
    symmetric 0.625 mm bump around each shield pad, straight between the pegs. Coupled
    94 %/94 %, DRC unchanged. The router closed the last ~1 mm into the USB switch's pins.
    - Router pass (under-part-jumps + nudge), filtered by keepQuality: kept V3V3_USB (11.6 mm
    over 10.9 mm of gaps, its neck at the power mux widened to 0.3), VBUS_SENSE merge, stub
    crumbs; 14 nets given back. Unconnected 29 -> 26.
    - keepQuality: designer copper th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
2026-10-23 Board: owner's hand routing, fourth pass (as saved): fully routed
    DRC: 0 unconnected, no copper findings; 11 silk overlaps and 13 silk-over-copper left.
2026-10-23 Board: flame silkscreen regenerated around the moved parts; DRC clean
    silkFlame.py rerun: 24 silk findings (flame over C_RIN, the charger's R_TMR/R_VSET/R_ISET/
    C_CHGIN, C_USBSW, C_RADIO2) -> 0. KiCad DRC: 0 violations, 0 unconnected.
2026-10-23 Lessons from the owner's fourth pass; the air-gap switch's shield ties kept
2026-10-23 Board: router slabs narrowed, boost switch node at full width
    - Six slabs the router's early `fatten` pass left, narrowed to the copper they join:
    3.3 V 1.6 -> 0.4 mm on the buzzer pad (and its now-redundant second plane via
    removed), 1.3 / 1.0 / 0.8 mm slivers by the OPTIGA cap, the radio level shifter's cap,
    the buzzer cap and the backlight input cap, radio 3.3 V 0.6 -> 0.4 mm between the
    radio switch's pins. No join hangs on track width (pad pieces unchanged).
    - SW_BOOST from the inductor toward the LTC3539: 0.4 -> 0.8 mm (its class), up to the
    last segment into the DFN pin.
    - Re-laying the detoured lines one at a time with the router gave nothing to keep: its
    shorter CHG_STAT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
2026-10-23 Concept page v2: the AAA cell's clips drawn again (no cell); hero from the front
    - The 3D model draws the two steel clips on the board's front (base, end wall, arms);
    the cell itself stays out, as before. They move with the board when taken apart.
    - render_hero.sh shoots the front, low on the chin: screen, joystick and both clips
    (the back view showed none of them). Hero alt text and size follow.
2026-10-23 Board: owner's hand routing, fifth pass (as saved): USB-C pair finished, clean-ups
2026-10-23 Board: flame silkscreen regenerated after the fifth pass; no silk findings
    Routing untouched.
2026-10-25 Board: owner's clean-ups (as saved)
2026-10-25 Board: owner's clean-ups, second round (as saved)
2026-10-25 Board: owner's routing clean-ups (as saved)
2026-10-25 Board: the cell to the back, the radio to the front; chin re-placed by trial routes
    - Cell clips (MY-AAA-19-J/20-J) on the back, axis at y 72 between the slots and USB-C.
    - E73 radio on the front, antenna still south (6 mm from the cell, other face); its
    SWD pads on the back beside its SWD pins; keep-outs refreshed (the no-tracks area
    under the module follows its face).
    - Front chin: boost block, reverse-cell FET and gate diode, power key, radio decaps.
    Back: USB switch + ESD clamp beside USB-C, charger block north of the slots beside the
    middle bridge (where Q_CHG/R_CHGHI already sat), cell sense / NTC / CC pull-downs
    under the cell's flanks (low parts, 2+ mm off its axis).
    - Ever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
2026-10-25 Board: owner's hand routing after the cell move (as saved)
2026-10-25 Board: chin finished by the router around the owner's routing; placements fixed
    - Reverse-cell FET on the back's west bridge right above the cell's minus clip; its gate
    diode and 1 M pull-up together in the back's east strip by the east bridge (BAT and
    V_BOOST pass there): one REV_G line instead of a scattered network.
    - Charger block rebuilt (Q_CHG turned, its gate pull-down at the gate); the VBUS sense
    divider beside USB-C under the cell's flank instead of north of the slots.
    - Boost feedback cluster re-seated south of the output caps (it violated the slot
    edge and its own tracks under the CTP slot); radio decaps no longer overlap.
    - Vias out of pads: stitching vias under R_ISET an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
2026-10-25 routeDefects.py: list routing defects for the owner to fix (hops, GND tracks, vias in pads, ...)
2026-10-25 Board: owner's fixes after the router pass (as saved)
2026-10-25 Board: owner's fixes, second round (as saved)
2026-10-25 Board: quality pass on the owner's routing (DRC unchanged: 45 findings, 4 unconnected)
    Each fix applied alone and kept only when KiCad's DRC showed no new finding and no
    more unconnected items; every track touched stays on 45-degree steps.
    - vias out of the touch FPC connector's pins (I2C_SDA, I2C_SCL, CTP_RST), each with
    a short stub; 10 more vias moved off pads they crowded (CAM_SDA at the MCU, SE_SCL,
    CAM_EN, PWR_EN, V_BOOST, TFT_BL, ...), with a 45-degree jog where a track could
    not slide; BTN and FB_BOOST vias re-routed off R_EN and the boost chip's pin
    - 8 V-turns chamfered (CELL_SENSE, CELL_N_SENSE, RADIO_3V3, V3V3 x2, V3V3_USB,
    VBUS_SENSE, CAM_DVDD, SE_VCC)
    - 15 GND tracks re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
2026-10-25 Board: owner's improvements after the quality pass (as saved)
2026-10-25 The owner's GND ties are deliberate: kept by stripGndTies, skipped by routeDefects
    Owner (2026-10-25): "some pads-to-gnd are on purpose and made by me to avoid
    fragmenting ground with pours". KEEP gains the charger's gate FET, ISET/VSET/input-cap
    pads, the TXU0202's ground, the SE050's ground pins and the camera LDO's decap tie;
    routeDefects skips every link of a tie piece that reaches a kept pad (it listed the
    chain links between pads before). GND findings on a547dda: 16 -> 1 (J_TFT.10's stub
    into the pour).
2026-10-25 Board: owner's fixes of the jump clearance and R_BTN's thermal (as saved)
2026-10-25 routeDefects.py: "neck", a power track much thinner than its class with wide copper at both ends
    The router's chin pass (f5cf3e3) ran the cell's return BAT_N at 0.8 mm, then 0.15 mm
    into the cell-sense resistor's pad, then 0.8 mm on to the clip: the whole cell current
    through a signal track, unseen by DRC and by three review passes. The check flags a
    track under 60 % of its class width (classes of 0.3 mm and up) where wide copper of the
    net meets both ends, unless the net's wide copper or pads cover it. A thin tap into a
    pad that goes nowhere else stays fine. On f5cf3e3 it finds the BAT_N neck; on 931c2a9
    (the owner's fix) one left: V_BOOST, 0.15 mm from the LTC3539's output to its via.
    Co-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
2026-10-25 Board: GND stitching thinned (385 -> 227 vias), flame silkscreen regenerated; DRC clean
    Stitching: a free GND via goes when another kept via within 3 mm reaches the same
    pour island on each outer face, or its island is a pad-less sliver under 3 mm2 that
    the fill drops anyway. Kept: vias on GND ties and in pads, the radio module's ground
    (within 1.5 mm of it), and vias within 1 mm of the switching-loop pads stripGndTies
    keeps. DRC: no new finding, 0 unconnected.
    Silkscreen: silkFlame.py rerun around the charger block (moved with the cell) and
    C_U9B (turned); R_ISETH's east tick dropped where it overlapped Q_CHG's outline.
    DRC with every severity: 0 violations (one footprint-vs-library note fo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
2026-10-25 CLAUDE.md: check power widths (the BAT_N neck)
2026-10-25 Board: owner's AIRGAP fix (as saved)
2026-10-25 routeDefects.py: real defects only, each tested on merit, never on who drew it
    Owner (2026-10-25): the checks were "overly sensitive about everything", and "whether
    something stays shouldn't depend on whether I did it, but on whether it's actually good".
    - hop: listed only when the run's own layer offers a way at most 1.3x + 1 mm (octilinear
    grid search with the board's clearances, edges, keepouts); a forced crossing is not
    - acute: open copper only (not at a pad or via), under 80 degrees; 0-degree doubled-back
    pieces are stubs
    - stub (new): track covered by other tracks of its net, zero length, dangling
    - thin-fanout (new): 3.3 V plane fanouts thinner than min(0.4 mm, the pad's narrow s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
2026-10-25 Board: 54 stubs removed, R_ISETH back to its library silk; DRC clean at every severity
    - 54 tracks under other tracks of their net (doubled-back and overlapping pieces, the
    two dangling RADIO_RX ends), each removed alone and kept out only when DRC counted
    by type got no worse; 18 such candidates DRC needed stay
    - R_ISETH's east silk tick restored (the footprint matches its library again); the
    overlap with the gate FET's outline cleared by moving R_ISETH 0.1 mm west, with its
    two tracks and the CHG_TS run beside it (vertical 0.1 mm west, both diagonals still
    45 degrees)
    DRC, every severity: 0 findings, 0 unconnected. routeDefects.py: 3 vias in pads left.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
2026-10-25 Board: RADIO_TX's via off the radio module's pin 17, onto its own back-side diagonal
    The via's ring overlapped the E73's pin 17 by 0.13 mm (solder wicks down it). Now at
    (12.04, 68.015) on the back-side run, 0.15 mm from the pad; the front stub leaves the
    pad straight and turns 45 degrees. DRC, every severity: 0, 0 unconnected.
2026-10-25 Board: owner's last routing fixes, routing done (as saved)
2026-10-25 Board: 7 stubs from the last hand pass removed; powerPaths.py rates the power paths
    - 7 tracks under other tracks of their net removed, each under DRC counted by type;
    DRC at every severity: 0, 0 unconnected, schematic parity clean.
    - routeDefects.py: a via is "in a pad" when its drill reaches the pad's solder-mask
    opening (where solder wicks down the barrel), not when its tented ring grazes the copper.
    - powerPaths.py (new): each power path's narrowest route and all-routes capacity
    (IPC-2221, 10 C rise, 1 oz outer, 18 um via plating rated as inner copper) against the
    current it must carry, and the GND vias that sink each power return.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
2026-10-25 Board: owner moved the VBUS via out of USB-C's VBUS pad (as saved)
2026-10-25 Board: a second via for the cell's + to the boost inductor; VBUS overlaps from the via move removed
    The cell's + reached the LTC3539's inductor through one 0.3 mm via (0.71 A on the
    conservative IPC rating, 1.2 A needed at full use on a flat cell). Its twin sits
    0.78 mm west, on the clip's straight back track and a straight front stub into the
    inductor pad: 1.41 A together. Four VBUS pieces left under the moved via and a 0.04 mm
    BAT crumb inside the inductor pad are gone. DRC clean at every severity.
    powerPaths.py: GND returns count the vias within 5 mm (the return spreads through the
    pour), and the margin summary credits parallel routes once they pass.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
2026-10-25 Board: zones refilled around the new BAT via; back flame regenerated for the routed board
    The previous commit saved the board with the old fills, so the GND and V3V3 fills still
    covered the new via (DRC with --refill-zones hid it; a Gerber export would have shorted
    it). Refilled and saved: DRC clean with and without refill. The flame moved at ten small
    spots where back labels and parts moved during routing. CLAUDE.md: the trap.
2026-10-25 Order set recut from the routed proto 1 board (cell on the back); C_U9A's decap tie kept
    All pre-fab checks pass: DRC as saved and after refill, nets, pins, MCU AF, netlist,
    lands, stale copper, GND ties, BOM/CPL, stock, drills, zones, PCBWay set. Notes as
    before: DNP the OPTIGA (out of stock), check the listed parts in JLC's preview, both
    sides. The decoupling cap of the radio's UART translator keeps its 0.86 mm tie to a
    via (the shortest return a decap can have; the chip's own ground pin is tied too).
2026-10-25 v3 case and page: the AAA cell on the back under a hump, published at /v3/
    enclosure/generate.py now builds the case for the routed board: the clips are on
    the back, so the shell gets a hump across the chin over them (51.2 x 15.4 mm, 6.4 mm
    proud, 0.6 mm skin 0.2 mm over the cell): 11.5 mm body, 17.9 mm at the hump. The
    bezel's chin is solid with a pocket over every front part (the radio module, the
    power parts) and the joystick's pocket and hole; no cell opening. The cell is changed
    by taking the shell off (it stays on the board). The shell now rests on its hump when
    printed, so its back needs supports.
    docs/v3/ (page, brand, enclosure) is the v3 page; docs/v2 (proto 1, front cell) stays
    f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
2026-10-25 v3 case: open over the cell, with an optional round cover that slides on from the side
    The hump built into the shell made the shell unprintable without supports (owner:
    "hell no"). The shell is flat again, with an opening the cell and its clips stand
    through (17.1 mm there). The cover is printed on its own, standing on its end with no
    supports, and slides in from the east. Its lips run under the floor's edges, it
    stops at the west wall, and it is 18.1 mm thick at the cell. Its inside follows the
    clips' real profile from MYOUNG's model: the arms flare out near the cell's top, so the
    inside corners are 2.95 mm, the outside 4.65 mm. The lips pass 0.18 mm from USB-C;
    the generator refuses any pa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
2026-10-25 Cell cover hugs the cell and the clips' real shape; the clips get MYOUNG's 3D model
    The AAA clips had no 3D model, so the page drew boxes and the cover was sized from a
    hand table. MYOUNG's models (EasyEDA, LCSC C6937104/C6937107; they match drawing
    WD-CP-0277: arms 10.46 tall, 11 across, tips flaring) now sit on the footprints
    (models.json, the library and the board, base on the pad within 0.1 mm, end walls
    outward). DRC clean with and without refill, the library check included.
    The cover's inside is now the hull of the clips (+0.15 mm) and the cell (+0.1 mm),
    and its outside one smooth curve: flat over the clips' tips, a 0.5 mm roof, shoulders
    that leave the back tangentially, 40 deg at t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
2026-10-25 Cell cover back to compact, closer to the cell: 14.7 mm wide, 17.7 mm thick there
    Owner: the wide tapered cover was the wrong direction. The outside now follows the
    inside (the hull of the clips' model +0.15 mm and the cell +0.1 mm) at 0.5 mm, with a
    0.8 mm skirt over the lips: 14.7 mm wide on the back, 6.2 mm proud, 0.5 mm roof.
    The earlier compact cover was 15.0 mm wide, 6.6 mm proud, 18.1 mm thick at the cell.
    No clip point inside it (nearest 0.15 mm), no overlap with shell or bezel.
2026-10-26 Print layout (case.3mf) holds the cover too, standing on its end
2026-10-26 Bezel: one pocket over the whole chin instead of one per front part
    3.3 mm deep (0.3 over the tallest part), 2.0 mm of bezel over it, a solid
    boss round the screw.
2026-10-26 Case fits for FDM, cover gets a closed end to print on
    First print: the halves would not go together, the cover failed mid-print.
    The bezel's fill sat line-on-line inside the shell's tongue, the tongue had
    0.1 mm in the skirt and the north hook 0.05 mm: now 0.2 / 0.2 / 0.15 mm.
    The cover stood on its open end (a 0.5 mm arch on the bed); it now has a
    1 mm end wall at the east, flush with the case, and prints on that. 0.2 mm
    for the cover to slide.
2026-10-28 v4 concept: the cells move to a magnetic battery pack, the device gets thinner
    Two AAA cells in series ride in a pack that snaps onto the back: two pairs of
    6 x 2 mm N52 magnets (opposite poles east and west, so it goes on one way) and four
    SMT pogo pins on the board's back (BWCD-L4.0W2.0H1.0, LCSC C2826548) onto gold pads
    on the pack's own board, which nests in a 1.1 mm recess in the back. Contacts: BAT+,
    the cells' mid-point, the pack's thermistor, BAT-.
    enclosure/generate.py now builds v4 from today's board: the board's clips are left
    off the device (their models shape the pack's), USB-C no longer sets the back's
    depth (a pocket leaves 0.7 mm of floor under it), and the pins and the devi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
2026-10-28 v4 pack: high on the back below the camera, open underneath, a readymade magnetic connector
    The pack moves to just south of the camera (its north edge outside a 70 deg cone from the
    lens) and loses its door: the cells sit open in their clips, the pack board is 0.8 mm.
    The contacts are Xinyangze's 4-pin SMT magnetic male (C5126843) on the pack board, its
    pins standing out of the pack into a window in the device's back onto four gold pads on
    the device board; the generator searches the board for the place (4.5, 32.7, beside the
    SE050; its VCC decap C_SEVCC has to move off the pads). Device magnets 8 x 1.5 mm so
    their bosses clear the MCU. 21.88 mm with the pack on. The page follows in the next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
2026-10-28 v4 page and case: the pack under the camera, a printed joystick cap
    Page: the device's gold pads and 8 mm magnets drawn from the generator's numbers, the
    door gone, copy for the pack's new place and connector. Joystick cap (enclosure/joycap.py):
    a square socket with crush ribs on the ALPS SKRHAAE010's 1.95 mm post (its drawing and
    STEP put the stem top at 5.0 mm, not EasyEDA's 5.08), an 8 mm dished pad 1.8 mm proud in a
    45 deg countersunk well that stops the tilt at 6.3 deg (switching at 3.8); prints on its
    sleeve without supports; Volt in the preview. The cap is baked into its geometry (a
    build123d location exports as an un-rotated glTF translation and landed off the device).
    Co-Authored-B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
2026-10-28 docs/pack.md: the pack under the camera, the magnetic connector and why
2026-10-28 v4 preview: the pack board's fuse, thermistor and resistor where its layout puts them
2026-10-28 v4 page: the battery pack is off by default; hero rerendered
2026-10-28 v4: a magnetic pogo pair holds the pack, no loose magnets; joystick cap #5446e5
    Owner, 2026-10-28: no flying magnets. Xinyangze's SMT magnetic receptacle (C6276862) on
    the device board's back east of the MCU at (43.6, 35.4), mated by its magnetic male
    (C5126845) on the pack board; their own magnets hold the pack. The male's body drops
    through a window in the back; the pack board sits 0.7 mm off the back face inside the
    tray's rim (the recess and the four discs are gone). 22.98 mm with the pack on. The
    device board has to move its power-key network (D_OR, Q_BTN and five passives) off the
    receptacle's land. The cap in the preview is #5446e5.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
2026-10-28 docs: the magnetic pogo pair, no loose magnets
2026-10-28 CLAUDE.md: v4's contacts are the magnetic pogo pair
2026-10-28 Rebrand to Ambire Ice; the repo is now AmbireTech/ice
    The product name in the README, docs, the v4 page, the board's title block,
    the generators' headers and the order files. The v4 case download is now
    ambire-ice-case.zip (same parts, README retitled). Pages links point at
    ambiretech.github.io/ice. The frozen proto 0, v2 and v3 pages keep their name.
2026-10-28 v4 pack board: two AAA cells in series behind a magnetic pogo male, routed, JLC order set
    pack/: the battery pack's own board (48.0 x 28.1 x 0.8 mm, 2 layers, ENIG), in the
    device board's coordinates as the case generator fixes them. Outer face: Xinyangze's
    4-pin SMT magnetic pogo male (C5126843; EasyEDA's land, checked against the maker's
    drawing; our own 3D model, EasyEDA ships the receptacle's), BAT+ / MID / NTC / BAT-,
    a BAT- pour. Inner face: the device board's MYOUNG clips (the north cell turned end
    for end, in series through the west clips), a 0.75 A resettable fuse in BAT+, the
    charger's 10 k thermistor, 1 k in the mid-point line, rings for the glued magnets.
    makePack.py builds and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
2026-10-28 Pack board: the through-hole magnetic male (C5126845), no loose magnets, 0.6 mm south
    The pack's connector is now Xinyangze's magnetic male YZP0048-20048-04025-03, mating
    with the device's receptacle. Its land is ours from the maker's drawing (0.80 mm holes,
    1.60 mm pads; EasyEDA's has a 0.05 mm ring), with our model. The outline and the cells
    come from docs/v4/enclosure/enclosure.json now (0.57 mm south); the magnet rings are gone.
    The pin column sits at x 36.5, not the case's 43.6: there it lands on the east clips'
    steel bases (BAT- on the south clip's CELL+ pad) and its joints would sit under the
    clips' arms; makePack.py refuses any position on a base. The fuse, resistor and
    thermistor s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
2026-10-28 Pack board: Ambire Ice on its silkscreen and title block
2026-10-28 v4 pack: the cells 21.1 mm apart so the magnetic male's joints pass between the east clips
    The pack board found the through-hole male at x 43.6 on the east clips' bases and under
    their arms; the device board can only clear the receptacle's land east of the MCU. The
    generator now derives the cells' pitch from the male's pin column and the clips' width,
    and centres the pair between the cells: the pack grows 6.6 mm north-south (37.5 mm), no
    thicker (22.98 mm with the device). The pair is at (43.6, 37.63).
2026-10-28 Pack board: the male back over the receptacle (43.6, 37.6), its joints between the spread cells' clips
    The case spreads the cells 21.1 mm apart (y 27.077 and 48.177) so the magnetic male's
    through-hole joints pass between the east clips' arms: 0.50 mm from each arm, checked by
    makePack.py (it now reads the connector's place from enclosure.json and refuses a joint
    within 0.4 mm of an arm or 0.2 mm of a base). The fuse (34.5, 33.877), the 1 k resistor
    (36.0, 36.377) and the thermistor (36.0, 38.877) sit on their pins' lines, west of the
    clips' arms; CELL+ runs round them to the south-east clip. DRC: nothing at any severity,
    as saved and refilled; cleanCopper --check clean; order set regenerate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
2026-10-28 v4 preview: the pack board's fuse, resistor and thermistor where pack/ has them
2026-10-28 v4 case: a printed slider works the airgap switch from outside
    The MSK12C02's lever stops ~1 mm inside the west wall (a pen tip until now).
    enclosure/airslider.py adds a slider in a window through the wall: a flange in
    a pocket on the inside keeps it in, the board's edge stops it pushed in, its
    fork takes the lever as the board goes into the shell, and its ribbed grip
    stands 0.6 mm out between two guard ridges (45 deg undersides, below the
    parting line). The window allows the lever's 1.5 mm travel plus 0.15 mm, so the
    switch's own stops end it. Checked against the exported shell: no overlap at
    either end of travel, captive outward, stopped by the board inward.
    Shown on the /v4/ page in the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
2026-10-28 v4 pack: the cells 16.7 mm apart, not 21.1: the joints clear the clips' steel bases, not their arms' span
    The cell pitch kept the magnetic male's four joints 0.5 mm outside the clips' arms, as if
    the arms lay on the board. Only the steel base (7 mm across the cell) does: the clips'
    models show the arms leaving it at its edge and curving up (0.66 mm up 0.3 mm out, 1.36
    mm 0.9 mm out). The case now derives the pitch from the bases plus 0.3 mm: 16.7 mm, the
    cans 6.2 mm apart (were 10.6). The pack is 51.2 x 33.1 mm (was 37.5), its board 48.0 x
    30.3; the receptacle on the device moves 2.2 mm north to (43.6, 35.43), the same parts
    to move off its land as before.
    Pack board rebuilt by makePack.py: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
2026-10-28 v4 pack: the cells 14.6 mm apart: the joints clear the clips' real feet, beside their tabs
    The last pitch (16.7 mm) still kept the magnetic male's joints off a 10 x 7 mm block per
    clip. The clips' models show each foot is a cross: a body 5 mm across the cell along the
    clip (its 9 x 5 pad), and a tab 7 mm across but only 4 mm along it (x 38.5-42.5 on both
    east clips), from which the arms rise; nothing else of the clip comes near the board.
    The pins stand at x 43.6, just east of the tabs, so only the bodies limit them.
    enclosure/generate.py now reads that steel from the clips' placed models (pack_steel,
    within 0.5 mm of the pack board; exported as pack.clipSteel) and spaces the cells so the
    p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
2026-10-28 Pack board: the thermistor's BAT- fanout to its pour via 0.4 mm, not 0.25
    A power pad's fanout to a plane via is thick (capped at the pad's narrow side), never a
    thin neck. DRC: nothing, as saved and refilled; cleanCopper --check clean; order set
    regenerated.
2026-10-28 Pages: the airgap chart says the MCU can only turn the radio off
    "can switch off, never on" read as the MCU switching itself. The dashed
    line now ends in the radio-power box, and the caption says why: the MCU's
    line meets the airgap switch in a NOR gate, so it can cut the radio's power
    but never bring it back while the switch is set to offline.
2026-10-28 Pages: drop the MCU from the airgap chart
    That the firmware can turn the radio off is a design detail, not part of
    the claim the chart makes (the switch cuts USB data and radio power in
    hardware); showing it only raised a question the chart then had to answer.
2026-10-28 v4 device board: the pack's magnetic receptacle south of the MCU, routed, DRC clean; pack and case to match
    Schematic (src/blocks/Power.tsx): the cell clips out, Xinyangze's 4-pin magnetic
    receptacle YZ103915020T-04025-02 (C6276862) in (BAT, CELL_MID, CHG_TS, BAT_N); the
    board's thermistor out (the pack carries it); a 1M/1M divider and 100 nF read the
    pack's mid-point on PA6; the BQ25172 set for two cells (VSET 36k) and fed from VBUS
    (a full two-cell pack leaves too little headroom under 3.3 V); its hold-off pull-up
    stays on the USB 3.3 V rail (5 V would exceed PB0's rating with the MCU unpowered).
    AIRGAP_SENSE PE7 -> PB15 and CHG_STAT PE8 -> PA3: the receptacle sends the display
    lines' fan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
2026-10-28 Board: owner's routing pass over the v4 autorouted copper (as saved)
    The owner's hand fixes to the copper the v4 commit laid (2fca538), by net and area
    (device board coordinates, mm); no part moved:
    - AIRGAP: the horseshoe round the USB switch U6 (east along y 75.2, down x 22.6 into
    pin 6) replaced by one 45 deg run straight into pin 6 (x 18-22, y 75-79); the rest of
    its run re-laid (x 10-23, y 54-79).
    - The MCU's south-side charger and sense lines re-run where they leave its pins and
    turn east (x 25-38, y 34-58): CHG_TS, CHG_STAT, RADIO_OFF, CELL_N_SENSE, and CHG_HI
    now on one layer (2 vias fewer); V3V3's decap fanouts there.
    - RADIO_3V3 at the radio module's north row (x 9-11, y 63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
2026-10-28 Board: owner's optimisation pass on the v4 routing (as saved, final-ish)
    The owner's hand pass over the v4 copper, by net and area (device board coordinates, mm):
    - TFT_RST and TFT_TE untangled where they cut back into the display connector
    (x 32-37, y 36-48): TFT_RST's double layer hop (three vias in 1.5 mm) down to one via.
    - RADIO_TXD_MCU (x 10-19, y 34-60): 3 vias -> 1. RADIO_RX / RADIO_TX at the radio
    module (x 6-17, y 62-70): the square pad exits and the run round the slot reworked.
    - CHG_TS, CHG_ISET and V3V3_USB at the charger (x 32-47, y 36-59): CHG_TS 2 vias -> 1,
    the CHG_ISET node's hairpin and mid-segment T gone; VBUS's entry into U1 tidied.
    - VBUS_SENSE through the chin (x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
2026-10-28 Order set, previews and the v4 page's board model regenerated from the final board (64a1467)
    production/make_order.sh on the board as saved: every pre-fab check passes (DRC nothing,
    as saved and refilled; nets; MCU pins; netlist parity; datasheet pin tables; flex
    connectors and tail slack; lands vs JLC; no stale copper; no GND ties beyond the kept
    ones; BOM/CPL parity; stock for 10 boards; drill census; zones span the outline;
    PCBWay set). At order time, as before: DNP the OPTIGA (U16), check the listed parts'
    rotations in JLC's preview (J_PACK now among them), assembly on both sides.
    enclosure/generate.py: the case is unchanged (R_VB2's move clears it).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
2026-10-28 v4 pack: the cells 12.8 mm apart (was 11.8): a cell going in must not short the neighbouring clip
    A cell goes into its MYOUNG clips through the arms' tips, 6.9 mm apart in the clip's
    model: each arm swings out ~1.7 mm at its tip and ~0.9 mm at its widest (hinging at its
    root). At 11.8 mm (courtyards touching) the neighbouring arms were 0.8 mm apart, and on
    the east side they are the pack's minus and the south cell's plus, ahead of the fuse:
    an arm swinging out while a cell went in could short the whole pack. generate.py now
    spaces the cells by the arms' span plus ARM_GAP = twice that swing (1.8 mm): 12.8 mm.
    Pack 51.2 x 29.2 mm (was 28.6), its board 48.0 x 26.4; the male's joints 0.47 mm un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
2026-10-29 Pages: the Ambire mark as favicon on all four landing pages
    The flame mark the pages already draw inline, white on the brand's purple-to-violet
    rounded square, as an inline SVG data URI in each page's head: the proto 0 page (/),
    v2, v3 and v4. The owner's one exception to v2 and v3 (and the proto 0 page) staying
    frozen; nothing else on them changed.
2026-10-30 Firmware: the SE050's random number generator mixed into the strong RNG
    The strong path (seed generation, secret keys) now XORs a block from the SE050 into
    the MCU's TRNG output, beside Trezor's OPTIGA/Tropic slots, and halts if the SE050
    fails or was not used. New driver in core/embed/sec/se050/ (T=1 over I2C, IoT applet
    SELECT, GetRandom), every protocol constant cited from NXP Plug & Trust; enabled for
    ambire_p0 by [se050]. Builds; untested on hardware.
2026-10-30 Board: BMI270 IMU (the GridCore Nano's part) on the touch I2C bus, placed and routed
    On the back north of the touch connector, turned 90 deg so its I2C lands face east,
    a 100 nF at each supply pin; address 0x68 (SDO to GND), CSB to 3.3 V for I2C, the
    unused aux/OIS pins open (BST-BMI270-DS000-08 Table 22). Interrupt on PC15, the
    east-side pin with a straight run (no LSE crystal, so a plain input). The spot east
    of the MCU fit the part but only one decap, in the interrupt's path.
    Routed with humanizedKicadAutoRouter (route gauge), kept net by net: SDA tap 2.6 mm,
    SCL tap 3.8 mm with one hop over SDA, interrupt 15.3 mm with two vias (it crosses the
    touch lines), one plane via per 3.3 V pin. A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
2026-10-30 Back previews regenerated with the IMU (make_order.sh)
2026-10-30 Firmware: the SE050's I2C bus, pins and interrupts belong to the secure monitor
    Trezor's TrustZone setup makes I2C4 secure only when the OPTIGA is enabled.
    Our board enables the SE050 alone, so the bus, its pins and the SE050's enable
    line stayed non-secure, and both I2C4 interrupts were routed to the main
    firmware: the secure monitor's transfers could not complete, and the main
    firmware could have read the SE050's random bytes or held the chip off.
2026-10-30 Firmware: SE050 driver rejects a frame longer than its buffer
    A received T=1 frame whose length byte says 255 was read into a buffer sized
    for 254 bytes of payload, one byte past its end.
2026-10-30 Firmware README: what the SE050's randomness does and does not cover yet
    Seeds use it; the boot hardware key and the master key do not (the master
    key needs prodtest provisioning, which the port does not build yet), and
    without the OPTIGA nothing in hardware limits PIN guesses.
2026-10-30 v4 page offers the board files; all preview pages hand over to ambire.com/ice at 14:30
    The v4 page still said the board was not laid out. Its DIY pane now offers
    the device board's order files (JLCPCB or PCBWay, from production/order) and
    the pack board's (JLCPCB, from production/pack-order), as v3 did;
    generate.py writes them. The case zip is unchanged.
    The root page, /v2/, /v3/ and /v4/ redirect to https://ambire.com/ice from
    2026-10-30 14:30 EET on (a client-side time check).
2026-10-30 Order sets recut from the current boards; the v4 page's files carry v4 names
    make_order.sh (all checks pass) and pack/makeOrder.py rerun: the Gerbers
    differ from the last cut only in their date headers, the stock reads are
    today's. The page's downloads save as ambire-ice-v4_* (device board) and
    ambire-ice-v4-pack_* (pack board).
2026-10-30 Case download: the case and the battery tray as separate 3MF and STL print layouts
    case.3mf and case.stl hold the shell, bezel, joystick cap and airgap slider laid out
    for printing. battery-tray.3mf and battery-tray.stl hold the pack's tray on its own.
    The STL is for slicers other than Bambu's. The v4 page offers each layout as a zip with
    its own README; the STEP files and the per-part STLs stay in enclosure/out/.
2026-10-30 Firmware: swd.py for proto 0 bring-up (info, TrustZone, flash, crash state over SWD)
    OpenOCD + arm-none-eabi-gdb: reads the chip, option bytes, flash contents,
    latch/USB/airgap pins; sets TZEN and SECBOOTADD0; writes and verifies the
    combined image; halts and symbolises the PC per stage, decodes fault
    registers and the RSOD record in bootargs. README: proto 0 flashing needs
    the button held (blank chip has no latch), wires on the front pads before
    the pouch, and the airgap switch off AIR for USB data.
2026-10-30 swd.py: a Raspberry Pi's GPIO as the SWD probe (--probe rpi --host)
    OpenOCD's linuxgpiod driver on the Pi (header GPIO25 SWCLK, GPIO24 SWDIO,
    GPIO18 NRST; the gpiochip found by label, so a Pi 5's RP1 works too), run
    over SSH; the image is copied over for flashing and gdb connects to the
    Pi's port 3333. setup installs openocd and gpiod there.
2026-10-30 swd.py: BeagleBone as the SWD probe; GPIO pins found by line name
    --probe beagle: P9_12 SWCLK, P9_15 SWDIO, P9_23 NRST (GPIO1, GPIO mode at
    boot, clear of HDMI/eMMC). Pins of both Linux probes are resolved from
    gpioinfo line names instead of chip labels. setup sets the Beagle's pinmux
    and refuses an OpenOCD older than 0.12 (no STM32U5 target).
2026-10-30 swd.py/README: BeagleY-AI wires as a Pi (same header layout)
2026-10-30 Proto 0 bring-up: display runs; swd.py flashes over a BeagleY-AI
    Found on the first board, each from the chip's registers:
    - Display SPI: CR1.SSI is now set before CFG2 (master + software NSS).
    The old order was a mode fault: MASTER read back 0, SR.MODF set, SPE
    never set, and the first panel command waited forever.
    - TEON (0x35) in the DEM240320B1 sequence when the board wires TE: the
    ST7789 resets with TE off, and the boardloader's refresh waits for it
    (Trezor's devkit wires no TE pin).
    - DISPLAY_PANEL_MIRROR_X: the Newhaven panel's columns run opposite to
    the DEM240320B1's (text was mirrored left to right).
    swd.py:
    - Linux-board probes fall back to sysfsgpio (Debian 13's OpenOC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
2026-10-30 Proto 0 boots to the app: secure monitor MPU covers AUX2; SE050 GetRandom parses long TLV lengths
    Both found on the board with a live trace (swd.py over the BeagleY-AI):
    - MemManage in the secure monitor's rng_fill_buffer, called by the kernel
    for the app with a buffer at 0x2006479C (the app's stack, AUX2 RAM).
    The secure monitor's MPU maps MAIN and AUX1 RAM but not AUX2 (upstream
    T3T2 layout); AUX2 directly follows AUX1, so with AUX2_RAM_START the
    monitor's region 4 now spans both (static assert on the contiguity).
    The caller's write access is still probed first.
    - SE050 entropy: resync, ATR, applet select and GetRandom all answered;
    the GetRandom response is 38 bytes: 41 82 00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
2026-10-30 Firmware: Ambire branding on ambire_p0 (flame logo, name), welcome screen held 3 s
    - [ambire_branding] in ambire_p0.toml turns on the Rust feature of the same
    name for the firmware and the bootloader: the welcome screen's logo
    (theme::ICON_LOGO) is the Ambire flame instead of Trezor's.
    - The flame comes from AmbireTech/ambire-brand (Ambire_symbol_white.svg,
    kept in firmware/branding/); firmware/branding/make_toif.py draws it
    as a 70x102 TOIG icon, the size of the logo it replaces.
    - MODEL_FULL_NAME / MODEL_USB_MANUFACTURER "Ambire" from the board header:
    model_T3T2.h includes the board header first and keeps Trezor's names
    only where a board sets none (welcome screen text, defaul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
2026-10-30 Firmware: T3T2 pairs over THP, has coin data; bigger welcome flame; full errors on Ambire boards
    Found on proto 0 over USB (the bootloader takes firmware by trezorctl, no SWD):
    - THP pairing failed with NotImplementedError: Delizia, T3T2's layout, has
    no confirm_thp_pairing screen and no THP texts (empty strings). Where the
    layout raises NotImplementedError, wire/thp/ui.py confirms with the generic
    confirm_action, worded as Eckhart's; the code screen falls back to the same
    wording. Paired with trezorctl (code entry), wallet created (ResetDevice).
    - Every coin lookup failed (BTC "Unsupported coin type", Ethereum
    "NoneType isn't iterable"): the generated coin tables have no T3T2 bran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
2026-10-30 Proto 0: first signed transaction (offline EIP-1559, verified)
    Fresh wallet on the device, m/44'/60'/0'/0/0 = 0xE52b...6268; 0.001 ETH to
    itself, chain 1, nonce 0, never broadcast. The signer recovered from the
    raw transaction is the device's address.
2026-10-30 Board: owner's BAT/V_BOOST/JOY_DIR rework east of the cell (as saved)
2026-10-30 Board: one display cutout, no FR4 between the tails; bottom-contact touch connector
    The touch flex is 14.55 mm wide (not 7) for its first 23.6 mm: the root and the
    stiffened block carrying the touch controller, which must pass the slot when the
    tail is threaded. On proto 0 the bridge between the slots stopped it. The touch
    slot now spans x 28.50-43.95 and joins the TFT slot (2.5 mm south since v4) in
    one stepped cutout (newBoard.CTP_FLEX, slot_boxes(), slot_outline()).
    The touch tail's contacts face the board after the two bends (Newhaven's side view
    marks both tails the same way; proto 0's top-contact CSH25 made no contact): J_CTP
    is the bottom-contact HC-FPC-1.0-6P-CXH25 (C49166842), same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
2026-10-30 Order set rebuilt for the one-cutout board and the bottom-contact touch connector; all pre-fab checks pass
2026-10-31 Hand-routing pass: shorter, cleaner runs and 7 fewer vias
    Tidied up the routing by hand after the display-cutout rework. No parts
    moved; this is all copper.
    - The radio's power-off line now takes a much more direct path: about
    26 mm instead of 60, and two vias fewer.
    - The cell-sense line and the button line no longer hop between layers;
    each lost both of its vias.
    - The USB 3.3 V supply drops one via.
    - Small straightening on the battery feed, the power-enable and the
    charge-status lines, and a few ground touch-ups.
    Overall the board has about 32 mm less track and 528 vias instead of 535.
    No stale copper, nothing unconnected.
2026-10-31 README: commercial info from ambire.com/ice and a note that the device is built to be opened
2026-10-31 Firmware: [ambire_radio] radio bring-up (power gate + UART hello)
    Trezor's T3T2 Bluetooth is an nRF54L running Trezor's radio firmware, linked
    to the STM32 by SPI with handshake lines; proto 0 has an nRF52840 module on a
    2-wire UART behind the airgap switch, so Trezor's stack cannot run as is. This
    brings up our side: the kernel drives RADIO_OFF low (the airgap switch's NOR
    gate still decides: the RADIO light should follow the switch) and starts
    USART3 at 115200 with a hello line, the first thing a UART bridge on the
    radio will hear. Also the prerequisite for flashing the radio over its SWD
    pads: its supply was never on before.
2026-10-31 Lock screen: the Ambire flame instead of the padlock; entropy sanity test
    - [ambire_branding] swaps Delizia's HOMESCREEN_ICON (the padlock at the
    centre of the default home/lock screen background) for the flame at the
    same 32x46 size (make_toif.py from the brand SVG).
    - bringup/entropy_test.py: collects GetEntropy samples from the device (the
    strong path: MCU RNG XOR SE050) and runs quick tests that catch a broken
    or stuck generator (bit balance, runs, byte chi-square, serial
    correlation, compressibility, repeated blocks). Checked on host urandom
    (passes) and on a deliberately biased sample (fails).
2026-10-31 swd.py: radio-info / radio-recover / radio-flash for the nRF52840 on its own SWD pads
    OpenOCD's target/nrf52.cfg with the same probe (wires on TP_RSWDIO/TP_RSWCLK/
    TP_RGND): FICR part/variant and the CTRL-AP APPROTECT status, nrf52_recover
    (erase-all + unlock), program/verify/reset of a .hex. The radio needs power:
    airgap switch off AIR and firmware allowing it. Untested on hardware.
2026-10-31 Firmware: Bluetooth on ambire_p0 over a 2-wire UART link (STM32 side)
    Trezor's T3T2 BLE (an nRF54L, SPI with the STM32 as slave, handshake lines)
    does not fit proto 0: an nRF52840 module on USART3 behind the airgap switch.
    - io/nrf/stm32u5/nrf_uart_link.c (new, feature io/nrf_uart_link): the link
    contract shared with the radio app: Trezor's SPI packet unpadded,
    [0xA0|service][len<=251][payload][crc8 0x07], 1 Mbaud 8N1, no flow control,
    drop-one-byte resync. RX: GPDMA1 ch5 circular into a 2 KB ring, parsed on
    USART idle / DMA half+full / a 50 ms timer; TX: queued frames on ch6.
    Radio presence = a valid frame in the last 500 ms; probes every 200 ms;
    every wait bounded (airgap: radi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
2026-10-31 Radio: Trezor's nRF app (trezor-ble) built for proto 0's nRF52840 (E73) over the UART link
    - nordic/trezor/boards/arm/ambire_p0 (new board) + trezor-ble board conf/overlay:
    UART0 TX P1.09 (module pad 17), RX P0.05 (pad 15), checked against the
    as-ordered PCB, the TXU0202 pin table and Ebyte's pin table; LF RC clock;
    no SPI, no handshake GPIOs (signals_none.c), no MCUboot (plain image at 0x0).
    - trz_comm/uart_link.c (new, CONFIG_TREZOR_UART_LINK): the same frame contract
    as the STM32 side; RX by DMA with TIMER2/PPI byte counting into a 1 KB ring,
    resync, 20 ms stale-frame timeout; queued TX. Host test in
    firmware/radio/linktest (CRC known answer, junk/bit-flip/fuzz) passes.
    - Upst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
2026-10-31 entropy_test.py: report the device's error, not the urllib3 warning
2026-10-31 entropy_test.py: save every sample as it arrives, resume on rerun, 4 calls by default
    An interrupted 16-call run lost every sample (the file was written only at
    the end), and with them the owner's on-device confirmations. Each sample is
    now appended and fsynced before the next confirmation is asked for; a rerun
    continues until the file holds --calls samples. Checked with a stand-in
    trezorctl: interrupted at call 3 kept 2 samples, the rerun finished 3-4.
2026-10-31 Proto 0: strong RNG sample (5 x GetEntropy, 5 KB) and its analysis
    Taken after the 3-round entropy check passed in ResetDevice.
2026-10-31 swd.py --probe beagley: SWDIO on header pin 15 (GPIO22), not pin 18
    BeagleY-AI header pin 18 (GPIO24) is the AM67A's wake-up-domain pad
    WKUP_UART0_TXD / MCU_GPIO0_10, the domain of TI's device-manager firmware;
    a suspect for the garbled SWD replies. Pin 15 (GPIO22) is main-domain
    GPIO0_41 with no UART function, beside SWCLK's GPIO0_42 on pin 22 (pinout:
    pinout.beagleboard.io). swdprobe's run.sh takes the SWDIO line name, so the
    old and new wiring can be compared. Untested on hardware.
2026-10-31 SWD on the BeagleY-AI fixed: SWDIO off the wake-up UART pad
    With SWDIO moved from header pin 18 (GPIO24 = WKUP_UART0_TXD / MCU_GPIO0_10)
    to pin 15 (GPIO22 = main-domain GPIO0_41), swdprobe read the STM32's IDCODE
    80/80 correct at 0-200 us half-periods (all garbled before on pin 18), and
    swd.py info --probe beagley reads the whole chip. swd.py info no longer quits
    when a register other than the ID/option ones reads back an error.
2026-10-31 swd.py flash --live: halt the running firmware instead of resetting (power latch stays held)
    No reads while the firmware runs either: an info during normal use tripped
    its TrustZone illegal-access fault (internal error IA). README: that, the
    reset dropping the latch on battery, the loose-wire check with swdprobe, and
    why the branded bootloader has to go on over SWD.
2026-10-31 firmware README: SWD corruption while the firmware runs is open, not a loose wire; no battery claims (the board runs on USB)
2026-10-31 docs: on USB with the pack off the centre press is dead and the device stays on (intended)
2026-10-31 Camera: GC2145 module (Camemake CM_DVP_GC2145_UNIVERSAL); core LDO TLV70313 -> TLV70312 (1.2 V)
    Camemake's open reference host feeds the module 2.8/1.2/3.3 V on the same
    connector pins as ours; an OV2640 module still fits the same connector and rails.
2026-10-31 Board: one display cutout sized by the TFT flex's 39 mm root; TFT connector 1.9 mm east, touch connector 5.5 mm south
    Newhaven's drawing, read from its vectors: the TFT tail is centred on the panel
    (11.15 from both outline edges; the 9.25 dimension is from the flex root's edge,
    not the outline), so J_TFT sat 1.9 mm west of its tail. The flex leaves the panel
    as a 39.00 mm EMI-shielded root (2.2-13.2 mm below the panel) and folds through
    the board within it, so the cutout is now x 4.05-43.95, y 63.41-68.01 (the owner's
    reworked print, made straight and 4.6 mm tall), stepped 0.41 mm north over the
    radio's top pad row. The touch flex folds outside the TFT flex (it leaves the panel
    above it, acr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
2026-10-31 ESD on the pack contacts; boost output caps 47 uF
    Pre-order audit items. The pack's NTC, mid-point and minus contacts are bare on the
    back whenever the pack is off: a PESD5V0S1BL each (bidirectional, 5 V, 5 nA, JLC
    C84374), bidirectional because a backwards cell puts the mid-point below GND; the plus
    contact sits on 30+ uF. NTC and mid diodes sit on their traces by the MCU's ADC pins,
    the minus diode by the reverse-cell FET. The LTC3539 wants >= 22 uF of real output
    capacitance; the two 22 uF 25 V 0805s kept ~11 uF each at 3.3 V, now two 47 uF 6.3 V
    0805s (CL21A476MQYNNNE, C16780) on the same lands. U14 synced to TLV70312.
    VSSOP counts as a low part under the display flexes (0.9-1.0 mm, like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
2026-10-31 Order set recut from the new cutout board; pre-fab checks pass but for J_CTP stock
    The six GND ties the cutout's re-placement needed (pour islands it fragmented) join
    stripGndTies' KEEP; R_VSET.2 keeps its own tie and gets one spoke from the pour, which
    a one-pad DRC rule allows. JLC stock: the bottom-contact touch connector
    HC-FPC-1.0-6P-CXH25 (C49166842) is down to 10.
2026-10-31 Case and v4 page files regenerated from the new-cutout board
2026-10-31 Board: production pack contacts (Mill-Max target discs + Wurth steel spacers), touch connector to the FH20
    The pack's Xinyangze male now lands on commodity parts on the device board:
    four Mill-Max 1578-0-57 gold target discs under its pins (2.5 mm pitch) and
    two Wurth WA-SMSI 9774010243R steel spacers (M2, 1.0 mm) under its magnets;
    the male's face rests on the steel, pins compressed 0.93 mm. The female
    receptacle (C6276862) is gone.
    Touch connector: the CXH25 ran out; HC-FPC-1.0-6P-FH20 (C49166832, 2.0 mm,
    bottom contact, same contact row). Rerouted locally round the new parts,
    DRC clean (with and without refill), 0 unconnected, flame regenerated.
    Case: the back is 0.5 mm shallower (the T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
2026-10-31 Order set: Mill-Max discs through JLC Global Sourcing; spacer's GND tie dropped
    The stock gate lists a Global Sourcing part as a buy note (DigiKey cut tape,
    117,259, MOQ 1) instead of a shortfall. The west steel spacer's tie via goes:
    the pour reaches both spacers with one spoke (DRU rule), they carry no current.
    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
2026-10-31 Pack board rebuilt for the closer pack; boost caps' derating from Samsung's curve
    The pack now sits 1.5 mm closer to the device, so the camera's cone lets it
    1.05 mm further north: pack/makePack.py rebuilt the board from the case's
    numbers (DRC clean, pin order unchanged), pack order set recut. The boost caps
    keep ~20 uF each at 3.3 V by Samsung's DC-bias curve (-57 %), over the 22 uF the
    LTC3539 needs even at -20 % and 85 C.
2026-10-31 Docs and v4 page: the pack's production contacts (discs + steel spacers), FH20, current thickness
    pack.md, design.md, CLAUDE.md, pack/README: the receptacle pair replaced by
    the Mill-Max discs and Wurth steel spacers the next batch tests; why these
    parts; bring-up checks for the magnets' hold on the steel and the contacts.
    The touch connector is the FH20 (contact row unchanged). Thickness 10.22 mm,
    21.68 with the pack. The generator models the stack from the steel and the
    discs (no receptacle stand-in) and takes the discs' positions from the board;
    the v4 page draws discs and spacers. Pack renders redone.
2026-11-01 Pack order: the magnetic male is SHORT (20 at JLC/LCSC, nowhere else); stock check counts packs covered
2026-11-01 Board: owner's routing fixes (as saved 2026-11-01 08:32)
2026-11-01 Board: owner's routing fixes (second pass)
2026-11-01 Board: 25 covered stub segments removed; flame regenerated around the owner's new routing
    Stubs: every segment routeDefects lists as covered by other copper of its net, except the
    TPS60230's pad-7 GND entry (without it the pour's thermal to that pad reads starved).
    Silk: the flame overlapped R_REVG's pads and outline (2 silk_over_copper, 1 silk_overlap);
    silkFlame.py rerun cuts it back. DRC as saved and refilled: 16 lib warnings only, 0 unconnected.
2026-11-01 Pack contacts with real stock: 4 single SMD pins + 2 DigiKey magnets in a printed frame; device board unchanged
    The magnetic male (YZP0048-20048-04025-03) had 20 at JLC/LCSC and none at
    any Global Sourcing distributor. The pack side is now its parts:
    - 4x Xinyangze YZP0058-20048-02 SMD spring pins (C5157341, 1,216 at JLC: 304
    packs), the same 30 g pins the male carried, on JLC's own land with the
    peg hole plated (carries each pin to the inner face).
    - 2x Radial Magnets 8063 NdFeB N40 3.18 x 3.18 mm (DigiKey 469-8063-ND,
    3,794), glued on the board over the device's steel spacers.
    - A printed frame in the male's outline (its tab keys the pack in the
    back's window), pegged and glued to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
2026-11-01 Board: owner's routing optimisation (as saved 09:12; zones need a refill: stale GND fill under a new USB_MCU_DP track)
2026-11-01 Board: power-net taps narrowed to what they carry; zones refilled
    Runs that only feed taps keep no rail width (scripts/thinTaps.py):
    - BAT to the power key (Q_PWRJ emitter, R_PWRJBE 1M): 0.8 -> 0.2 mm, 18.9 mm;
    its two 0.8 mm runs that met only by overlapping copper (44.0-44.25, 79.8,
    B.Cu) now join end to end
    - V3V3_USB to R_CHGOFF (100k pull-up): 0.4 -> 0.2 mm, 35.7 mm
    - V_BOOST to D_REVG (gate diode): 0.4 -> 0.2 mm, 15.7 mm; to C_FFB 0.2 mm
    - VBUS to R_VB1 (47k sense) 0.2 mm; to the USBLC6 0.3 mm
    - BAT_N to the PESD5V0 clamp 0.3 mm
    DRC as saved and refilled: 16 library warnings only, 0 unconnected (the
    saved fill's GND-under-USB_MCU_DP clearance error is gone with the refill);
    cleanCo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
2026-11-01 Board: owner's routing fixes (as saved 09:36)
2026-11-01 Power-hold pull-down 100k -> 1M: 3.3 uA instead of 33 uA while the MCU holds the board on
    The MCU holds PWR_HOLD high whenever the board is on, asleep included, so this
    resistor is a constant drain on the asleep budget. Board sync follows separately.
2026-11-01 Board: owner's routing updates
2026-11-01 Board: power-hold pull-down 1M synced; order set recut with the owner's routing
    The owner's routing ties the radio gate's NOR ground pin to a GND via; it joins
    stripGndTies.py's kept list, so the pre-fab checks pass again.
2026-11-01 Board: owner's routing optimizations
2026-11-01 Board: flame regenerated around the moved button-base resistor; order set recut
    DRC back to 0 (the flame overlapped R_BTNB's outline and its BTN_B pad).
2026-11-01 Board: owner's routing simplification pass
2026-11-01 Board: 7 stubs removed, flame regenerated around the moved airgap pull-up; routeDefects lists hops forced only by plane-net copper; tidyDefects.py
2026-11-01 Li-ion is not supported (two cells exceed the boost's 6 V); camera LDO pin-map label; order set recut for preprod-0
2026-11-01 Board: owner's routing optimizations (VBUS 9 -> 6 vias, BAT 8 -> 7 and 9 mm shorter)
2026-11-01 Board: 3 stubs removed after the owner's pass
2026-11-01 Pack contacts without the gold discs: plain ENIG pads under taller pins (Xinyangze YZP0118-20063-02), 1.5 mm steel spacers; every part JLC stock
    The Mill-Max 1578 target discs were the one Global Sourcing part (two weeks on every
    device order). The pins now land on the same 2.235 mm lands as bare ENIG pads; the
    Wurth WA-SMSI spacers grow from 1.0 to 1.5 mm and the pack's pins from 4.3 to 5.5 mm
    free (4.5 working, 25 g), so the pins sit 0.83 of their 1.2 mm stroke, as before.
    The pack sits 0.5 mm further out. Device order set, pack board and order files, and
    the case regenerated; the owner's TPS2116 ground tie kept.
2026-11-01 Programming jig: RP2040 debugprobe (CMSIS-DAP over USB-C) with spring pins on both faces; order sets for the device, the pack and the jig
    jig/makeJig.py builds two boards in the device's own coordinates. The probe board
    (4 layers) carries an RP2040 wired as Raspberry Pi's debugprobe_on_pico build (SWCLK
    GP2, SWDIO GP3, reset GP1, LED GP25), so the stock UF2 runs and firmware/swd.py drives
    it with --probe cmsis-dap; five Xinyangze spring pins underneath land on TP_3V3, TP_GND,
    TP_SWDIO, TP_SWCLK and TP_NRST; a second ME6211 powers the device through TP_3V3,
    switched by its CE; a DPDT selector sends SWD to the MCU or, through a JST SH cable
    and 1k each, to the base. The base (2 layers) holds t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
2026-11-01 Board: the radio's SWD pads to the front (owner), beside the MCU's side of the jig; owner's routing changes
2026-11-01 Board: radio SWCLK pad 0.54 mm south, 2.6 mm from SWDIO, so two 2.0 mm spring-pin flanges fit beside each other
2026-11-01 Board: owner's routing changes (BAT 7 -> 4 vias, PWR_EN 20 mm shorter, BTN); the radio SWCLK pad back at 80.96 by that save
2026-11-01 Programming jig as one board, every part on one face: the device goes on face down
    All seven programming pads are on the device's front now, so one board reaches them
    all: its parts on KiCad's B side, drawn in the device's coordinates; the jig lies parts
    up, the device face down on three M2 screws through H1, H2, H4 and 5 mm standoffs,
    three nuts on its back. Under the device only parts below the 5 mm gap; a cut-out for
    the joystick; the USB-C, TARGET 3V3, the MCU/RADIO selector and the lights on a 13 mm
    strip west of it. JLC assembles one face. Routed by humanizedKicadAutoRouter, stubs and
    one dangling track removed; DRC clean as saved and refilled.
    makeJig.py first checks the device board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
2026-11-01 Board: owner's routing (PWR_EN and BTN rerouted, all connected)
2026-11-01 Board: flame regenerated around the moved parts (silkscreen clean), radio SWCLK pad to 81.50 on the front (2.6 mm from SWDIO), 3 stubs; order set recut, the jig fits
2026-11-01 Jig: 3D models for the spring pins and the selector (JLC's STEP), seated on the board
    The pin's generic model has a 2 mm peg (the part's is 0.8): its flange sits at
    z 2.0, so the offset is -2.0; the selector's body starts at z 6.35. Copper unchanged.
2026-11-01 Jig: a printed base with four poles and a lid replace the screws, standoffs and nuts
    jig/makeFixture.py (build123d) builds both from jig/geometry.py, which the board's script
    shares. Each pole: an 8 mm foot the jig rests on, a 4 mm section through the jig's new
    4.2 mm hole up to the device's front 5 mm above it, a 2 mm tip through the device's hole
    into the lid; the fourth pole only holds the jig, south of the selector. The lid rests on
    the device's three hole rings on 4.5 mm bosses (the back's tallest part, the USB-C, is
    3.4 mm). A weight of ~300 g on the lid holds the device against the pins' 7 x 25 g.
    --check exports both boards from KiCad as STEP, places them as they sit (turned over,
    x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
2026-11-01 Board: owner's routing changes and pad positions
2026-11-01 Board: owner's VBUS touch-up
2026-11-01 Jig: the reset pin follows TP_NRST to 33.25, 26.30; rebuilt, routed, tidied; Gerbers recut
    DRC clean as saved and refilled; the fit check and the base/lid overlap check pass.
2026-11-01 Board: owner's edits
2026-11-01 Board: zones refilled, 8 stubs from the new routing; device and pack Gerbers regenerated
    Device order set: all 17 pre-fab checks pass; the jig's fit check passes.
2026-11-01 Order set recut: the owner's new GND tie at C_OPT.2 kept (the previous commit's pre-fab checks had failed on it, not passed as it said)
2026-11-01 Pre-fab checks: extra GND ties are a NOTE, never a FAIL (owner: a redundant tie is tidiness, not a fab risk)
2026-11-01 Programming pads and holes frozen: the jig is ordered (2026-11-01, c593d1c)
    jig/frozen.json records where the ordered jig's pins and poles land: TP_3V3, TP_SWDIO,
    TP_SWCLK, TP_GND, TP_NRST, TP_RSWDIO, TP_RSWCLK and H1, H2, H4. jig/makeJig.py --check
    holds both the jig's numbers (now in jig/geometry.py) and the device board to it; the
    pre-fab checks run it as a gate (tested: a 0.3 mm move fails it). The ten footprints are
    locked on the device board, so KiCad will not move them by accident.
2026-11-01 Board: owner's routing fixes
2026-11-01 Board: flame regenerated around the owner's moved copper (12 silkscreen warnings), 2 stubs; order set recut
2026-11-01 Board: owner's optimizations
2026-11-01 Board: flame regenerated (silkscreen), stubs
2026-11-01 Board: owner's edits (the mid-point ESD clamp beside its contact, R_MS1 turned), as saved after a KiCad crash
2026-11-01 Board: after the KiCad crash, flame regenerated around the moved clamp (13 silkscreen warnings), 3 stubs; order set recut
    A KiCad local-history restore at 22:03 had deleted wallet.pretty, experiments/,
    footprints.json, models.json and the netlist export, and put October's project, rules
    and library table back (the 'wallet library not enabled' warnings). The board file was
    the owner's new work; everything else was restored from git (identical to KiCad's own
    pre-restore backup) and the netlist from that backup.
2026-11-01 Kept GND ties: the pack's two ESD clamps share one via beside their contacts (owner)
2026-11-01 Pack plus line: a second via beside the single one (1.41 A in parallel); OPTIGA assembled from the owner's stock, not DNP; v4 page declares UTF-8 and draws the bare contact pads; order set recut
    The minus line's via has no DRC-clean spot within 1.4 mm without moving other tracks.
2026-11-02 Pack frame: the magnets are a hard press fit plus glue (owner): three crush ribs per pocket
    Each magnet's pocket keeps its 3.33 mm bore (the glue goes between the ribs) and gets
    three 0.6 mm ribs whose crests stand 0.1 mm inside the magnet's radius, up the pocket
    from the board, ending 0.4 mm short of the face in a ramp the magnet starts on. Checked on
    the exported frame: no material inside r 1.477, crests at 1.4875 in both pockets.
    Assembly notes: a drop of glue, then the magnet pressed hard down onto the board.
    Case files and the v4 page regenerated (the page also takes the current device Gerbers).
2026-11-02 Pack assembly: the frame and the magnets epoxied hard to the pack board (owner)
    Two 0.6 mm pegs and a dab of glue would shear off when the pack is knocked sideways in
    the back's window. The notes now say epoxy (not superglue, poor on PETG) over the frame's
    whole underside, the pegs only locating it while it cures, and epoxy under each magnet
    before it is pressed in. Case files and the v4 page regenerated.
2026-11-02 Pack frame: its key tab points east, off the MCU (it reached over the MCU north, which held the contacts and the display connector back)
2026-11-02 Board (WIP, hand routing): pogo pads 1.35 mm, display connector 2.7 mm, touch connector 3 mm north; via in pad OK on the pogo pads (no solder)
    The CELL_MID ESD clamp beside the CHG_TS one, the cell-sense filter cap and the
    display's two V3V3 decaps east of the display connector. Routing in progress:
    11 unconnected, zones not refilled, cleanCopper --check lists 3 stale items.
2026-11-02 Board: routing done after the connector moves (owner); 0 unconnected, copper DRC clean, cleanCopper clean
2026-11-02 Board: owner's further routing edits (as saved)
2026-11-02 Board: BTN link restored (R_BTNB-R_BTN, cut in the last edit), flame regenerated, zones refilled
    GND vias out of the steel spacers' pads (MH_PK1/2 are reflowed: a via would wick their
    solder; DRC shows them redundant), 7 stubs buried under same-net copper removed.
    DRC clean at every severity, 0 unconnected, cleanCopper clean.
2026-11-02 checkFpc: the touch tail's 1.5 mm at the nominal fold accepted on the owner's fit print (NOTE, up to the measured shortfall only)
2026-11-02 Order set recut: all pre-fab checks pass (the touch tail a NOTE, accepted on the fit print)
2026-11-02 Pack v4 rebuilt for the moved contacts: pins, magnets, frame pegs and the fuse/thermistor/resistor 1.35 mm north, the frame's tab east; case, page data and the pack's order set regenerated
    The old pack order set does not mate with the current device board (its pins would land
    1.35 mm off the 2.24 mm pads). The south cell's AAA label moves east of the pins' peg rings.
    Pack board DRC clean at every severity (as saved and refilled), 0 unconnected; JLC stock ok for 200.
2026-11-03 Firmware: hold the power key 3 s to switch proto 0 off ([ambire_power]); proto 0 notes: no brown-out on USB plug/unplug, USB does not switch it on
2026-11-03 firmware/README: the power-off notes scoped to proto 0
2026-11-08 Pin-1 marks JLC can read: U2 and SW_JOY, plus a pre-fab gate for every polarized part
    JLC held SMT026110264245 (2026-11-04) to ask about the polarity of U2 and SW_JOY.
    The LTC3539 boost U2 had no silk at all on a 180-degree-symmetric DFN land; the
    joystick SW_JOY's pin-1 dot (EasyEDA's) was 0.12 mm across and as far from pad 3
    as from pad 1, on an outline that is the same turned 180 degrees.
    - U2: a filled triangle at pin 1, inside its courtyard, 0.2 mm from the pad.
    - SW_JOY: the speck replaced by a 0.36 mm dot beside pad 1, outside the body
    (JLC's 2D overlay would cover a mark under it), 0.28 mm from the radio's pads.
    Board and wallet.pretty updated alike; DRC 0 at every severity, as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
2026-11-09 Steel spacers: Würth's 3.0 mm NPTH restored (their spigot drops into it); checkParts gates holes
    The WA-SMSI 9774015243R has a 2.8 x 1.4 mm spigot under its flange. Its footprint left the
    datasheet's 3.0 mm NPTH out as "no screw", so the spacers sat on their spigots, not their
    flanges. MH_PK1/2 get the hole back; the front tracks under them move clear: the radio UART
    pair, CELL_N_SENSE, VBUS_SENSE and AIRGAP slide 1.4 mm north at MH_PK1 (fewer jogs), BAT
    steps 0.45 mm south-west at MH_PK2. DRC empty at every severity (as saved and refilled),
    0 unconnected; routeDefects, placementScan, checkFpc, cleanCopper unchanged.
    checkParts.py now compares drilled holes against JLC's land (pad count to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
2026-11-09 Firmware: QR camera test behind the home screen's swipe up ([ambire_camera]); works on proto 0's OV2640
    - Kernel driver (io/camera/stm32u5/camera.c): powers the module (CAM_EN,
    RESET), XCLK 20 MHz from TIM3_CH2, SCCB on I2C2 (reads as two
    transactions: SCCB parts do not take a repeated start), DCMI snapshots
    by GPDMA1 channel 7 into a buffer the app owns. Finds an OV2640 at 0x30,
    or a GC2145 / OV5640 at 0x3C, by chip id; three zoom levels per sensor,
    each one of esp32-camera's modes (tables generated, never hand-typed:
    bringup/camera/). VSYNC polarity measured on the pins at start-up.
    - Five syscalls (open, close, set zoom, capture, status); the capture's
    buffer is checked to b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
2026-11-09 Firmware: the swipe up follows the airgap switch ([ambire_airgap]): QR camera on AIR, Bluetooth pairing off AIR
    The kernel reads AIRGAP_SENSE (PE7 on proto 0, high on AIR) for one new
    syscall; the home screen asks it on each swipe up.
2026-11-09 Firmware: Trezor's name and logo off the screens and USB strings (ambire_p0)
    - Translations: ambire_strings.rs (new, [ambire_branding]) rewords the 24
    English strings Delizia shows that name Trezor, Trezor Suite or trezor.io
    ("Ambire", "the Ambire app", ambire.com). TranslatedString::translate asks it
    before the built-in English and any blob, so en.json and the generated
    tables stay as upstream has them (a 5-line hook).
    - Bootloader (Rust, [ambire_branding]): welcome "with your Ambire at
    ambire.com", "REBOOT AMBIRE", "Resetting Ambire", the reset results.
    - Board header: MODEL_USB_INTERFACE ("Ambire Interface"), MODEL_WEBUSB_URL
    (ambire.com, the landing page of a bootloader witho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
2026-11-09 Firmware: BC-UR without a heap (ambire_ur.rs), tested against the Ambire app's own streams
    The QR transport of airgapped signing, for [ambire_camera]: "ur:type/body"
    and "ur:type/seq-len/body" in any case, minimal bytewords with their CRC32,
    the multi-part CBOR [seqNum, seqLen, messageLen, checksum, fragment], and the
    fountain decoder (Xoshiro256** seeded from SHA-256, Vose alias sampling of
    the degree, shuffled fragment choice, as @ngraveio/bc-ur 1.1.13 does it).
    Hostile input: every length, index and count is checked before use; anything
    malformed, any part disagreeing with the first, a message over 16 KiB or 128
    parts, a failed message checksum or non-zero padding ends the stream with an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
2026-11-09 Firmware: airgapped signing with the Ambire app over QR codes ([ambire_camera])
    On AIR, the home screen's swipe up opens an airgap menu (Python,
    src/apps/ambire_airgap): Scan request, Connect to Ambire, Camera test.
    Protocol: Keystone's BC-UR, as the app implements it.
    - Connect: a one-part crypto-hdkey of m/44'/60'/0' (key, chain code, origin
    with the master fingerprint, parent fingerprint, children 0/*, name
    "Ambire").
    - Scan (Rust, ambire_airgap.rs): camera + quirc + ambire_ur.rs in the UI
    image buffer (no heap), progress bar, zoom on tap, cancel; returns the UR's
    type and CBOR, or why the scan failed. The camera test is now a screen of
    its own in the menu, no longer inside the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
2026-11-09 Firmware: home screen shows AIR or the Bluetooth state (off, not paired, pairing, ready, connected)
    ambire_status.rs: a one-line status in the top-right corner, re-read once a
    second and on Bluetooth events, repainted only when it changes. The owner
    could not tell from the home screen whether the device was paired or
    connected.
2026-11-09 firmware/README: proto 0 bring-up complete; how to drive Bluetooth from a computer
    - Proto 0 bring-up: every part the firmware drives works on the board (owner,
    2026-11-09), with dates; the charger and battery gauge are not driven by the
    firmware, the OPTIGA is not fitted, airgapped QR signing has not run on the
    board yet.
    - Bluetooth: works on proto 0 (bonding, THP, signing); the home screen's
    status line; the two pairings in order; trezorctl over BLE step by step;
    the macOS traps (pairing prompt only with Bluetooth settings open, the link
    dies with the process holding it, keychain prompts, stale credentials).
2026-11-09 Repo hygiene: ignore Python caches, KiCad local state and history, agent worktrees; pack_clips project file tracked like the other boards'
2026-11-09 Airgap security review fixes: typed data bound only by what it signs; camera off when the app ends
    From an independent audit of the camera, UR, request and signing code (no
    critical or high findings; compared with Keystone, Keycard Shell, SeedSigner,
    Jade, Passport; quirc/BC-UR/wallet advisories checked):
    - MEDIUM, typed data: the chain check read domain.chainId from the JSON even
    when EIP712Domain did not declare it, and undeclared domain values are never
    hashed: a signature could pass the check yet bind no chain. Now a domain
    value EIP712Domain does not declare is refused, the chain comes only from a
    declared chainId, and a request naming a network needs typed data that
    declares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
2026-11-12 Firmware: camera XCLK probe samples unevenly (a fixed loop locked onto the 20 MHz phase and read ~0 edges)
    Seen on proto 0 with Camemake GC2145/OV5640 modules: the probe read 2 while
    XCLK ran; spaced unevenly it reads ~10000 of 20000 samples.
2026-11-12 Firmware: camera switched off when no sensor answers (was left powered for measuring)
    A camera supply regulator ran hot on proto 0 with Camemake GC2145/OV5640
    modules that never answered on SCCB: the failure screen kept the rail loaded.
2026-11-13 Case fits for resin: 0.1 mm sliding/snapping (was FDM's 0.2), print notes for MSLA flat on the plate
    The case is printed on an Anycubic Photon Mono M7 Pro in clear ABS-like resin. FIT 0.2 -> 0.1
    (tongue in skirt, north hook), the airgap slider's window 0.15 -> 0.1. The pack board's
    clearance in the tray and bay stays 0.1 per side as PACK_PCB_CLR (it is the board's outline
    tolerance, not a print fit). Regenerating also refreshes the v4 page's board/BOM data, stale
    since the steel spacers' NPTH came back (4340913).
2026-11-14 Case sliced for the Photon Mono M7 Pro: enclosure/slice_resin.py -> enclosure/out/case.pwsz
    Layers are the case layout's mid-layer sections, filled into the 13312 x 5120 LCD (16.8 x 24.8 um),
    centred; UVtools 7.1.2 packs them into .pwsz. Its generic resin block is replaced by Photon
    Workshop 4.2.0's own M7 Pro profile (enclosure/resin/), active preset ABS-like Resin Pro 2 /
    ACF / normal: 0.05 mm, 1.8 s, 5 bottom layers at 25 s, 15 transition layers, 8 mm lift at 6 mm/s.
    Checked by converting the .pwsz back to PNG layers: same areas, 134 layers, 13.7 ml. Not yet
    compared against a .pwsz Photon Workshop writes (mirroring, anti-aliasing).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
2026-11-14 Resin slicer writes .pwsz as Photon Workshop does (vector layers), no UVtools; fixes a Y mirror
    Checked against a .pwsz Photon Workshop 4.2.0 sliced from the same case.stl: the previous file's
    layers were mirrored in Y (the case would have printed mirrored), and UVtools stored the layers as
    .pw0Img bitmaps where Photon Workshop stores .pwszImg outline segments. The slicer now writes every
    entry itself: each layer's outlines in mm from the plate's centre (solid clockwise, holes
    anticlockwise, sorted by y, low end first), scene.slice, calc_layer_volumes.data, the per-layer
    exposures as Photon Workshop lists them (bottom, then normal), and its M7 Pro profile unchanged.
    Against the reference: id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
2026-11-14 Resin print: the case halves alone (halves.stl -> halves.pwsz), bottom exposure 18 s x 4 layers
    generate.py also lays out the shell and the bezel alone (out/halves.{stl,3mf}); the joystick cap
    and the airgap slider print separately. slice_resin.py takes --bottom-time / --bottom-layers and
    stores the changed preset as a user resin under the same name, as Photon Workshop stores an
    edited preset; halves.pwsz is sliced at 4 x 18 s (Anycubic's preset: 5 x 25 s) for an easier
    release from the plate and less flare on the plate-side faces. Both halves rest on near their
    whole footprint (first layer ~0.9 of the largest), so the grip margin holds; the cap, which
    stands on 11 mm2 under a 50 mm2 pad, wa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
2026-11-14 Joystick cap: flat pad, printed pad-down on the plate (was on its 11 mm2 sleeve under a 50 mm2 pad)
    The dish and dot become a flat top with a 45 deg chamfer and a 45 deg centre
    dimple, so the cap prints upside down with its largest layers on the plate
    (first layer 39 mm2 of 50) and everything above narrowing; the socket opens
    upward, no bridge. Fit, tilt stop (6.3 deg) and push travel unchanged.
2026-11-14 Resin slicer: --lift-speed; halves.pwsz lifts at 1 mm/s (was the preset's 6)
    The first flat print tore a wall off its face halfway up. The bezel prints as
    a tray whose cavity is sealed against the film from 1.0 to 4.75 mm (no wall
    opening until its rim; its face holes are closed by the plate), up to 6x the
    wall area it pulls on; the shell's cavity vents through a wall opening from
    1.3 mm. A slower lift lets resin refill the pocket instead of sucking on it.
    Print-time estimate now uses the down speed for the return.
2026-11-14 Bezel prints vented: a slot in the south wall, skirt root filleted; resin bottom 3 x 15 s
    The first flat resin print tore the bezel's skirt off at its root: printed face
    down, its inside was sealed against the film from 1.0 to 4.75 mm, pulling on up
    to 6x its own wall area. Now:
    - a 3 x 1 mm vent slot through the south wall into the chin's pocket, flush with
    its ceiling, placed clear of USB-C, the screw boss and the joystick: the inside
    is open to the vat from 2.0 mm of print height on (sealed band left: 1.0-2.0 mm,
    1.7x the wall area);
    - a 0.5 mm 45 deg fillet where the skirt meets the tongue's slot, the shell
    tongue's outer top edge chamfered to clear it by the fit (not along the h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
2026-11-14 Bezel: vents in every wall (8 slots), chin pocket ceiling chamfered; resin exposure 2.1 s
    The bezel's inside is one hollow: each vent relieves all of it, and their total
    area sets how fast resin refills it on a lift. Two 3 mm slots per wall, clear of
    USB-C, the airgap slider, the screw boss and the joystick; north, east and west
    open into the screen's pocket up to 0.3 mm under its seat, so the bezel prints
    sealed only from 0.8 to 1.1 mm (was 1.0 to 4.75). The chin pocket's ceiling meets
    its walls in a 0.5 mm chamfer, cut back over every part's keep-out.
    halves.pwsz: normal layers 2.1 s (preset 1.8), bottom 3 x 15 s, lift 1 mm/s;
    slice_resin.py gains --exposure.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
2026-11-14 Bezel vents flush with the screen's seat: open from the first layer after the face
    A vent relieves only the layers printed after it exists. The north/east/west
    vents now reach the face's underside (was 0.3 mm short) with 0.4 mm corners, so
    nothing of the bezel's inside is sealed against the film after the face.
    UVtools' suction-cup check agrees: the cup over layers 16-106 in the print that
    tore is gone; left are the screen window's hole while the face prints (layers
    0-15, against the plate, as in the print that tore) and the same small holes.
